Ayusha343/battery-pack-engineering/Media/20260910_121030.jpg

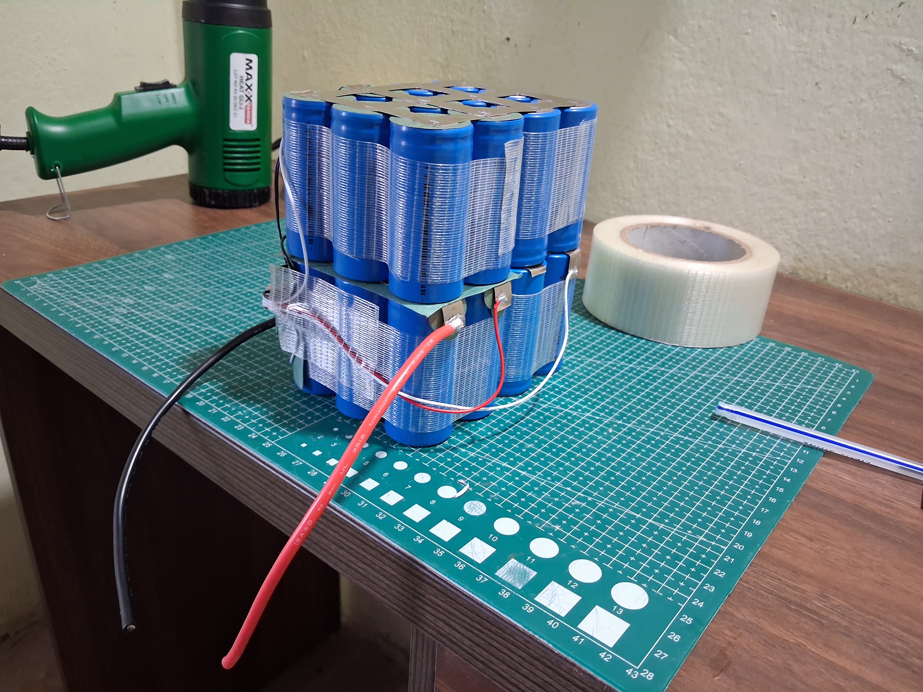
Media/20260910_121030.jpg
