Ayusha343/battery-pack-engineering/Docs/Progess_Technical_Roadmap.pptx

## Progress & Technical Roadmap

Custom NMC & LFP Pack Engineering, Field Validation, and Lab Capabilities

## Progress Report

## NMC EV Battery Pack

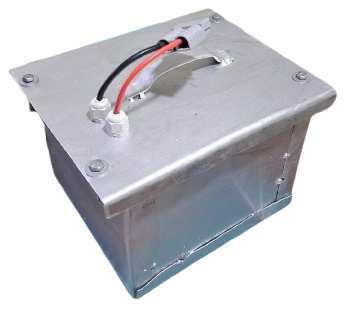
[picture p3: figure]

Pricing

Problem statement

Prototyping cost: 31,080 /-
Estimated cost: 26,599 /-

16S7P: 60V 35Ah - 2.1 kWh

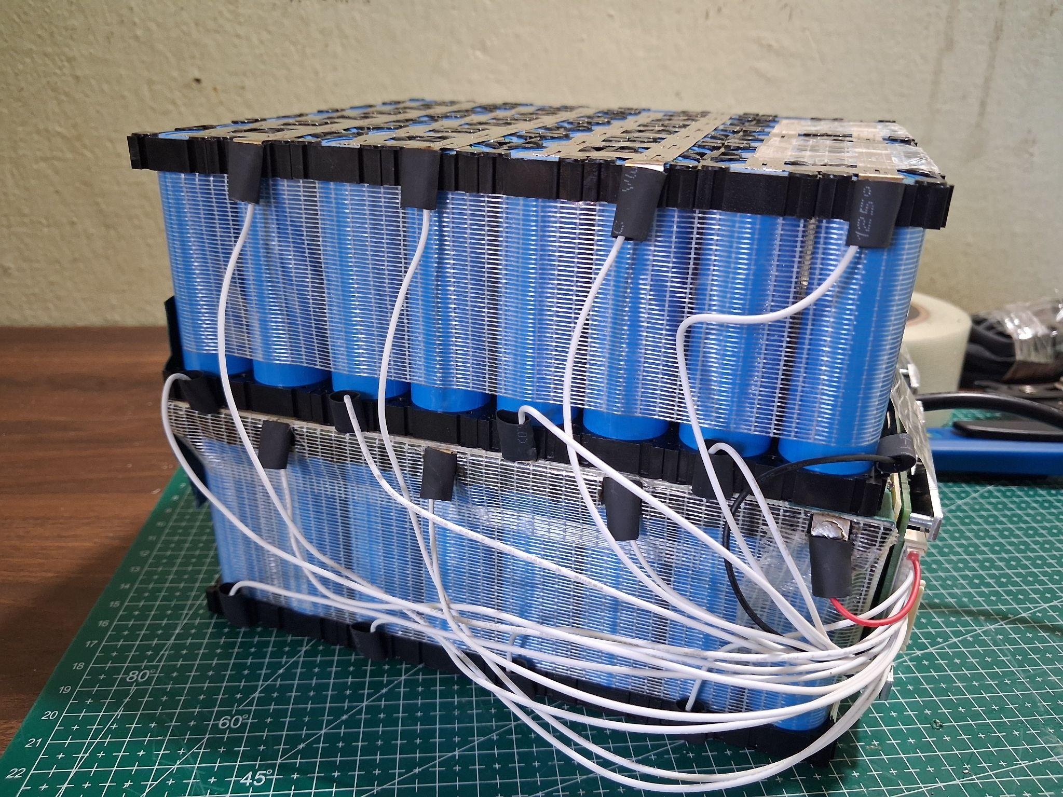
[picture p4: figure]
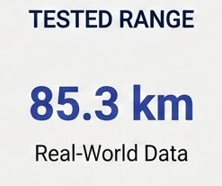
[picture p5: figure]

## LFP Solar Battery Pack

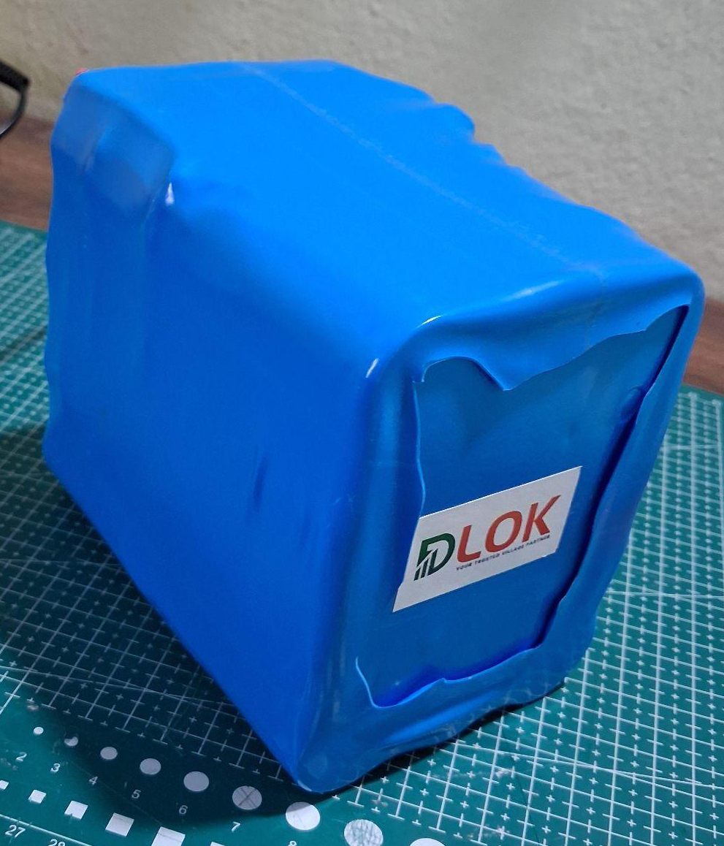
[picture p6: figure]
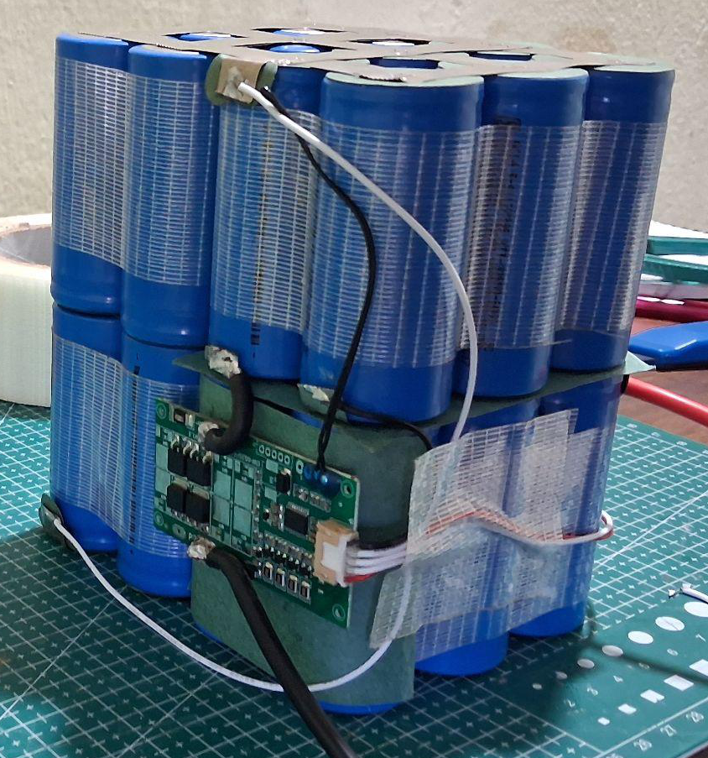
[picture p7: figure]

Pricing

Problem statement

Prototyping cost: 3,949 /-
Estimated cost: 3,800 /-

4S6P: 12.8V 36Ah - 460 Wh

Backup

Calculated Time: 11 Hrs @ 40W

## Lab Setup

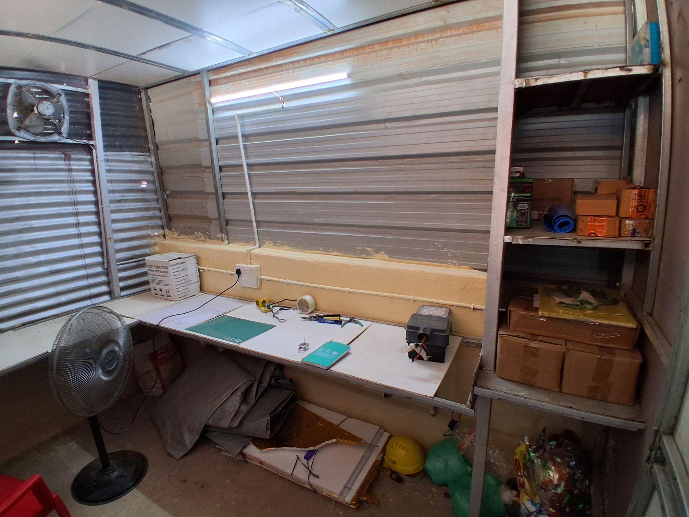
[picture p8: figure]

## Upcoming Projects

## DC Energy Meter & Logger

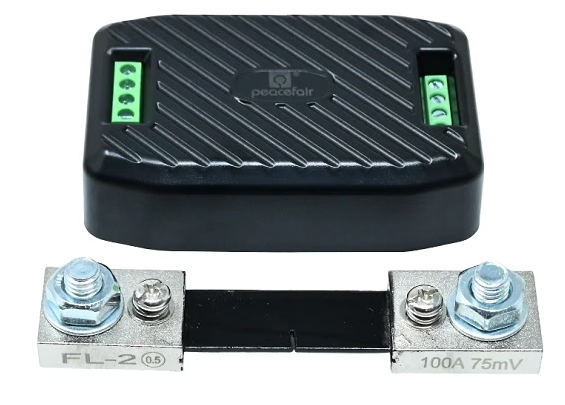
[picture p9: figure]
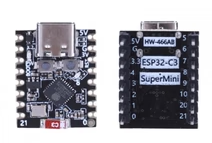
[picture p10: figure]
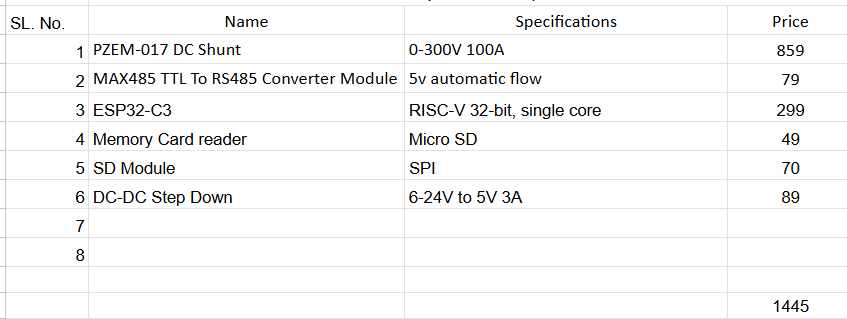
[picture p11: figure]

## LFP EV Battery Pack

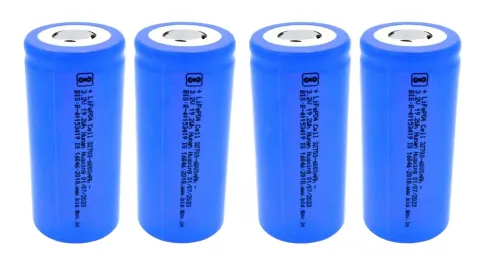
[picture p12: figure]

Pricing

Problem statement

Prototyping cost: 23,500 /-
Estimated cost: 23,000 /-

19S3P: 60V 18Ah - 1.1 kWh

19S6P: 60V 36Ah - 2.2 kWh

Range

Calculated Range: 95-100 km

19S3P: 60V 18Ah - 1.1 kWh

## Semi-Integrated Solar Light

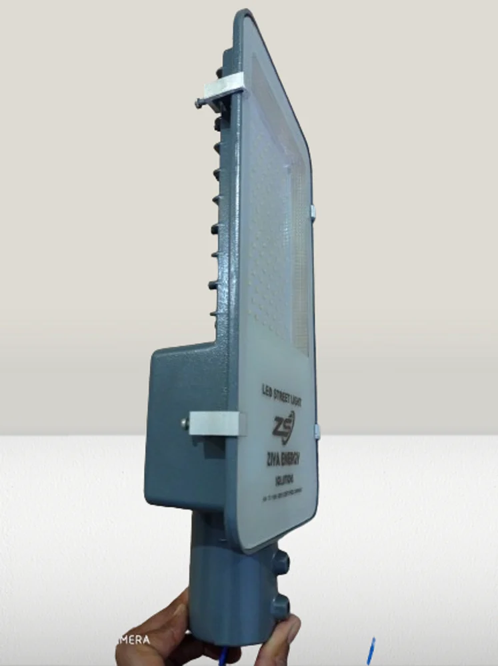
[picture p13: figure]

Pricing

Problem statement

Prototyping cost: 7,000 /-
Estimated cost: 6,500 /-

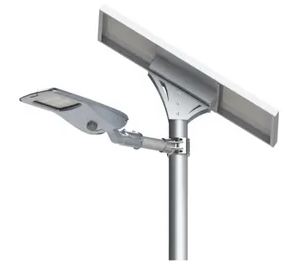
[picture p14: figure]

4S6P: 12.8V 36Ah - 460 Wh

Backup

Calculated Time: 11 Hrs @ 40W

## Suggested Roadmap

## Slide 11

Will help to collect Voltage, Current, Power [IN & OUT] data

Run a complete range test with Power Logger

Submit project documentations & SOPs

Power Logger

EV LFP 36Ah Pack

EV Battery pack testing

Solar LFP pack testing

Documentation

Make two packs of 18Ah 60.8V

Run test for few days with Power Logger data

## Thank You
