Ayusha343/battery-pack-engineering/Charts/Ayushman Sahoo - 2026-07-12 18.56.52.jpg

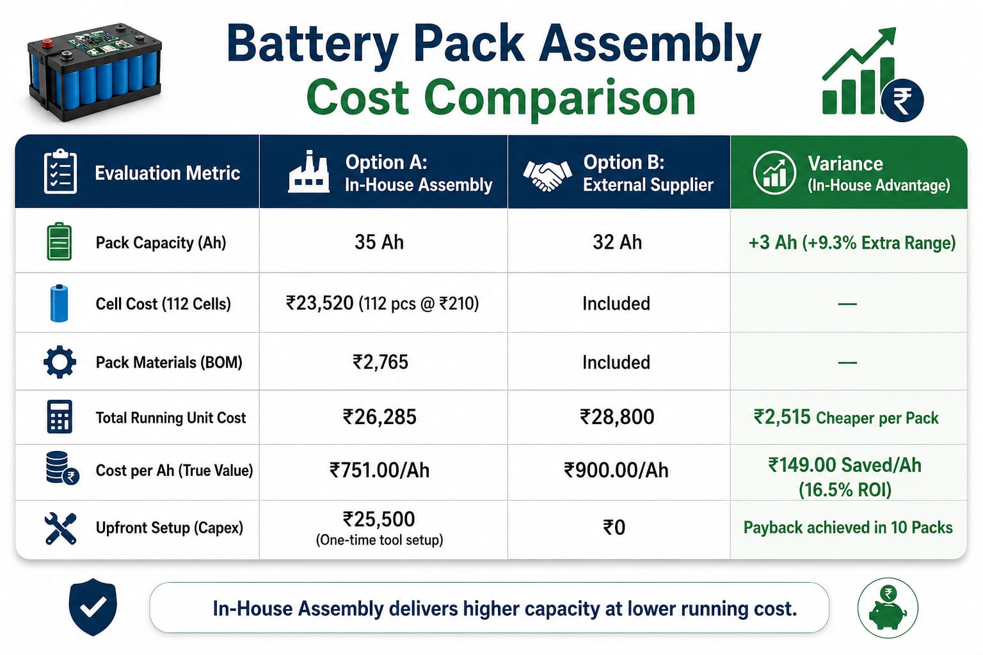
Charts/Ayushman Sahoo - 2026-07-12 18.56.52.jpg
