Ayusha343/battery-pack-engineering/Charts/Ayushman Sahoo - 2026-07-12 18.57.04.jpg

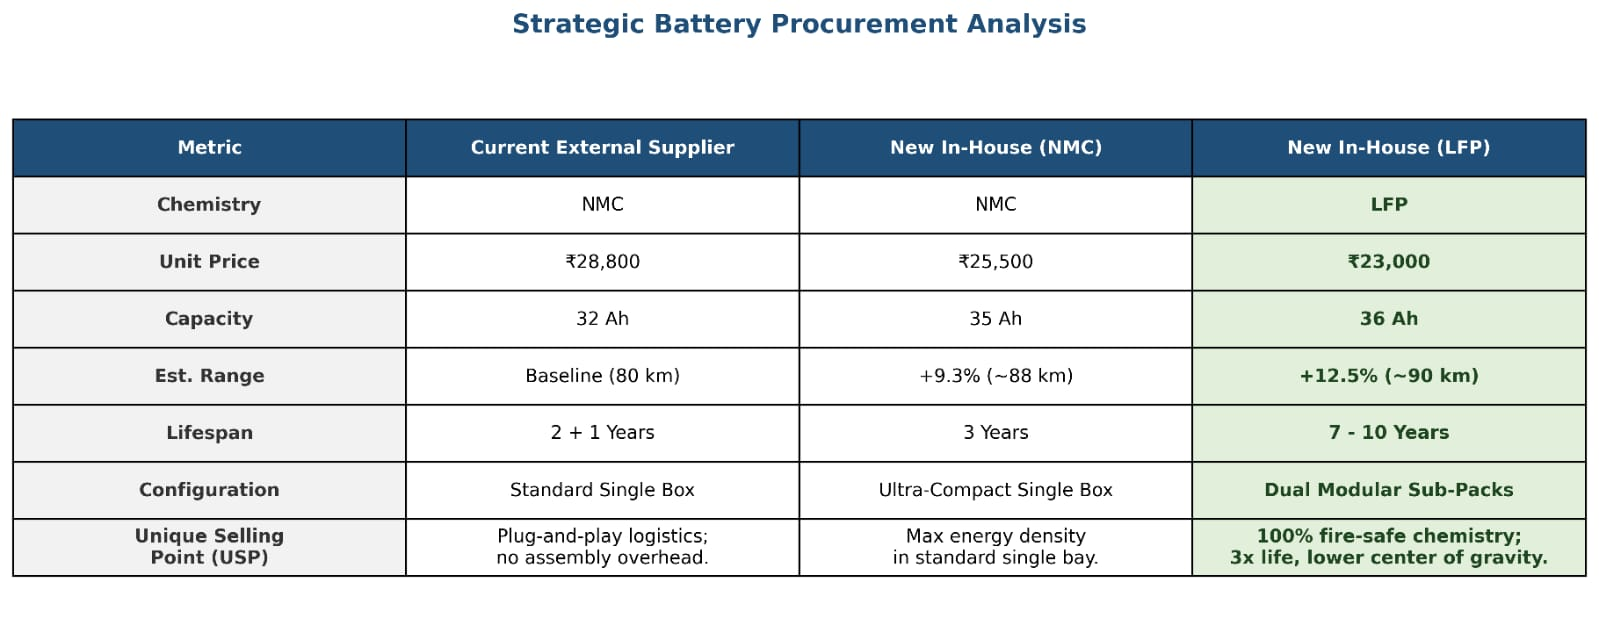
Charts/Ayushman Sahoo - 2026-07-12 18.57.04.jpg
