Ayusha343/battery-pack-engineering/Charts/ChatGPT Image Jul 13, 2026, 12_21_11 AM.png

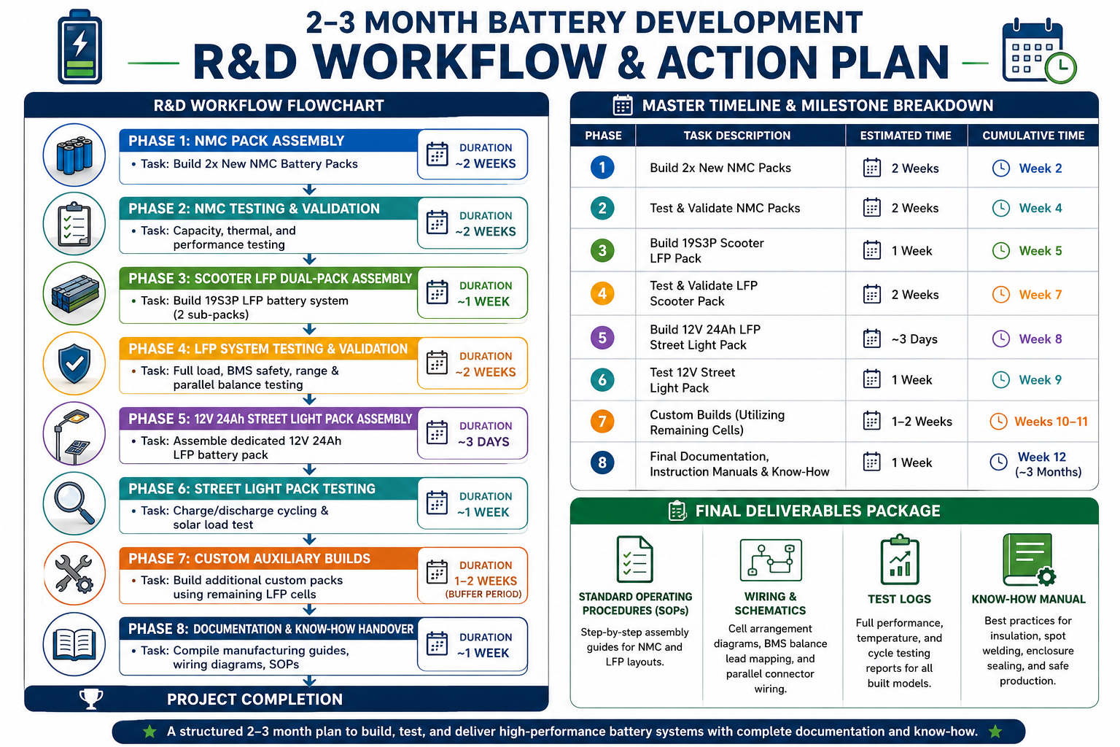
Charts/ChatGPT Image Jul 13, 2026, 12_21_11 AM.png
