Ayusha343/battery-pack-engineering/Charts/Code_Generated_Image (2).png

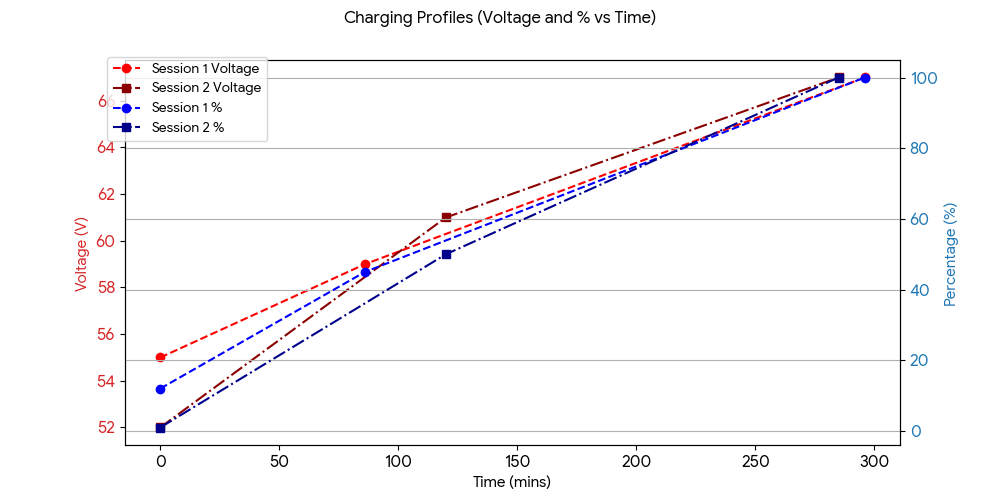
Charts/Code_Generated_Image (2).png
