Ayusha343/battery-pack-engineering/Charts/Code_Generated_Image.png

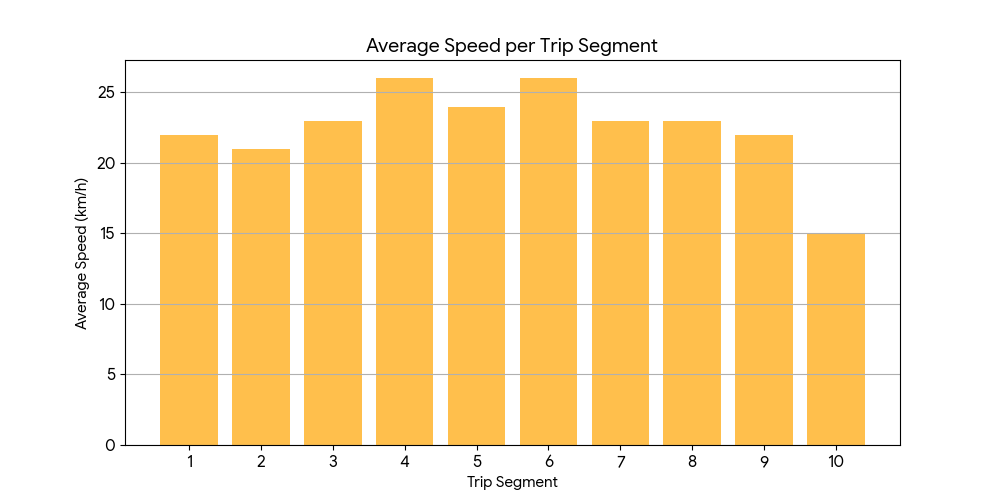
Charts/Code_Generated_Image.png
