Ayusha343/battery-pack-engineering/Invoices/Screenshot 2026-07-09 173721.png

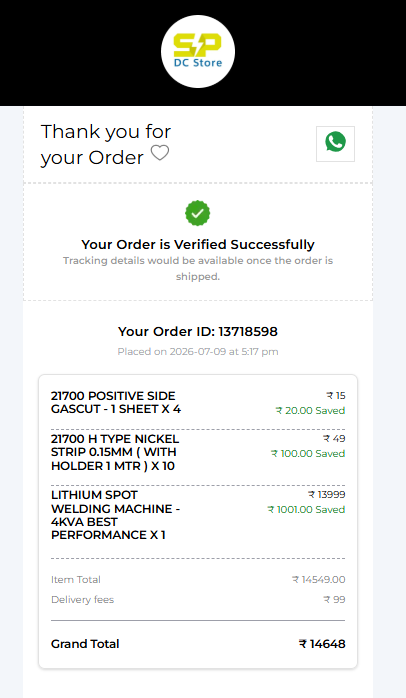
Invoices/Screenshot 2026-07-09 173721.png
