Ayusha343/battery-pack-engineering/Invoices/Screenshot 2026-07-09 174720.png

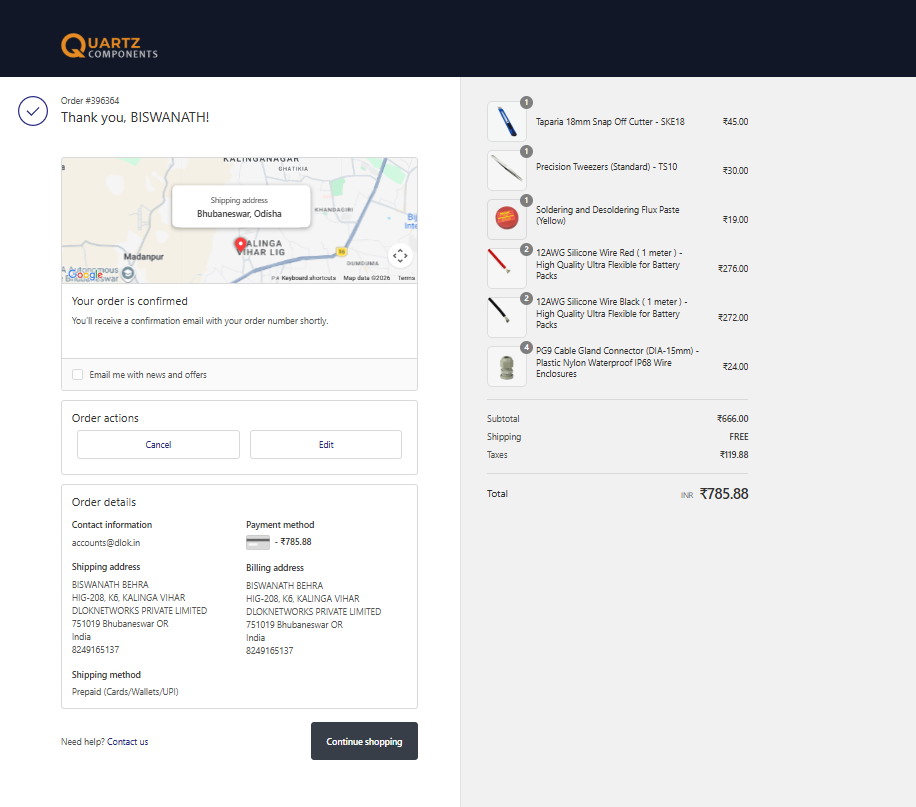
Invoices/Screenshot 2026-07-09 174720.png
