Ayusha343/battery-pack-engineering/Invoices/Screenshot 2026-07-09 174733.png

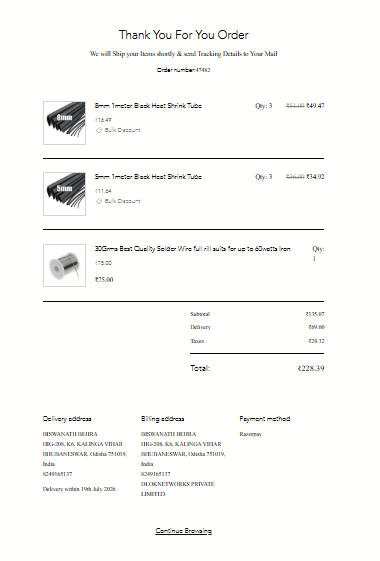
Invoices/Screenshot 2026-07-09 174733.png
