Ayusha343/battery-pack-engineering/Invoices/Screenshot 2026-07-13 133432.png

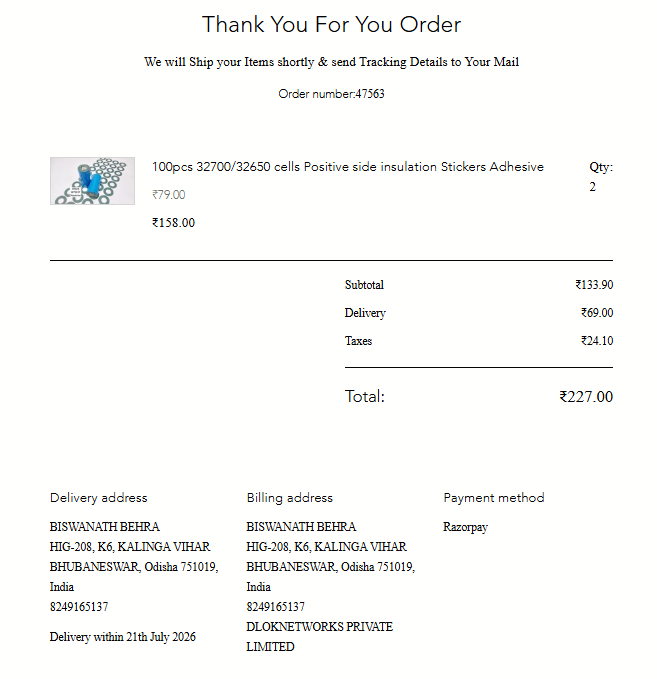
Invoices/Screenshot 2026-07-13 133432.png
