Ayusha343/battery-pack-engineering/Invoices/Screenshot 2026-07-15 133346.png

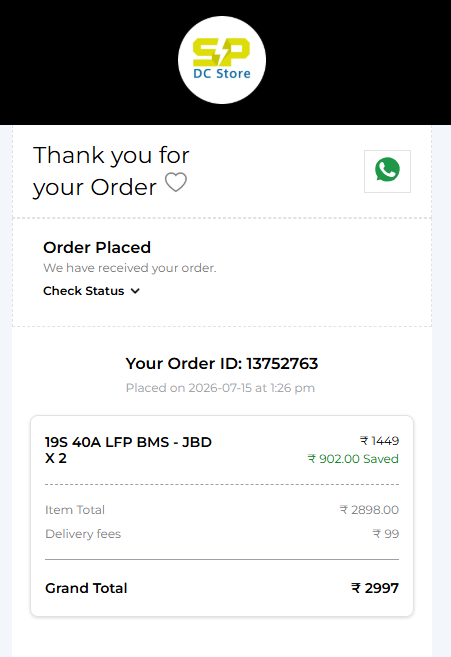
Invoices/Screenshot 2026-07-15 133346.png
