Ayusha343/battery-pack-engineering/Invoices/Screenshot 2026-08-13 130806.png

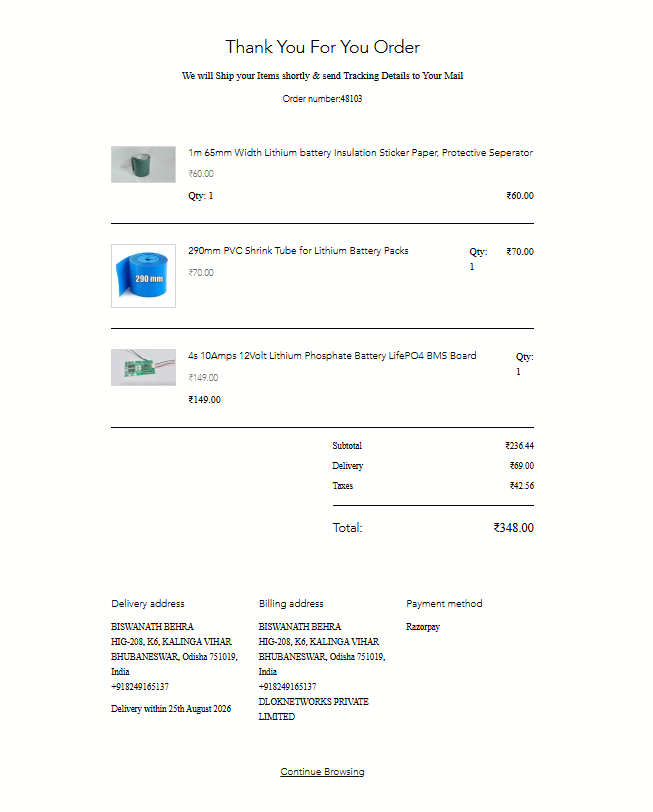
Invoices/Screenshot 2026-08-13 130806.png
