Ayusha343/battery-pack-engineering/Media/20260719_194118.jpg

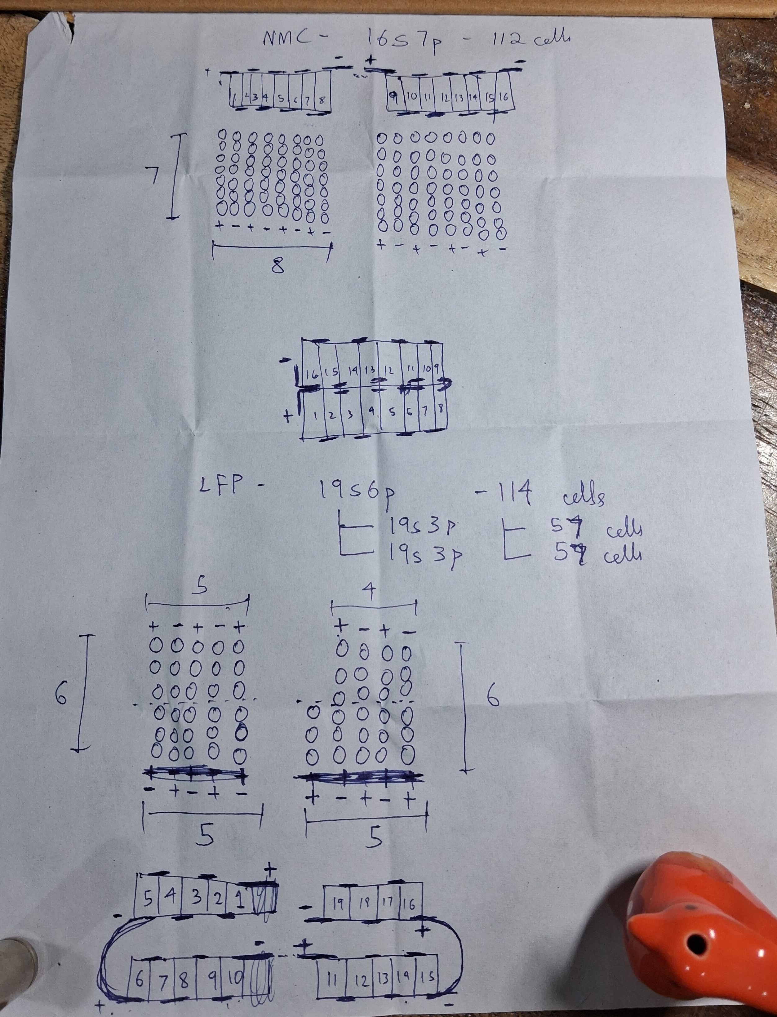
Media/20260719_194118.jpg
