Ayusha343/battery-pack-engineering/Media/20260722_124656.jpg

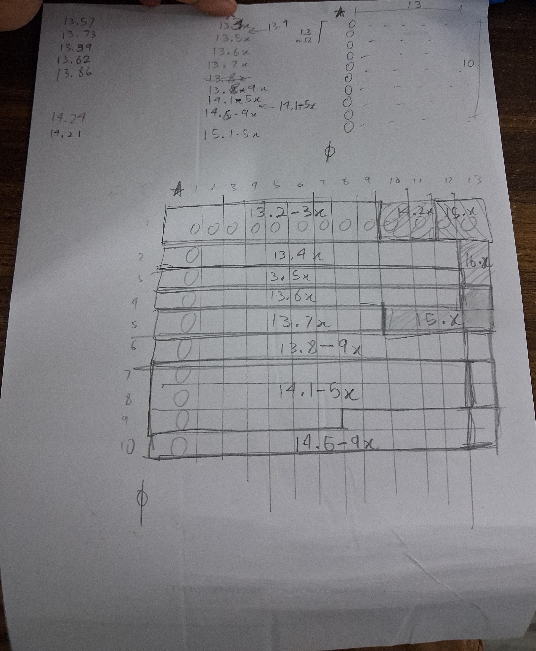
Media/20260722_124656.jpg
