Ayusha343/battery-pack-engineering/Media/20260722_135739.jpg

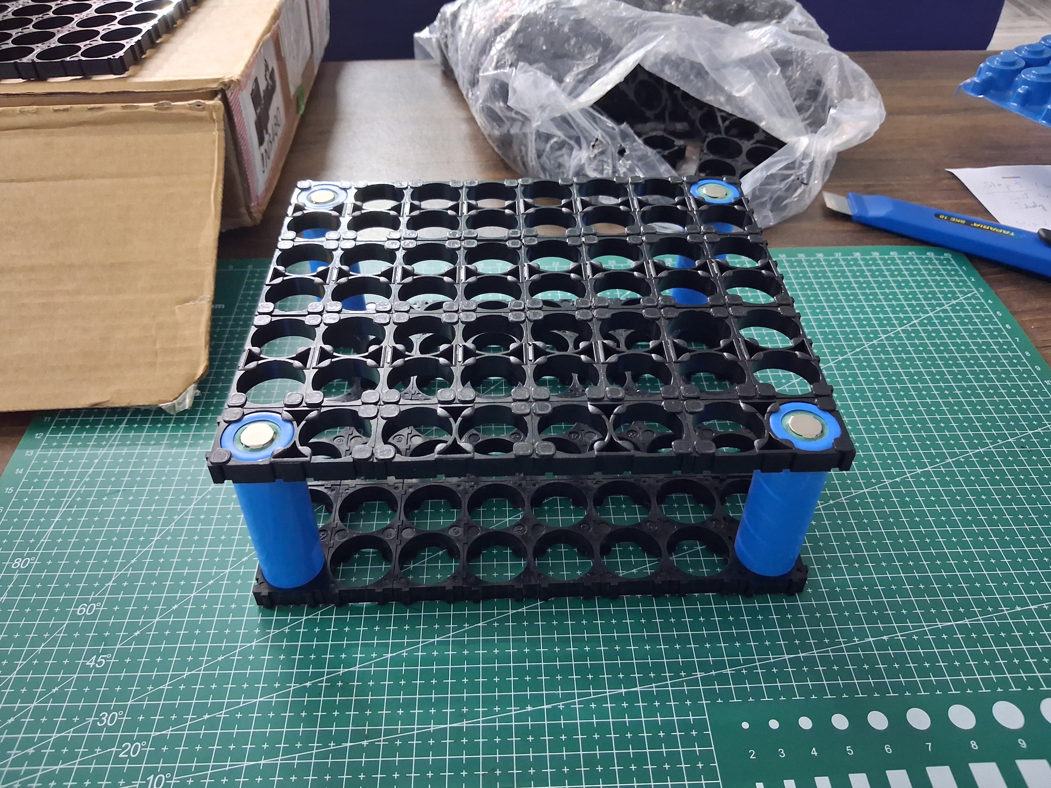
Media/20260722_135739.jpg
