Ayusha343/battery-pack-engineering/Media/20260722_140135.jpg

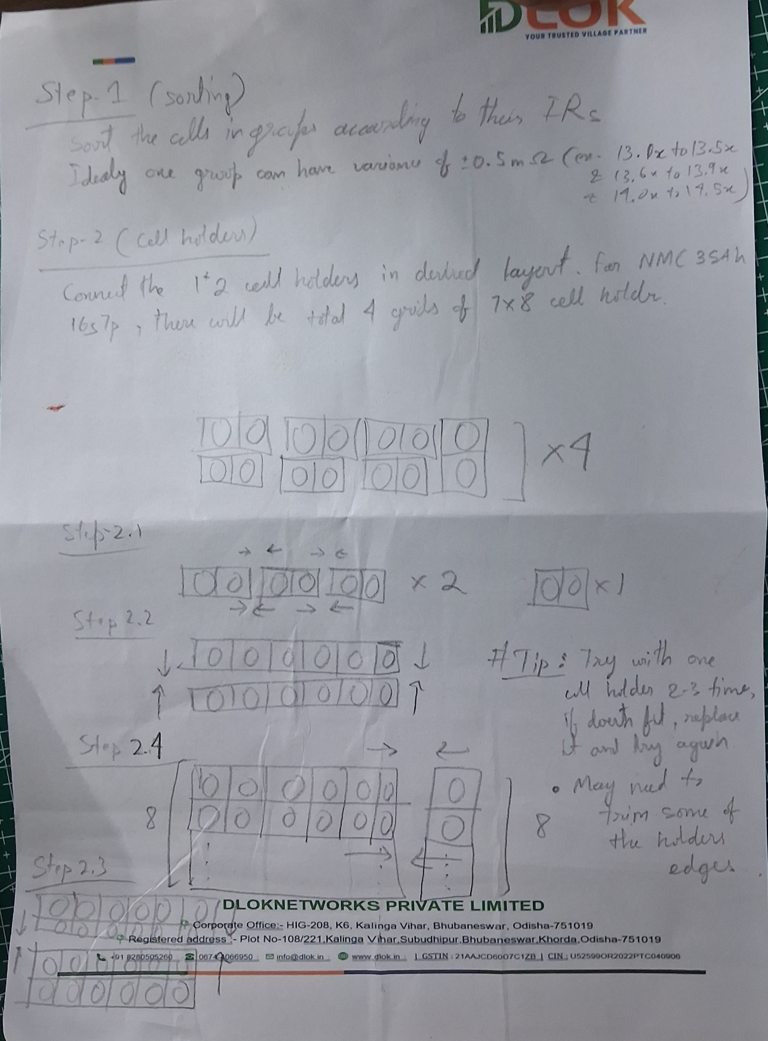
Media/20260722_140135.jpg
