Ayusha343/battery-pack-engineering/Media/20260727_133029.jpg

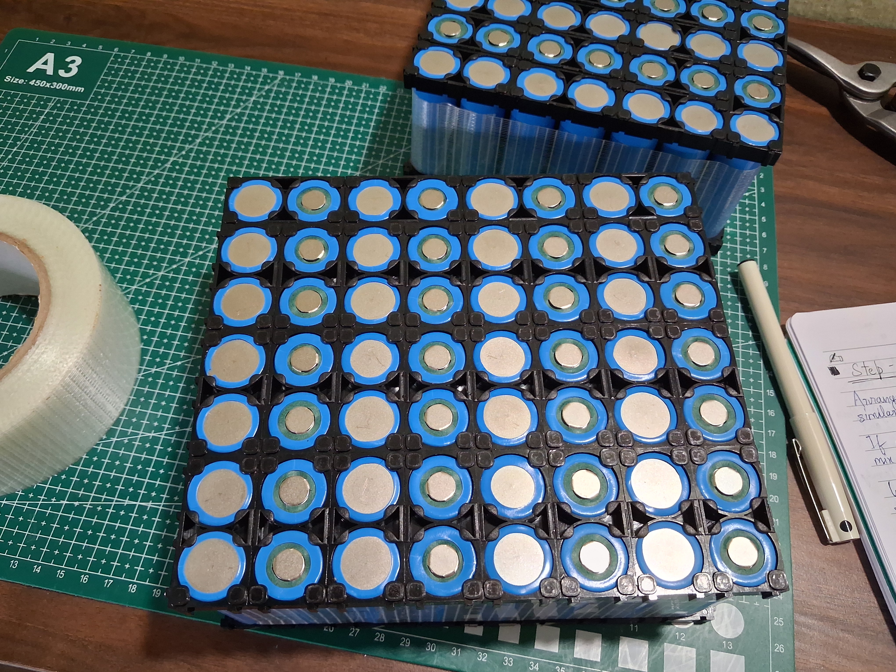
Media/20260727_133029.jpg
