Ayusha343/battery-pack-engineering/Media/20260728_140951.jpg

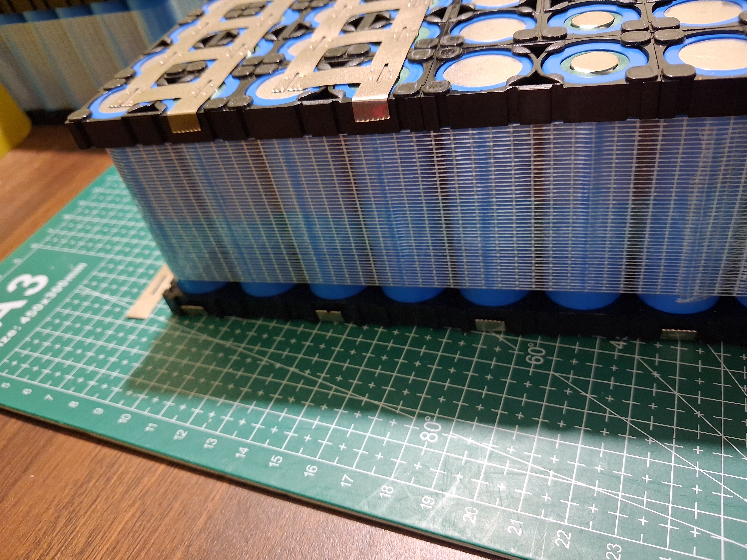
Media/20260728_140951.jpg
