Ayusha343/battery-pack-engineering/Media/20260728_141614.jpg

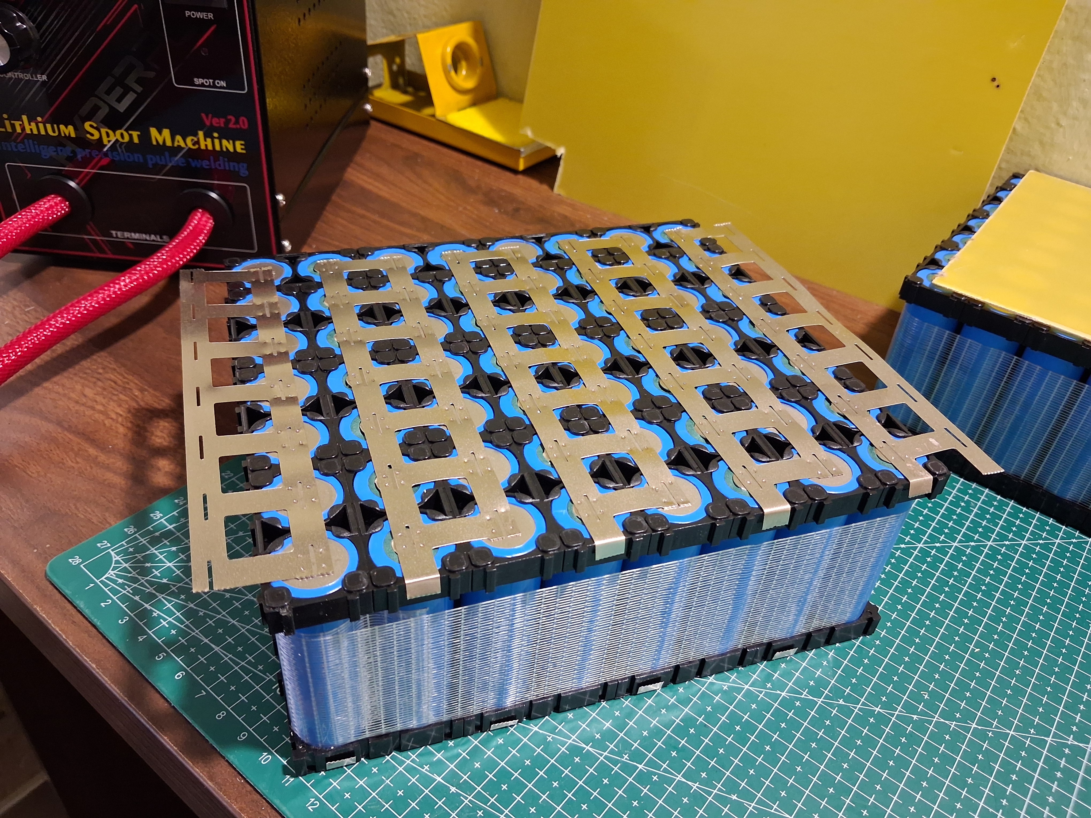
Media/20260728_141614.jpg
