Ayusha343/battery-pack-engineering/Media/20260728_141623(0).jpg

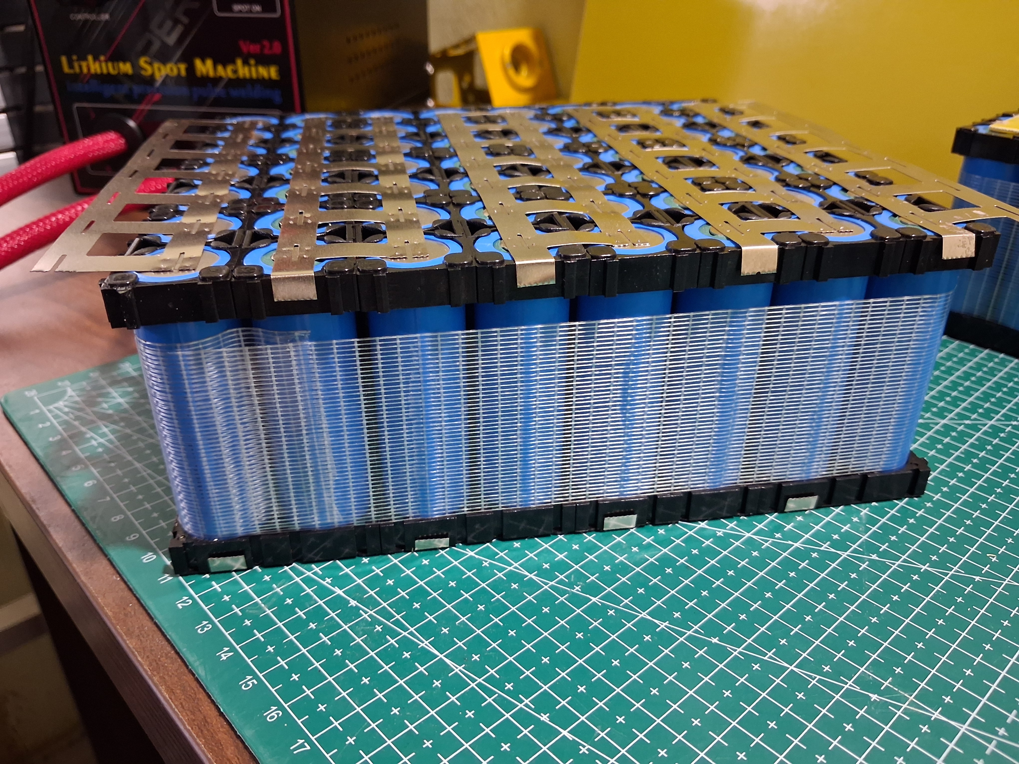
Media/20260728_141623(0).jpg
