Ayusha343/battery-pack-engineering/Media/20260729_121017.jpg

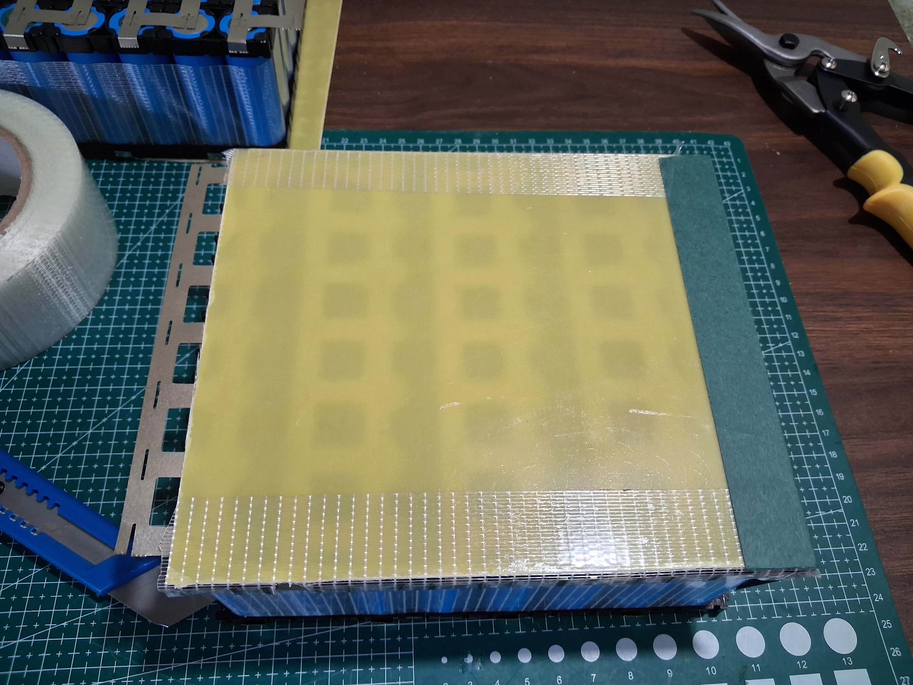
Media/20260729_121017.jpg
