Ayusha343/battery-pack-engineering/Media/20260729_121023.jpg

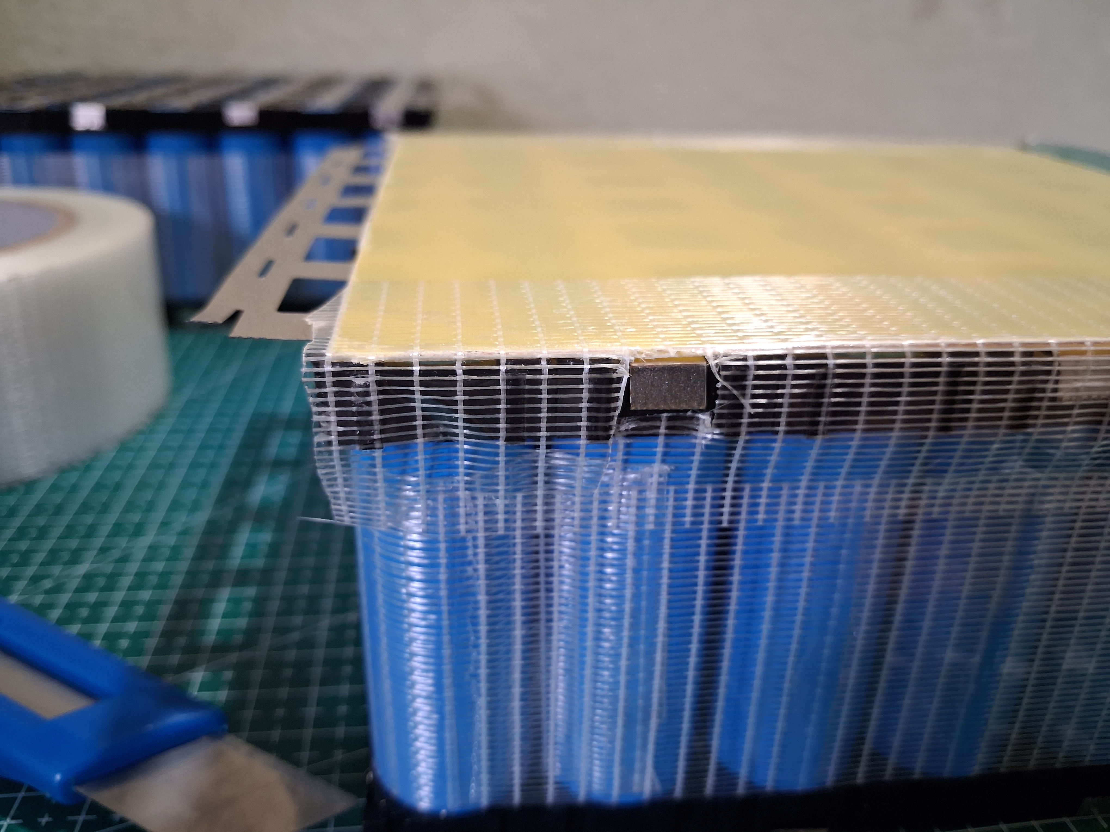
Media/20260729_121023.jpg
