Ayusha343/battery-pack-engineering/Media/20260729_121026.jpg

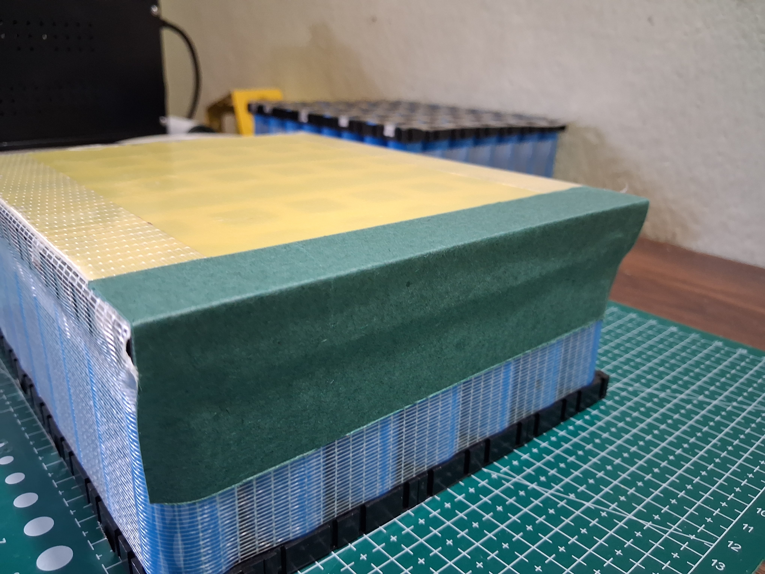
Media/20260729_121026.jpg
