Ayusha343/battery-pack-engineering/Media/20260729_122357.jpg

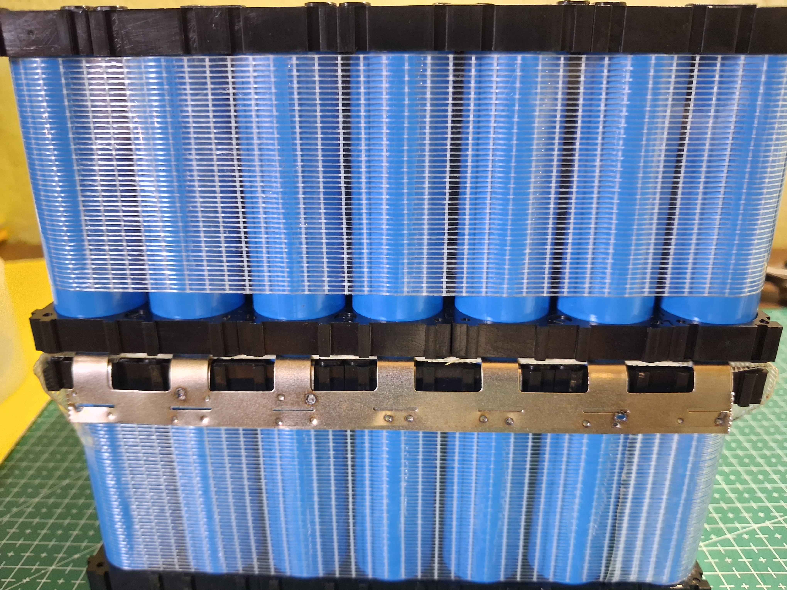
Media/20260729_122357.jpg
