Ayusha343/battery-pack-engineering/Media/20260729_122847.jpg

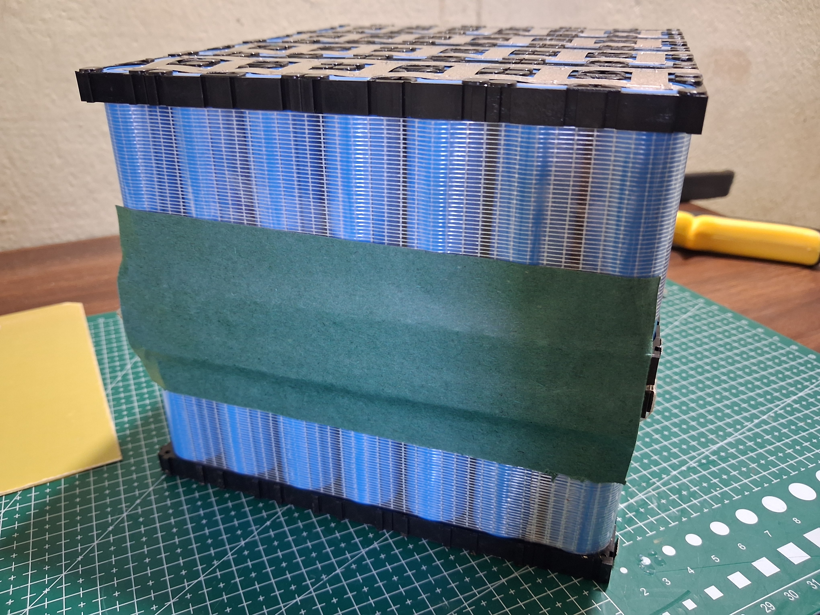
Media/20260729_122847.jpg
