Ayusha343/battery-pack-engineering/Media/20260729_123937.jpg

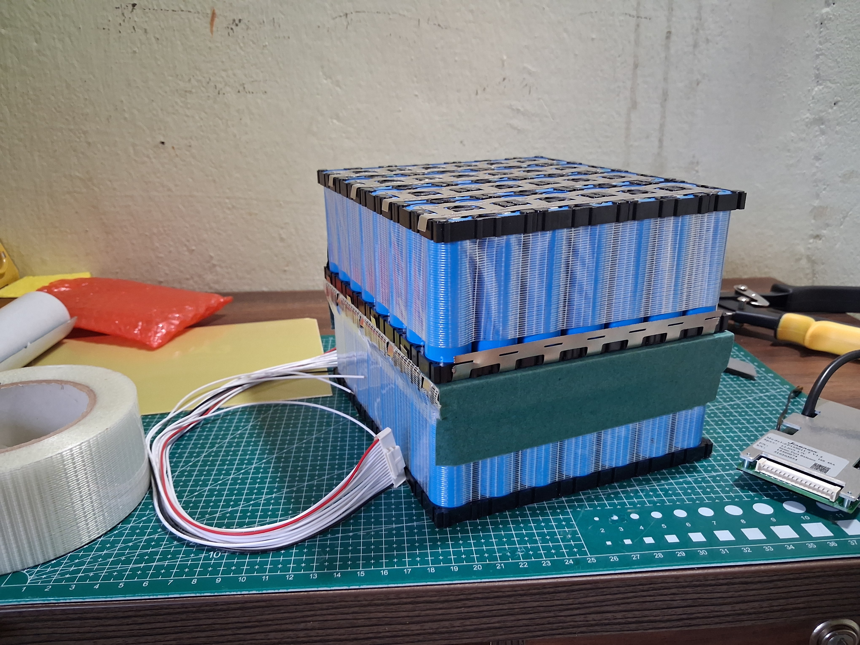
Media/20260729_123937.jpg
