Ayusha343/battery-pack-engineering/Media/20260729_141145.jpg

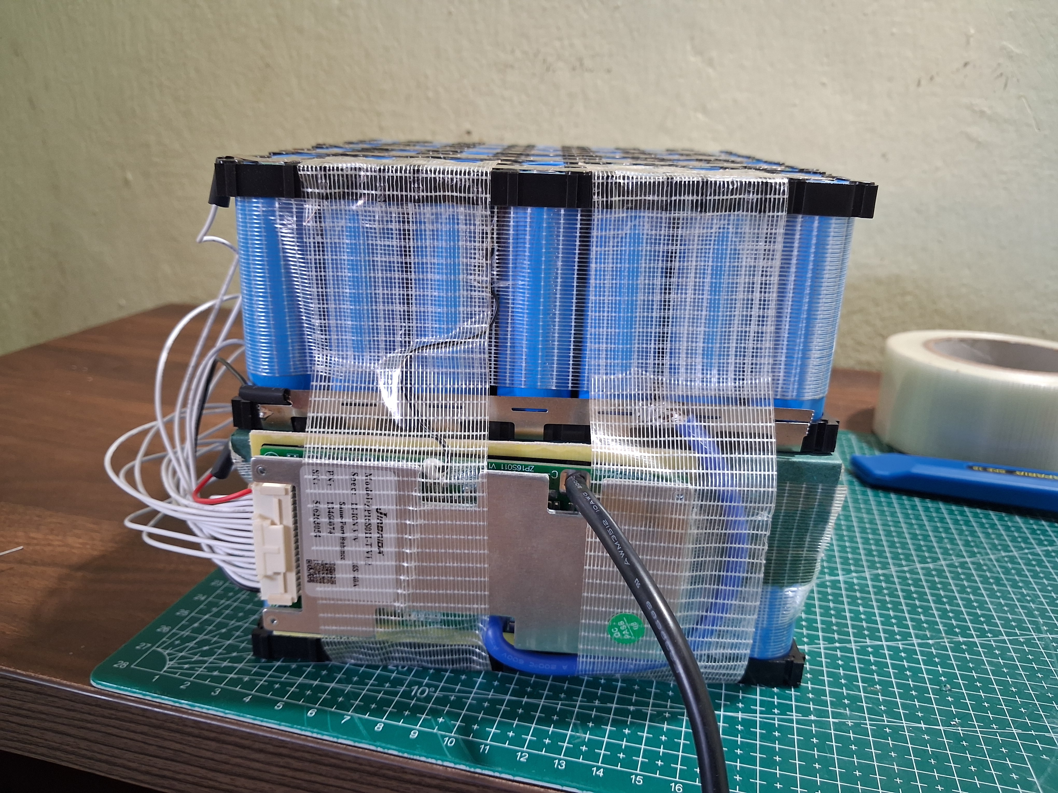
Media/20260729_141145.jpg
