Ayusha343/battery-pack-engineering/Media/20260730_125153.jpg

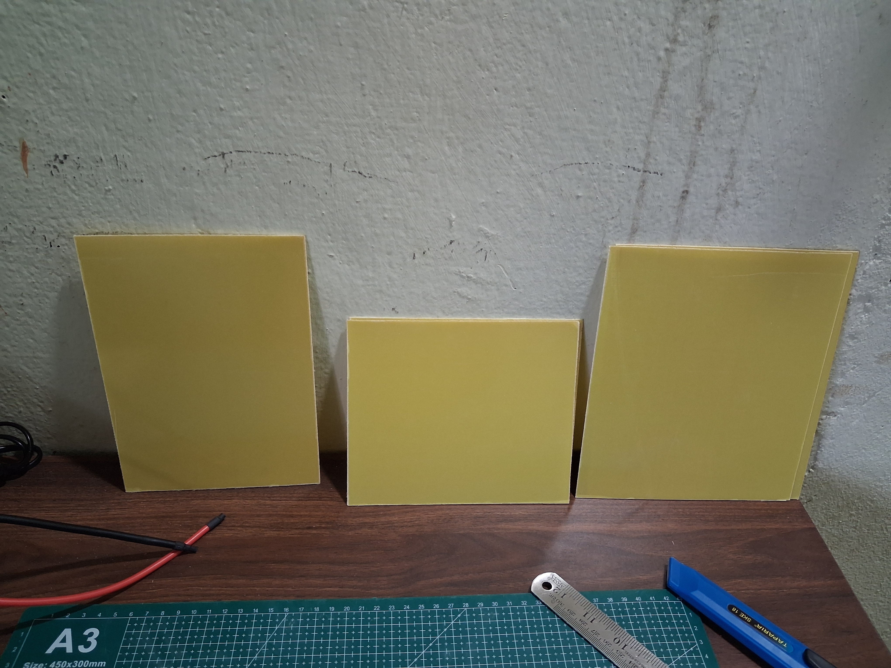
Media/20260730_125153.jpg
