Ayusha343/battery-pack-engineering/Media/20260730_125158.jpg

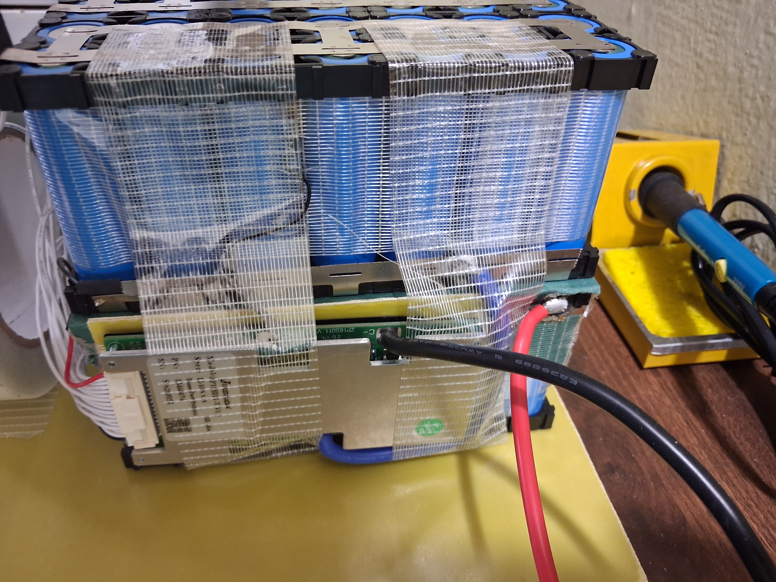
Media/20260730_125158.jpg
