Ayusha343/battery-pack-engineering/Media/20260730_131058.jpg

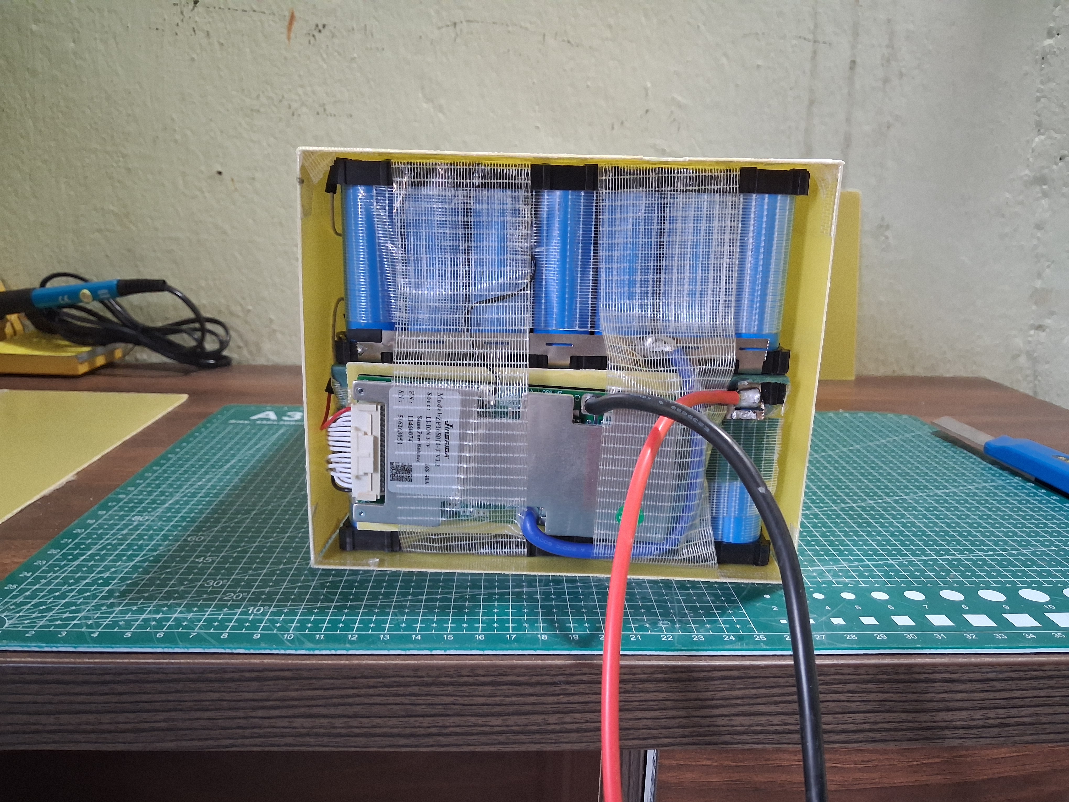
Media/20260730_131058.jpg
