Ayusha343/battery-pack-engineering/Media/20260730_131102.jpg

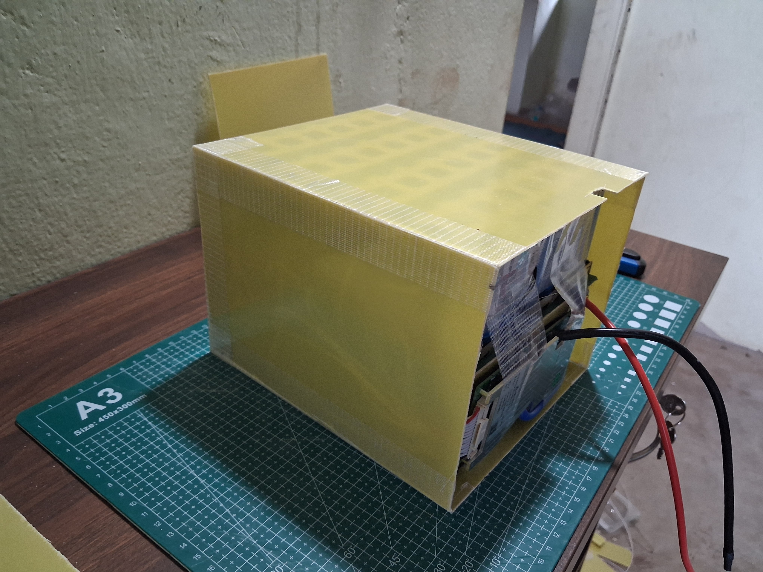
Media/20260730_131102.jpg
