Ayusha343/battery-pack-engineering/Media/20260730_141120.jpg

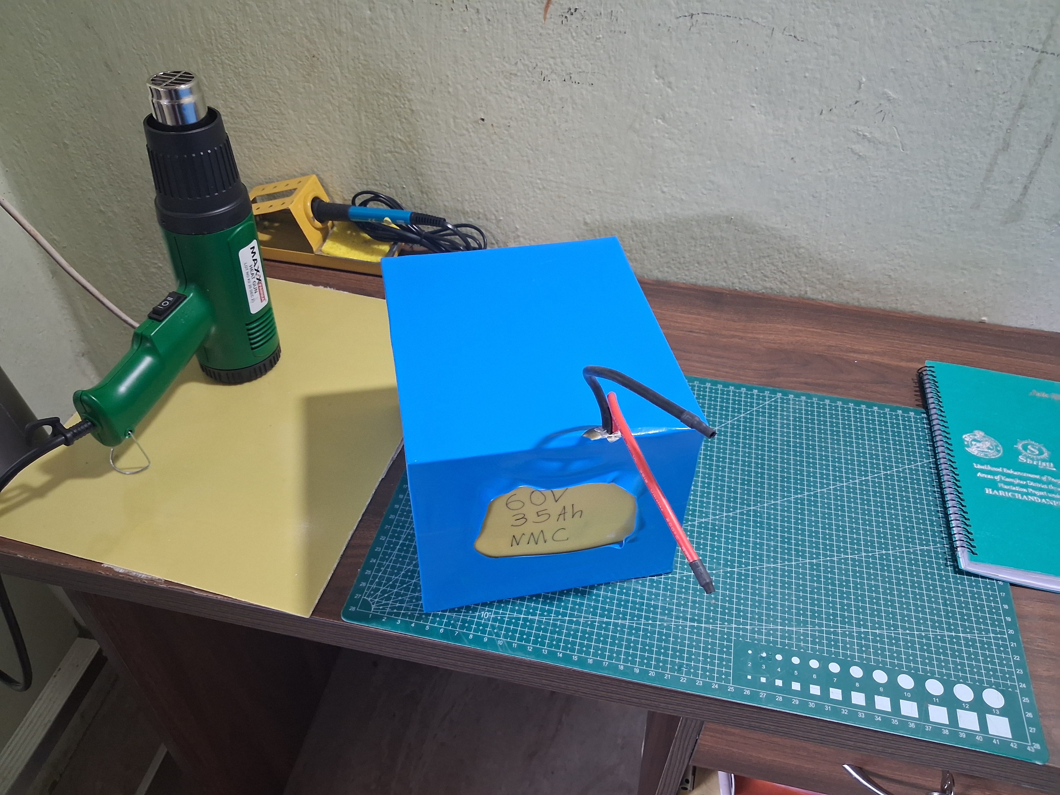
Media/20260730_141120.jpg
