Ayusha343/battery-pack-engineering/Media/20260730_141123.jpg

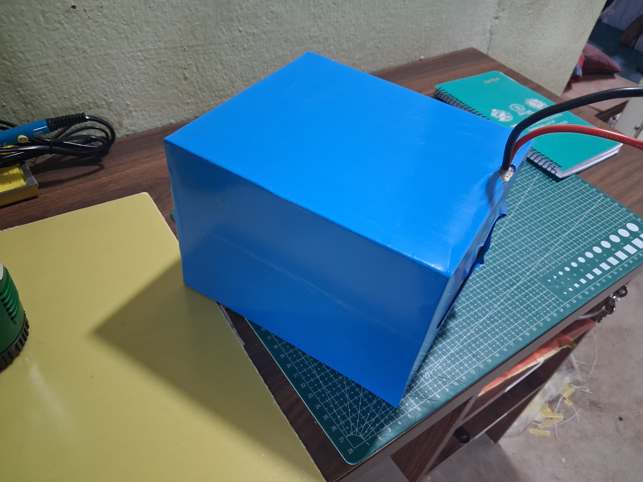
Media/20260730_141123.jpg
