Ayusha343/battery-pack-engineering/Media/20260807_105924.jpg

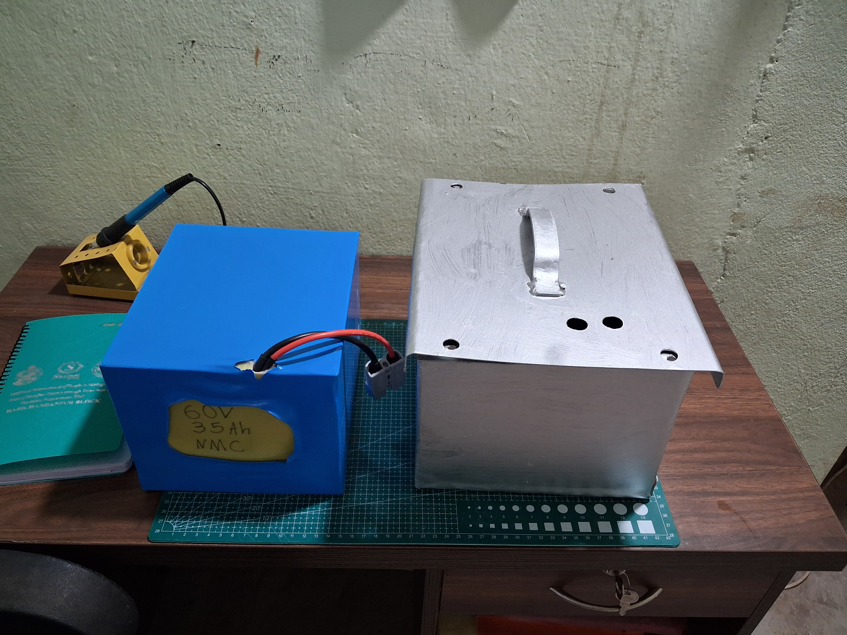
Media/20260807_105924.jpg
