Ayusha343/battery-pack-engineering/Media/20260907_120238.jpg

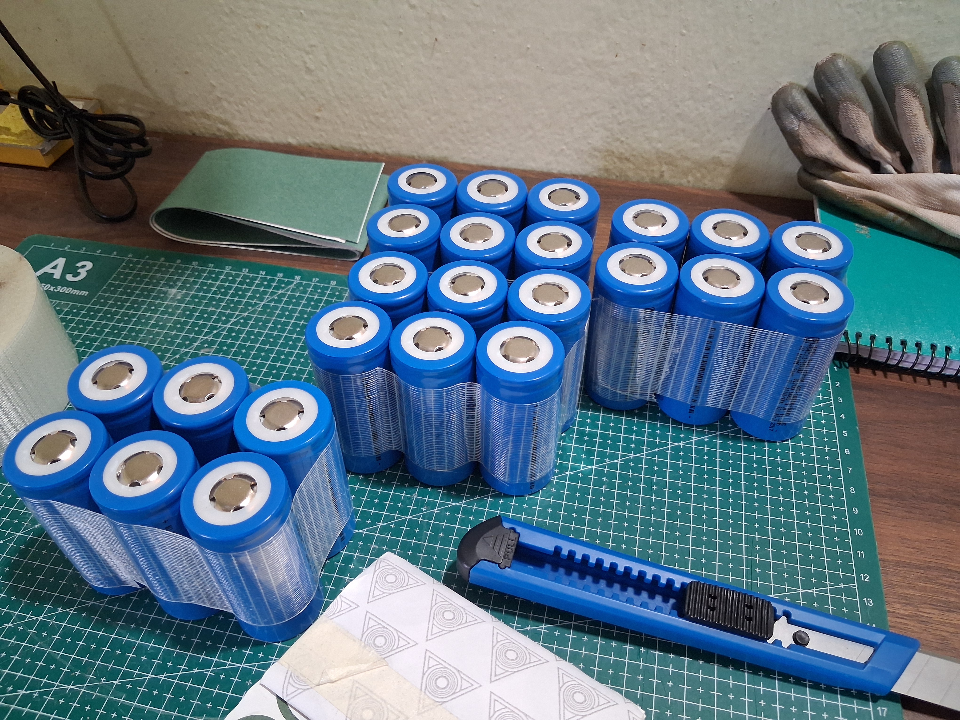
Media/20260907_120238.jpg
