Ayusha343/battery-pack-engineering/Media/20260907_121606.jpg

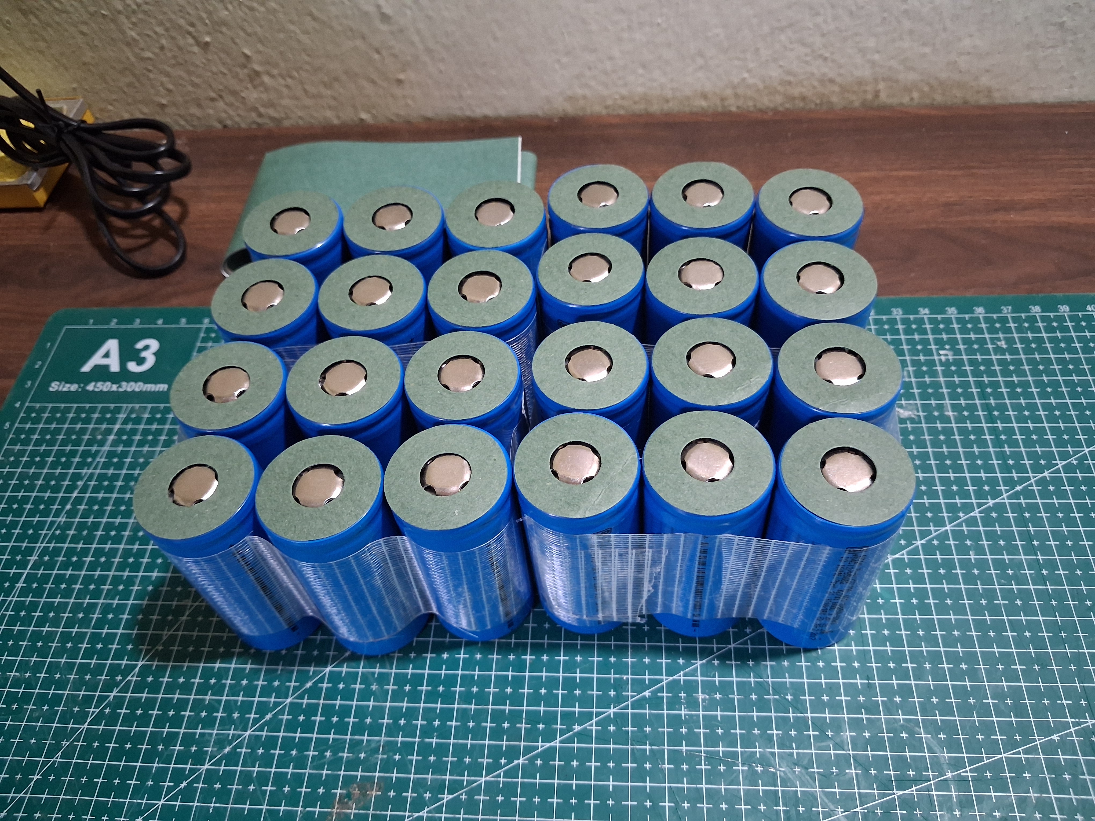
Media/20260907_121606.jpg
