Ayusha343/battery-pack-engineering/Media/20260907_130915.jpg

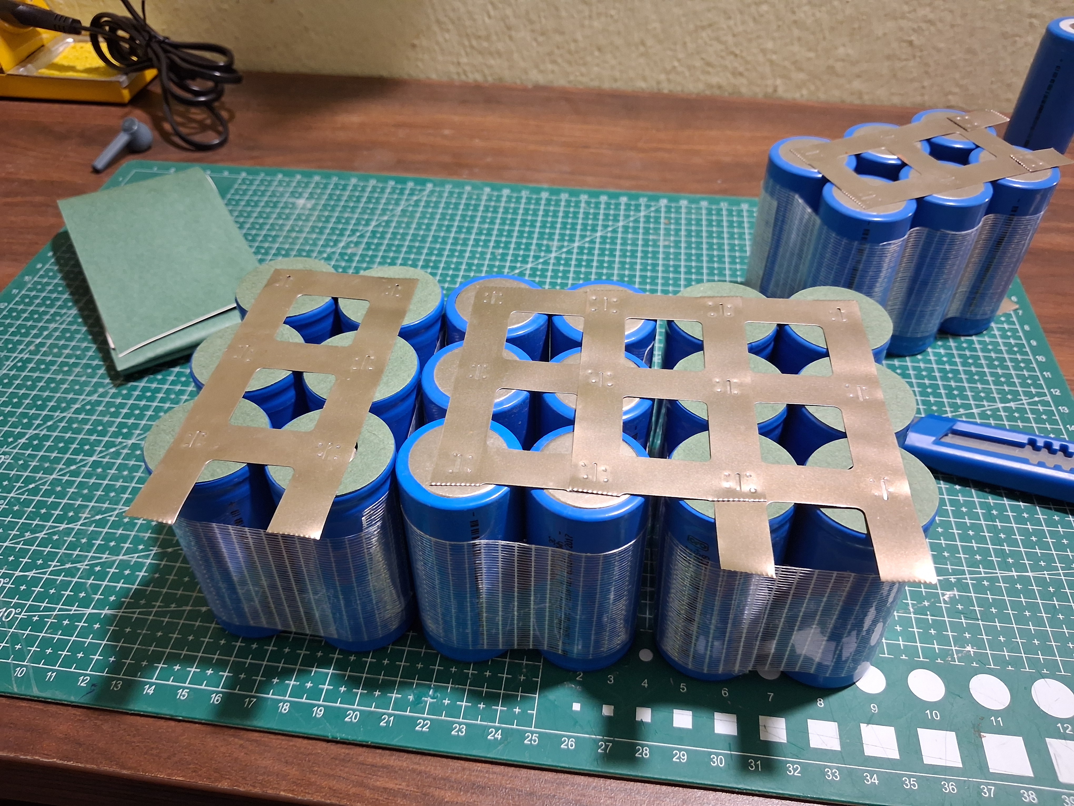
Media/20260907_130915.jpg
