Ayusha343/battery-pack-engineering/Media/20260907_132644.jpg

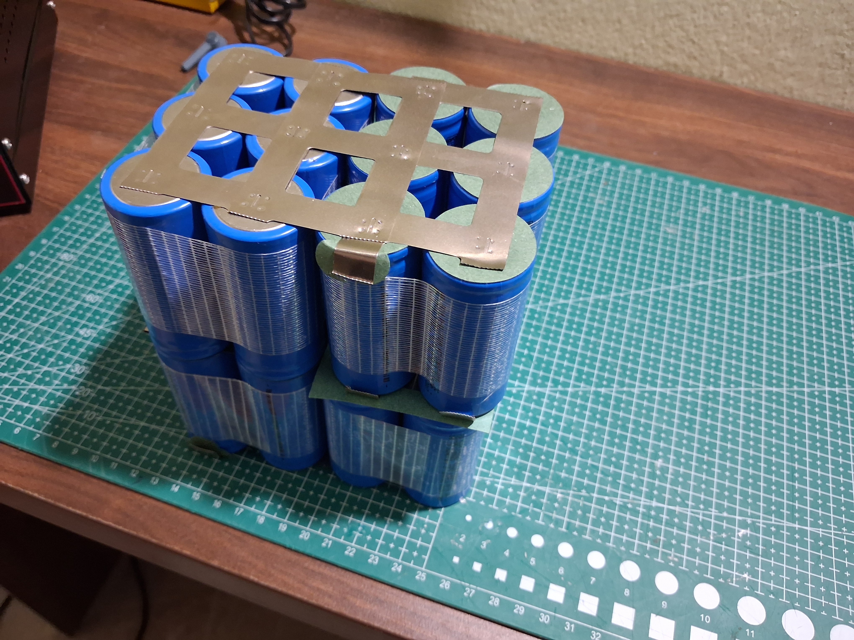
Media/20260907_132644.jpg
