Ayusha343/battery-pack-engineering/Media/20260910_122916.jpg

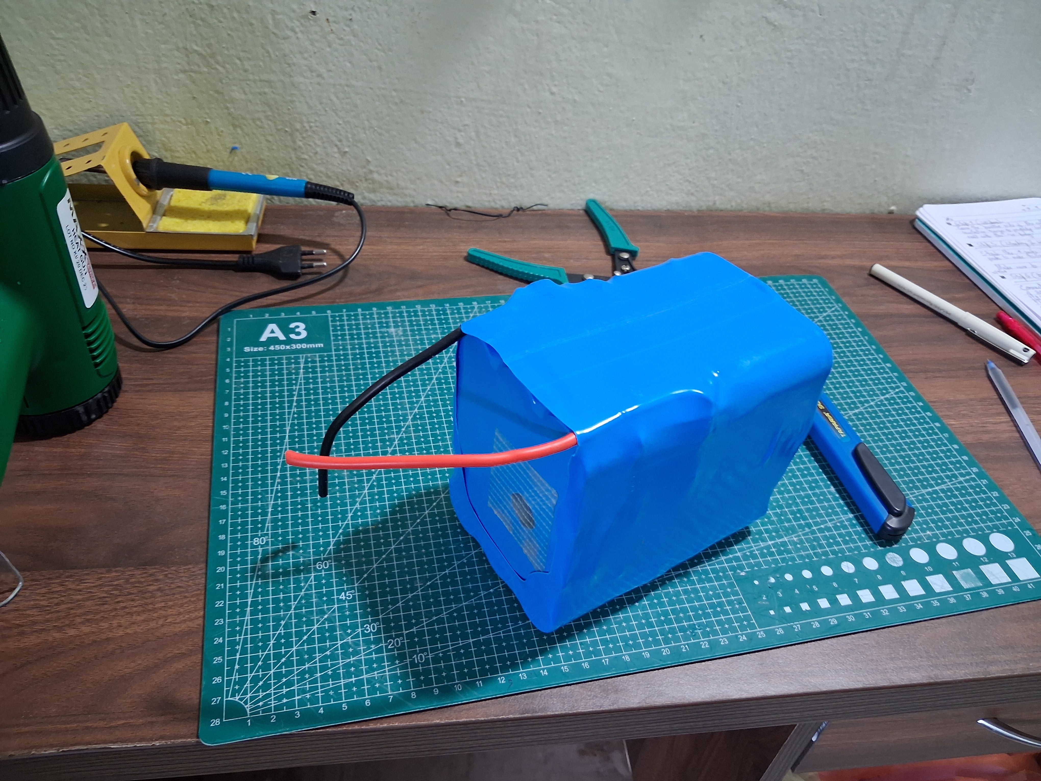
Media/20260910_122916.jpg
