Ayusha343/battery-pack-engineering/Media/ayusha343_HIXR3Wp2Epv8owIpMGOvaLqJ47gqq1RWR41cKH3GG8gFmyKDbchXKeoZL4YtCAsZ-removebg-preview.png

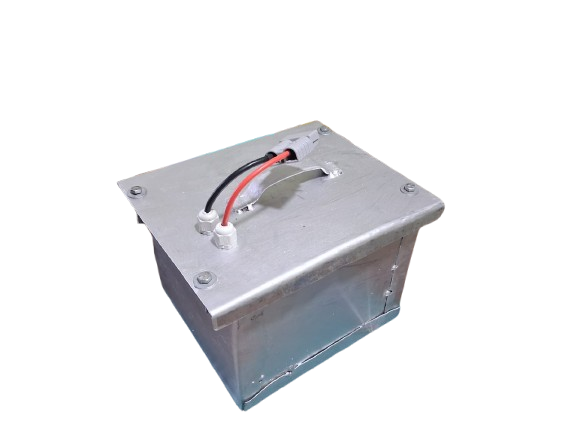
Media/ayusha343_HIXR3Wp2Epv8owIpMGOvaLqJ47gqq1RWR41cKH3GG8gFmyKDbchXKeoZL4YtCAsZ-removebg-preview.png
