Ayusha343/battery-pack-engineering/Media/IMG-20260808-WA0000.jpeg

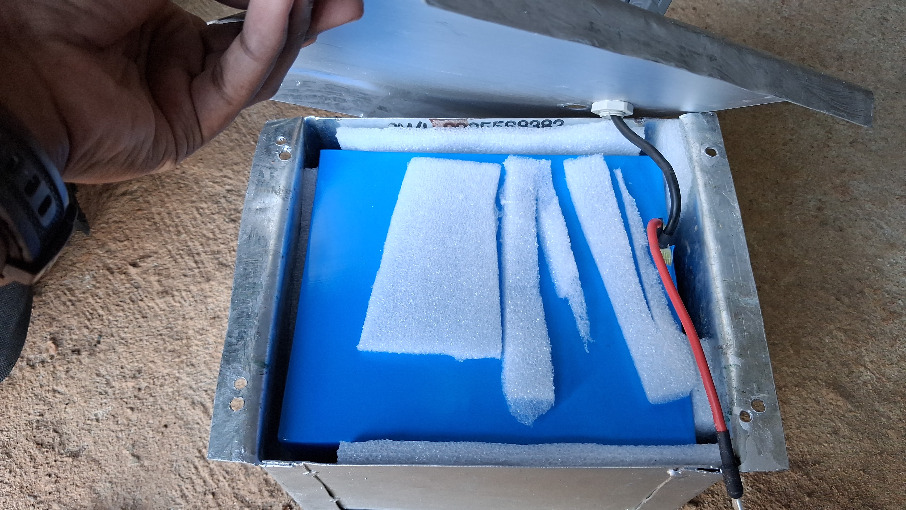
Media/IMG-20260808-WA0000.jpeg
