Ayusha343/battery-pack-engineering/Docs/Electric Cycle Specification.xlsx

Electric Cycle (Dual Disc Brakes, 350w Hub Motor, 8.5Ah Li-Ion Battery, Throttle with Battery Indicator, 95% Pre-Assembled with Charger, Black Color,Fat Tyre)
Number Of Speeds | Five | Frame Material Type | Chromoly Steel
Suspension Type | Front | Wheel Material | Nylon
Special Features | Rechargeable | Seat Material Type | steel
Brake Style | Disc | Fender Material | Steel
Specific Uses For Product | Daily commuting, Running errands, Recreational riding | Warranty Type | Limited
Power Source | Battery | Maximum Weight Recommendation | 110 Kilograms
Wattage | 220 Watts | Is Assembly Required | No
Lithium Battery Energy Content | 280.8 Watt Hours | Minimum User Height | 4.5 Feet
Bicycle Gear Shifter Type | Twist Grip | Wheel Size | 20 Inches
Bicycle Drivetrain Type | Direct Drive | Size | Standard
Electric Assist Type | Electric Assist | Wheel Width | 20 Inches
Battery Life | 35 Operations | Item Weight | 35 Kilograms
Number of Handles | One | Seatpost Travel Distance Maximum | 30 Kilometres
