Ayusha343/battery-pack-engineering/Docs/DLOK internship.xlsx

Sheet: BAK 59.2V 35Ah
 | Necessary minimum expenses
SL. No. | Name | Specifications | Price | Link | Offline | Ordered
1 | BAK Cells | 21700 NMC 5000mAh (250x112) | 28000 | 70291 81970 |  | YES
2 | BMS | NMC 60V 40A JBD | 885 | 97196 76098 |  | YES
3 | PVC Shrink Tube for Lithium Battery Packs | 300mm | 65 | PVC Wrap (https://vipultech.in/product/300mm-heat-shrink-tube-for-lithium-battery/?attribute_length=1m) |  | YES
4 | 21700 Battery Cell Holder | 1*2 (120x4) | 424.8 | 97196 76098 |  | YES
5 | Positive side insulation Stickers Adhesive | 120 pcs | 30 | Stciker (https://www.spdcstore.in/product/33058764/21700-POSITIVE-SIDE-GASCUT---1-SHEET) |  | YES
6 | 1 meter H shape Pure Nickel Strip | 5m H shape | 245 | Nickel (https://www.spdcstore.in/product/32896608/21700-H-TYPE-NICKEL-STRIP-0-15MM---WITH-HOLDER-1-MTR---) |  | YES
7 | Anderson Connector | SB50 50A | 89 | SB50 (https://vipultech.in/product/600v-50a-power-connector-sb50/) |  | YES
8 | Case | 170x195x350mm | 1000 | 96503 94021 |  | NO
9 | Epoxy sheet | 350mmx250mm x 6sheets | 329 | Sheet (https://vipultech.in/product/1mm-epoxy-fiber-sheet-for-lithium-battery-pack-300x400-mm-1kg-2/) |  | YES
10 | Nylon Gland | PG9 (6x2) | 12 | Gland (https://quartzcomponents.com/products/pvc-glane-pg-9-dia-15mm?pr_prod_strat=e5_desc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) |  | YES
11
 |  | Total Price | 31079.8
 | Additional expenses
SL. No. | Name | Specifications | Price | Link | Offline | Ordered
1 | Insulation Filament Tape | 50mm | 199 | Tape (https://vipultech.in/product/insulation-filament-tape-for-battery-pack-50mm/) |  | YES
2 | Heat shrink | 8mm 3m | 51 | Heat shrink (https://www.myinnovation.in/product-page/8mm-2meter-black-heat-shrink-tube) |  | YES
3 | Heat shrink | 5mm 3m | 36 | Heat shrink (https://www.myinnovation.in/product-page/5mm-2-meter-black-heat-shrink-tube) |  | YES
4 | Solder wire | 1mm 30g | 75 | Solder (https://www.myinnovation.in/product-page/solder-wire-2-set) |  | YES
5 | Silicone wire | 12 AWG (4sq mm) Black and Red | 220 | Black Red (https://quartzcomponents.com/products/12awg-silicone-wire-black-1-meter-high-quality-ultra-flexible-for-battery-packs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) |  | YES
6 | Barley paper | 130 mm | 30 | Fish (https://vipultech.in/product/insulation-paper-130mm-for-lithium-battery/) |  | YES
7 | Hard foam | PU Foam |  |  |  | NO
8
14
 |  | Total Price | 611
 |  | Discount
 |  | Delivery charges
 |  | Break-even quantity | 2
 |  | Total Price | 31385.3

Sheet: XTT 60.8V 36Ah
 | Necessary minimum expenses
SL. No. | Name | Specifications | Price | Link | Offline | Ordered
1 | XTT Cells | 32700 LFP 6000mAh (147.5x114) | 16815 | 97196 76098 |  | YES
2 | BMS | LFP 19s 60V 40A JBD | 3000 | BMS (https://www.spdcstore.in/product/32801346/19S-40A-LFP-BMS---JBD) |  | YES
3 | PVC Shrink Tube for Lithium Battery Packs | 410mm | 85 | PVC Wrap (https://vipultech.in/product/410mm-heat-shrink-tube-for-lithium-battery/) |  | YES
4 | 32700 Battery Cell Holder | 1*3 (76*5.31) | 404 | 97195 76098 |  | YES
5 | Positive side insulation Stickers Adhesive | 114 pcs | 80 | Sticker (https://www.myinnovation.in/product-page/100pcs-32700-32650-cells-positive-side-insulation-stickers-adhesive) |  | YES
6 | 1 meter H shape Pure Nickel Strip | 1m H shape 32700 (49*15) | 735 | Nickel (https://vipultech.in/product/nickel-plated-steel-strip-h-type-for-32650-33140-with-cell-holder/) |  | YES
7 | Anderson Connector | SB50 50A | 178 | 97196 76098 |  | YES
8 | Case |  | 1000 | 96503 94021 |  | NO
9 | Epoxy sheet | 350mmx250mm x 6sheets | 329 | Sheet (https://vipultech.in/product/1mm-epoxy-fiber-sheet-for-lithium-battery-pack-300x400-mm-1kg-2/) |  | YES
10 | Nylon Gland | PG9 (6) | 36 | Gland (https://quartzcomponents.com/products/pvc-glane-pg-9-dia-15mm?pr_prod_strat=e5_desc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) |  | YES
11
 |  | Total Price | 22662
 | Additional expenses
SL. No. | Name | Specifications | Price | Link | Offline | Ordered
1 | Insulation Filament Tape | 50mm | 199 | Tape (https://vipultech.in/product/insulation-filament-tape-for-battery-pack-50mm/) |  | YES
2 | Heat shrink | 8mm 3m | 51 | Heat shrink (https://www.myinnovation.in/product-page/8mm-2meter-black-heat-shrink-tube) |  | YES
3 | Heat shrink | 5mm 3m | 36 | Heat shrink (https://www.myinnovation.in/product-page/5mm-2-meter-black-heat-shrink-tube) |  | YES
4 | Solder wire | 1mm 30g | 75 | Solder (https://www.myinnovation.in/product-page/solder-wire-2-set) |  | YES
5 | Silicone wire | 12 AWG (4sq mm) Black and Red | 220 | Black Red (https://quartzcomponents.com/products/12awg-silicone-wire-black-1-meter-high-quality-ultra-flexible-for-battery-packs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) |  | YES
6 | Barley paper | 130 mm | 30 | Fish (https://vipultech.in/product/insulation-paper-130mm-for-lithium-battery/) |  | YES
7 | Hard foam | PU Foam |  |  |  | NO
8
14
 |  | Total Price | 611
 |  | Discount
 |  | Delivery charges
 |  | Break-even quantity | 2
 |  | Total Price | 22967.5

Sheet: XTT 60.8V 30Ah
 | Necessary minimum expenses
SL. No. | Name | Specifications | Price | Link | Offline | Ordered
1 | XTT Cells | 32140 LFP 15000mAh (430.7x38) | 16366.6 | 97196 76098 |  | NO
2 | BMS | LFP 19s 60V 40A JBD | 1500 | BMS (https://www.spdcstore.in/product/32801346/19S-40A-LFP-BMS---JBD) |  | NO
3 | PVC Shrink Tube for Lithium Battery Packs | 410mm | 85 | PVC Wrap (https://vipultech.in/product/410mm-heat-shrink-tube-for-lithium-battery/) |  | YES
4 | 32700 Battery Cell Holder | 1*2 (38*4.72) | 179.36 | 97195 76098 |  | NO
5 | Positive side insulation Stickers Adhesive | 38 pcs | 35 | Sticker (https://www.myinnovation.in/product-page/25pcs-32700-32650-cells-positive-side-insulation-stickers-adhesive) |  | NO
6 | 1 meter H shape Pure Nickel Strip | 1m H shape 32700 (49*2) | 100 | Nickel (https://vipultech.in/product/nickel-plated-steel-strip-h-type-for-32650-33140-with-cell-holder/) |  | YES
7 | Anderson Connector | SB50 50A | 89 | 97196 76098 |  | YES
8 | Case |  | 1000 | 96503 94021 |  | NO
9 | Epoxy sheet | 350mmx250mm x 6sheets | 329 | Sheet (https://vipultech.in/product/1mm-epoxy-fiber-sheet-for-lithium-battery-pack-300x400-mm-1kg-2/) |  | YES
10 | Nylon Gland | PG9 (6) | 36 | Gland (https://quartzcomponents.com/products/pvc-glane-pg-9-dia-15mm?pr_prod_strat=e5_desc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) |  | YES
11
 |  | Total Price | 19719.96
 | Additional expenses
SL. No. | Name | Specifications | Price | Link | Offline | Ordered
1 | Insulation Filament Tape | 50mm | 199 | Tape (https://vipultech.in/product/insulation-filament-tape-for-battery-pack-50mm/) |  | YES
2 | Heat shrink | 8mm 3m | 51 | Heat shrink (https://www.myinnovation.in/product-page/8mm-2meter-black-heat-shrink-tube) |  | YES
3 | Heat shrink | 5mm 3m | 36 | Heat shrink (https://www.myinnovation.in/product-page/5mm-2-meter-black-heat-shrink-tube) |  | YES
4 | Solder wire | 1mm 30g | 75 | Solder (https://www.myinnovation.in/product-page/solder-wire-2-set) |  | YES
5 | Silicone wire | 12 AWG (4sq mm) Black and Red | 220 | Black Red (https://quartzcomponents.com/products/12awg-silicone-wire-black-1-meter-high-quality-ultra-flexible-for-battery-packs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) |  | YES
6 | Barley paper | 130 mm | 30 | Fish (https://vipultech.in/product/insulation-paper-130mm-for-lithium-battery/) |  | YES
7 | Hard foam | PU Foam |  |  |  | NO
8
14
 |  | Total Price | 611
 |  | Discount
 |  | Delivery charges
 |  | Break-even quantity | 2
 |  | Total Price | 20025.46

Sheet: XTT 12V 36Ah
 | Necessary minimum expenses
SL. No. | Name | Specifications | Price | Link | Offline | Ordered
1 | XTT Cells | 32700 LFP 6000mAh (24x147.5) | 3540 | 97196 76098 |  | NO
2 | BMS | 4s 10A JLGW | 118 | 97197 76098 |  | NO
3 | 150mm PVC Shrink Tube for Lithium Battery Packs | 290mm | 70 | PVC Wrap (https://www.myinnovation.in/product-page/290-mm-pvc-shrink-tube-for-lithium-battery) |  | NO
4 | Positive side insulation Stickers Adhesive | 30pcs | 30 | Stciker (https://www.myinnovation.in/product-page/25pcs-32700-32650-cells-positive-side-insulation-stickers-adhesive) |  | NO
5 | 1 meter H shape Pure Nickel Strip | 1m H shape | 49 | Nickel (https://vipultech.in/product/nickel-plated-steel-strip-h-type-for-32650-33140-with-cell-holder/) |  | NO
6 | Silicone wire | 1.5 sq mm | 40 | Wire |  | NO
7 | Barley paper | 130 mm | 30 | Fish (https://vipultech.in/product/insulation-paper-130mm-for-lithium-battery/) |  | NO
8 | Filament Tape | 50mm |  | Tape (https://vipultech.in/product/insulation-filament-tape-for-battery-pack-50mm/) |  | NO
 |  | Total Price | 70
 |  | Total Price | 3947
 | https://www.indiamart.com/proddetail/40w-dc-street-light-2854059622612.html

Sheet: DC Energy Meter
 | Necessary minimum expenses
SL. No. | Name | Specifications | Price | Link | Offline | Ordered
1 | PZEM-017 DC Shunt | 0-300V 100A | 859 | PZEM-017 (https://robu.in/product/pzem-017-module100a-shunt-dc-meter/) |  | NO
2 | MAX485 TTL To RS485 Converter Module | 5v automatic flow | 79 | TTL (https://www.indianhobbycenter.com/products/rs485-to-ttl-converter-module-serial-port-uart-hardware-automatic-flow-control-module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) |  | NO
3 | ESP32-C3 | RISC-V 32-bit, single core | 299 | ESP (https://www.indianhobbycenter.com/products/esp32-c3-mini-development-board-esp32-development-board-with-wi-fi-and-bluetooth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) |  | NO
4 | Memory Card reader | Micro SD | 49 | Reader (https://www.indianhobbycenter.com/products/ubon-memory-card-reader-gcr-442?_pos=12&_sid=efb5e23f6&_ss=r) |  | NO
5 | SD Module | SPI | 70 | SD (https://www.indianhobbycenter.com/products/micro-sd-card-module?_pos=2&_sid=efb5e23f6&_ss=r) |  | NO
6 | DC-DC Step Down | 6-24V to 5V 3A | 89 | DC-DC (https://www.indianhobbycenter.com/products/dc-dc-buck-5v-3a-usb-24w?_pos=8&_sid=c9af4fdb8&_ss=r) |  | NO
7 |  |  |  |  |  | NO
8 |  |  |  |  |  | NO
 |  |  | 1445

Sheet: Equipment
 | Equipment
SL. No. | Name | Specifications | Price | Link | Offline | Ordered
1 | Spot welder | 4KVA | 14000 | Spot (https://www.spdcstore.in/product/31720575/LITHIUM-SPOT-WELDING-MACHINE---4KVA-BEST-PERFORMANCE) |  | YES
2 | Hot air gun | 1500 W | 649 | Hot (https://vipultech.in/product/heat-gun/) |  | YES
3 | Metal cutter | 27 cm | 330 | Cutter (https://www.amazon.in/Inditrust-Cutting-Scissors-Cutters-Snippers/dp/B07QNRV2PV) |  | YES
4 | Soldering iron | Adujustable 60W | 500 | Iron (https://www.amazon.in/Cloud-Soldering-Adjustable-Temperature-soldering/dp/B07X25JLCV) |  | YES
5 | Flux | 10gm | 19 | Flux (https://quartzcomponents.com/products/soldering-and-desoldering-flux-paste-white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) |  | YES
6 | Tweezer | Generic | 30 | Tweezer (https://quartzcomponents.com/collections/all/products/precision-tweezers-standard-ts-10) |  | YES
7 | Iron stand | With sponge | 178 | Stand (https://www.amazon.in/Metal-Alloy-Soldering-Iron-Stand/dp/B0BFMW9C9B) |  | YES
8 | Multimeter | TH-M98 |  | Multimeter (https://www.amazon.in/Themisto-TH-M98-Digital-Multimeter-Counts/dp/B097RS212G) |  | NO
9 | Crimper | AWG 23-10 | 382 | Crimper (https://roboticsdna.in/product/mini-type-self-adjustable-crimping-plier/) |  | NO
10 | Wire stripper | Taparia | 70 | Striper (https://www.amazon.in/Taparia-WS-06-Steel-Stripping/dp/B00P66YBXA) |  | YES
11 | Cutter | 18mm snap off | 43 | Cutter (https://quartzcomponents.com/products/taparia-ske18-snap-off-cutter-18-mm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) |  | YES
12 | Cutting mat | A3 | 242 | Mat (https://www.amazon.in/HOME-BUY-Professional-Self-Healing-Non-Slip/dp/B00TV0HP0I) |  | YES
13 | Internal Resistance Meter | RC3563 | 3600 | IR (https://vipultech.in/product/high-precision-battery-voltage-internal-resistance-tester-small/) |  | YES
 |  | Total | 20043

Sheet: Final BOM
 | Necessary minimum expenses
SL. No. | Name | Specifications | Qty | Price | Link | Offline | Ordered
1 | BAK Cells | 21700 NMC 5000mAh (250x130) | 130 | 32500 | 70291 81970 |  | YES
2 | XTT Cells | 32700 LFP 6000mAh (147.5x114) | 200 | 29500 | 97196 76098 |  | YES
3 | BMS | NMC 60V 40A JBD | 2 | 1841 | 97196 76098 |  | YES
4 | LFP BMS | LFP 19s 60V JBD | 2 | 3000 | BMS (https://www.spdcstore.in/product/32801346/19S-40A-LFP-BMS---JBD) |  | YES
5 | PVC Shrink Tube for Lithium Battery Packs | 300mm | 2 | 130 | PVC Wrap (https://vipultech.in/product/300mm-heat-shrink-tube-for-lithium-battery/?attribute_length=1m) |  | YES
6 | 21700 Battery Cell Holder | 1*2 (260x3.54) | 250 | 885 | 97196 76098 |  | YES
7 | Positive side insulation Stickers Adhesive | 300 pcs | 4 | 60 | Stciker (https://www.spdcstore.in/product/33058764/21700-POSITIVE-SIDE-GASCUT---1-SHEET) |  | YES
8 | 1 meter H shape Pure Nickel Strip | 10m H shape 21700 | 1 | 490 | Nickel (https://www.spdcstore.in/product/32896608/21700-H-TYPE-NICKEL-STRIP-0-15MM---WITH-HOLDER-1-MTR---) |  | YES
9 | Anderson Connector | SB50 50A | 4 | 356 | SB50 (https://vipultech.in/product/600v-50a-power-connector-sb50/) |  | YES
10 | Case |  | 1 | 1000 | 96503 94021 |  | NO
11 | Epoxy sheet | 350mmx250mm x 6sheets | 3 | 987 | Sheet (https://vipultech.in/product/1mm-epoxy-fiber-sheet-for-lithium-battery-pack-300x400-mm-1kg-2/) |  | YES
12 | Nylon Gland | PG9 | 10 | 60 | Gland (https://quartzcomponents.com/products/pvc-glane-pg-9-dia-15mm?pr_prod_strat=e5_desc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) |  | YES
13 | PVC Shrink Tube for Lithium Battery Packs | 410mm | 2 | 170 | PVC Wrap (https://vipultech.in/product/410mm-heat-shrink-tube-for-lithium-battery/) |  | YES
14 | 32700 Battery Cell Holder | 1*3 | 200 | 1062 | 97195 76098 |  | YES
15 | Positive side insulation Stickers Adhesive | 200 pcs | 200 | 158 | Sticker (https://www.myinnovation.in/product-page/100pcs-32700-32650-cells-positive-side-insulation-stickers-adhesive) |  | YES
16 | 1 meter H shape Pure Nickel Strip | 1m H shape 32700 | 15 | 735 | Nickel (https://vipultech.in/product/nickel-plated-steel-strip-h-type-for-32650-33140-with-cell-holder/) |  | YES
17 | Case |  | 2 | 2000 | 96503 94021 |  | NO
18
 |  | Total Price |  | 74934
 | Additional expenses
SL. No. | Name | Specifications |  | Price | Link | Offline | Ordered
1 | Insulation Filament Tape | 50mm | 1 | 199 | Tape (https://vipultech.in/product/insulation-filament-tape-for-battery-pack-50mm/) |  | YES
2 | Heat shrink | 8mm 3m | 1 | 51 | Heat shrink (https://www.myinnovation.in/product-page/8mm-2meter-black-heat-shrink-tube) |  | YES
3 | Heat shrink | 5mm 3m | 1 | 36 | Heat shrink (https://www.myinnovation.in/product-page/5mm-2-meter-black-heat-shrink-tube) |  | YES
4 | Solder wire | 1mm 30g | 1 | 75 | Solder (https://www.myinnovation.in/product-page/solder-wire-2-set) |  | YES
5 | Silicone wire | 12 AWG (4sq mm) Black and Red | 2 | 440 | Black Red (https://quartzcomponents.com/products/12awg-silicone-wire-black-1-meter-high-quality-ultra-flexible-for-battery-packs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) |  | YES
6 | Barley paper | 130 mm | 1 | 30 | Fish (https://vipultech.in/product/insulation-paper-130mm-for-lithium-battery/) |  | YES
7 | Hard foam | PU Foam |  |  |  |  | NO
13
14
 |  | Total Price |  | 831
 |  | Discount
 |  | Delivery charges
 |  | Break-even quantity |  | 2
 |  | Total Price |  | 74934

Sheet: Printable
 | Necessary minimum expenses
SL. No. | Name | Specifications | Qty | Price
1 | BAK Cells | 21700 NMC 5000mAh (250x130) | 130 | 32500
2 | XTT Cells | 32700 LFP 6000mAh (147.5x114) | 200 | 29500
3 | BMS | NMC 60V 40A JBD | 2 | 1841
4 | LFP BMS | LFP 19s 60V JBD | 2 | 3000
5 | PVC Shrink Tube for Lithium Battery Packs | 300mm | 2 | 130
6 | 21700 Battery Cell Holder | 1*2 (260x3.54) | 250 | 885
7 | Positive side insulation Stickers Adhesive | 300 pcs | 4 | 60
8 | 1 meter H shape Pure Nickel Strip | 10m H shape 21700 | 1 | 490
9 | Anderson Connector | SB50 50A | 4 | 356
10 | Case |  | 1 | 1000
11 | Epoxy sheet | 350mmx250mm x 6sheets | 3 | 987
12 | Nylon Gland | PG9 | 10 | 60
13 | PVC Shrink Tube for Lithium Battery Packs | 410mm | 2 | 170
14 | 32700 Battery Cell Holder | 1*3 | 200 | 1062
15 | Positive side insulation Stickers Adhesive | 200 pcs | 200 | 158
16 | 1 meter H shape Pure Nickel Strip | 1m H shape 32700 | 15 | 735
17 | Case |  | 2 | 2000
 |  | Total Price |  | 74934
 | Additional expenses
SL. No. | Name | Specifications | Qty | Price
1 | Heat shrink | 8mm 3m | 1 | 51
2 | Heat shrink | 5mm 3m | 1 | 36
3 | Solder wire | 1mm 30g | 1 | 75
4 | Silicone wire | 12 AWG (4sq mm) Black and Red | 2 | 440
5 | Barley paper | 130 mm | 1 | 30
6 | Hard foam | PU Foam
7 | Insulation Filament Tape | 50mm | 1 | 199
 |  | Total Price |  | 831
 | Equipment
SL. No. | Name | Specifications | Qty | Price
1 | Spot welder | 4KVA | 1 | 14000
2 | Hot air gun | 1500 W | 1 | 649
3 | Metal cutter | 27 cm | 1 | 330
4 | Soldering iron | Adujustable 60W | 1 | 500
5 | Flux | 10gm | 1 | 19
6 | Tweezer | Generic | 1 | 30
7 | Iron stand | With sponge | 1 | 178
8 | Crimper | AWG 23-10 | 1 | 382
9 | Wire stripper | Taparia | 1 | 70
10 | Cutter | 18mm snap off | 1 | 43
11 | Cutting mat | A3 | 1 | 242
12 | Internal Resistance Meter | RC3563 | 1 | 3600
 |  | Total |  | 20043
 |  | Sub total |  | 95808

Sheet: NMC Data
IR Values |  |  |  | Charging data
13.x | 14.x | 15.x | 16.x | Percentage | Voltage(V) | Time | t in mins
 |  |  |  | 12 | 55 | 14:04:00 | 0
13.67 | 14.04 | 15.17 | 16.35 | 45 | 59 | 15:30:00 | 86
13.71 | 14.11 | 15.36 | 16.04 | 100 | 67 | 19:00:00 | 296
13.63 | 14.26 | 15.28
13.76 | 14.07 | 15.33 |  | 1 | 52 | 11:45:00 | 0
13.91 | 14.15 | 15.22 |  | 50 | 61 | 13:45:00 | 120
13.72 | 14.21 | 15.17 |  | 100 | 67 | 16:30:00 | 285
13.52 | 14.94 | 15.28
13.41 | 14.74 | 15.41
13.57 | 14.01 | 15.23 |  | Discharging Data
13.45 | 14.64 | 15.09 |  | Distance(km) | Duration(min:sec) | Voltage Drop(V) | Avg Speed(km/h)
13.99 | 14.17 | 15.01 |  | 5.8 | 16:08:00 | 67-66 | 22
13.95 | 14.05 |  |  | 3.8 | 10:55:00 | 66-66 | 21
13.77 | 14.51 |  |  | 14.8 | 0:38:36 | 65-64 | 23
13.41 | 14.75 |  |  | 5.6 | 12:06:00 | 64-63 | 26
13.51 | 14.68 |  |  | 8.9 | 0:22:46 | 63-62 | 24
13.76 | 14.38 |  |  | 20.4 | 0:48:01 | 61-59 | 26
13.91 | 14.69 |  |  | 14.1 | 0:37:38 | 58-56 | 23
13.38 | 14.03 |  |  | 4.1 | 11:12:00 | 56-55 | 23
13.53 | 14.81 |  |  | 5.2 | 12:12:00 | 55-54 | 22
13.71 | 14.17 |  |  | 2.6 | 10:32:00 | 54-52 | 15
13.93 | 14.01
13.83 | 14.24 |  |  | 85.3 | 3h 45m
13.36 | 14.22
13.38 | 14.32
13.45 | 14.16
13.33 | 14.11
13.94 | 14.19
13.32 | 14.77
13.22 | 14.52
13.72 | 14.39
13.54 | 14.45
13.67 | 14.56
13.31 | 14.64
13.32 | 14.67
13.64 | 14.06
13.61 | 14.01
13.45 | 14.64
13.91 | 14.37
13.58 | 14.23
13.62 | 14.55
13.28 | 14.52
13.92 | 14.73
13.48 | 14.46
13.54 | 14.74
13.61 | 14.15
13.65 | 14.33
13.61 | 14.05
13.27 | 14.21
13.89 | 14.23
13.96
13.83
13.68
13.84
13.77
13.48
13.51
13.58
13.48
13.72
13.45
13.57
13.58
13.44
13.44
13.65
13.91
13.55

Sheet: LFP 36Ah Data
5.x | 6.x | 7.x | 8.x
5.93 | 6.75 | 7.59 | 8.45
5.81 | 6.17
 | 6.28
 | 6.62
 | 6.35
 | 6.61
 | 6.26
 | 6.05
 | 6.28
 | 6.71
 | 6.62
 | 6.32
 | 6.24
 | 6.16
 | 6.21
 | 6.48
 | 6.11
 | 6.83
 | 6.58
 | 6.66
 | 6.87
