Ayusha343/battery-pack-engineering/Docs/DLOK battery pack.xlsx

Sheet: 12V 24Ah
 | Necessary minimum expenses
SL. No. | Name | Specifications | Price | Link | Offline | Ordered | Final | Alternate | Price
1 | HX Cells | 32700 LFP 6000mAh (16x120) | 1920 | 98997 79735 |  | NO |  | 91 79 4935 0706 | 2080
2 | BMS | 4s 10A LFP | 135 | BMS (https://vipultech.in/product/daly-lifepo4-4s-12v-10a-battery-management-system/) |  | NO
3 | 150mm PVC Shrink Tube for Lithium Battery Packs | 230mm | 50 | PVC Wrap (https://www.myinnovation.in/product-page/230mm-pvc-shrink-tube-for-lithium-battery-packs) |  | NO
4 | 21700 Battery Cell Holder | 1*2 (16x4) | 64 | 98997 79735 |  | NO |  | 91 79 4935 0706 | 64
5 | Positive side insulation Stickers Adhesive | 30pcs | 30 | Stciker (https://www.myinnovation.in/product-page/25pcs-32700-32650-cells-positive-side-insulation-stickers-adhesive) |  | NO
6 | 1 meter H shape Pure Nickel Strip | 1m H shape | 120 | Nickel (https://www.myinnovation.in/product-page/1m-h-shape-nickel-strip-for-32700-32650-lithium-phosphet-battery-spot-welding) |  | NO
9 | Epoxy sheet | 300mmx165mm | 250 | Sheet (https://www.myinnovation.in/product-page/epoxy-fiber-sheet-insulator-for-lithium-battery-pack-pack-of-4-sheets) |  | NO
10 |  |  |  |  |  | NO
11 |  |  |  |  |  | NO
12 |  |  |  |  |  | NO
13 | Misc |  | 500 |  |  | NO
14 |  |  |  |  |  | NO
15 |  |  |  |  |  | NO
 |  | Total Price | 3069
 | Additional expenses
SL. No. | Name | Specifications | Price | Link | Offline | Ordered | Final
1 | Insulation Filament Tape | 50mm | 230 | Tape (https://www.amazon.in/Insulation-Filament-Tape-50mm-white/dp/B0DS93BMGT) |  | NO
2 | Heat shrink | 8mm 3m | 51 | Heat shrink (https://www.myinnovation.in/product-page/8mm-2meter-black-heat-shrink-tube) |  | NO
3 | Heat shrink | 5mm 3m | 36 | Heat shrink (https://www.myinnovation.in/product-page/5mm-2-meter-black-heat-shrink-tube) |  | NO
4 | Solder wire | 1mm 30g | 75 | Solder (https://www.myinnovation.in/product-page/solder-wire-2-set) |  | NO
5 | Silicone wire | 14 AWG Black and Red |  |  |  | NO
6 | Barley paper | 100 mm | 30 | Fish (https://quartzcomponents.com/products/100mm-barley-paper-fish-paper-with-adhesive-for-lithium-battery-pack-insulation-1-meter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) |  | NO
7 |  |  |  |  |  | NO
 |  | Total Price | 422
 |  | Discount
 |  | Delivery charges
 |  | Break-even quantity | 2
 |  | Total Price | 3280 |  |  |  | 0

Sheet: CJ 59.2V 30Ah
 | Necessary minimum expenses
SL. No. | Name | Specifications | Price | Link | Offline | Ordered | Final | Alternate | Price
1 | CJ Cells | 21700 NMC 5000mAh (149x96) | 14304 | Cells (https://infranovasolution.com/product/dmegc-21700-lithium-ion-cell-5000mah-3c-original/) |  | NO |  | Cells (https://smuf.in/dmegc-5000-mah-original-ev-grade-21700-lithium-battery/) | 20160
2 | BMS | NMC 60V 40A JBD | 1299 | BMS (https://www.myinnovation.in/product-page/16s-60v-40amps-lithium-ion-18650-battery-jbd-bms-module-protection-board) |  | NO
3 | 150mm PVC Shrink Tube for Lithium Battery Packs | 300mm | 65 | PVC Wrap (https://vipultech.in/product/300mm-heat-shrink-tube-for-lithium-battery/?attribute_length=1m) |  | NO
4 | 21700 Battery Cell Holder | 1*2 (96x4) | 384 | Spacer (https://vippotech.in/product/12-21650-cell-holder-for-nmc-cells/) |  | NO
5 | Positive side insulation Stickers Adhesive | 100 pcs | 59 | Stciker (https://makerbazar.in/products/21700-21650-1s-battery-electrical-insulator-insulation-ring-adhesive-for-positive-terminal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) |  | NO
6 | 1 meter H shape Pure Nickel Strip | 1m H shape | 100 | Nickel (https://www.myinnovation.in/product-page/1-meter-h-type-nickel-strip-for-21700-lithium-battery-spot-welding) |  | NO
7 | Anderson Connector | SB50 50A | 99 | SB50 (https://vippotech.in/product/600v-50a-power-connector-sb50/) |  | NO
8 | Case | Customisable | 700 | Case (https://www.shreeomproducts.com/scooter-battery-box.html) |  | NO |  | Case (https://www.indiamart.com/proddetail/lithium-ion-battery-box-2859330840312.html?pos=3&kwd=battery%20box) | 400
9 | Epoxy sheet | 300mmx165mm | 250 | Sheet (https://www.myinnovation.in/product-page/epoxy-fiber-sheet-insulator-for-lithium-battery-pack-pack-of-4-sheets) |  | NO
10 |  |  |  |  |  | NO
11 |  |  |  |  |  | NO
12 |  |  |  |  |  | NO
13 | Misc |  | 500 |  |  | NO
14 |  |  |  |  |  | NO
15 |  |  |  |  |  | NO
 |  | Total Price | 17760
 | Additional expenses
SL. No. | Name | Specifications | Price | Link | Offline | Ordered | Final
1 | Insulation Filament Tape | 50mm | 230 | Tape (https://www.amazon.in/Insulation-Filament-Tape-50mm-white/dp/B0DS93BMGT) |  | NO
2 | Heat shrink | 8mm 3m | 51 | Heat shrink (https://www.myinnovation.in/product-page/8mm-2meter-black-heat-shrink-tube) |  | NO
3 | Heat shrink | 5mm 3m | 36 | Heat shrink (https://www.myinnovation.in/product-page/5mm-2-meter-black-heat-shrink-tube) |  | NO
4 | Solder wire | 1mm 30g | 75 | Solder (https://www.myinnovation.in/product-page/solder-wire-2-set) |  | NO
5 | Silicone wire | 12 AWG (4sq mm) Black and Red | 220 | Black Red (https://quartzcomponents.com/products/12awg-silicone-wire-black-1-meter-high-quality-ultra-flexible-for-battery-packs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) |  | NO
6 | Barley paper | 100 mm | 30 | Fish (https://quartzcomponents.com/products/100mm-barley-paper-fish-paper-with-adhesive-for-lithium-battery-pack-insulation-1-meter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) |  | NO
7 |  |  |  |  |  | NO
 |  | Total Price | 642
 |  | Discount
 |  | Delivery charges
 |  | Break-even quantity | 2
 |  | Total Price | 19072.5 |  |  |  | 0

Sheet: CJ 59.2V 35Ah
 | Necessary minimum expenses
SL. No. | Name | Specifications | Price | Link | Offline | Ordered | Final | Alternate | Price
1 | CJ Cells | 21700 NMC 5000mAh (149x112) | 16688 | Cells (https://infranovasolution.com/product/dmegc-21700-lithium-ion-cell-5000mah-3c-original/) |  | NO |  | Cells (https://smuf.in/dmegc-5000-mah-original-ev-grade-21700-lithium-battery/)
2 | BMS | NMC 60V 40A JBD | 1300 | BMS (https://www.myinnovation.in/product-page/16s-60v-40amps-lithium-ion-18650-battery-jbd-bms-module-protection-board) |  | NO
3 | 150mm PVC Shrink Tube for Lithium Battery Packs | 300mm | 65 | PVC Wrap (https://vipultech.in/product/300mm-heat-shrink-tube-for-lithium-battery/?attribute_length=1m) |  | NO
4 | 21700 Battery Cell Holder | 1*2 (112x4) | 448 | Spacer (https://vippotech.in/product/12-21650-cell-holder-for-nmc-cells/) |  | NO
5 | Positive side insulation Stickers Adhesive | 112 pcs | 70 | Stciker (https://makerbazar.in/products/21700-21650-1s-battery-electrical-insulator-insulation-ring-adhesive-for-positive-terminal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) |  | NO
6 | 1 meter H shape Pure Nickel Strip | 1m H shape | 100 | Nickel (https://www.myinnovation.in/product-page/1-meter-h-type-nickel-strip-for-21700-lithium-battery-spot-welding) |  | NO
7 | Anderson Connector | SB50 50A | 99 | SB50 (https://vippotech.in/product/600v-50a-power-connector-sb50/) |  | NO
8 | Case | Customisable | 700 | Case (https://www.shreeomproducts.com/scooter-battery-box.html) |  | NO |  | Case (https://www.indiamart.com/proddetail/lithium-ion-battery-box-2859330840312.html?pos=3&kwd=battery%20box) | 400
9 | Epoxy sheet | 300mmx165mm | 250 | Sheet (https://www.myinnovation.in/product-page/epoxy-fiber-sheet-insulator-for-lithium-battery-pack-pack-of-4-sheets) |  | NO
10 |  |  |  |  |  | NO
11 |  |  |  |  |  | NO
12 |  |  |  |  |  | NO
13 | Misc |  | 300 |  |  | NO
14 |  |  |  |  |  | NO
15 |  |  |  |  |  | NO
 |  | Total Price | 20020
 | Additional expenses
SL. No. | Name | Specifications | Price | Link | Offline | Ordered | Final
1 | Insulation Filament Tape | 50mm | 230 | Tape (https://www.amazon.in/Insulation-Filament-Tape-50mm-white/dp/B0DS93BMGT) |  | NO
2 | Heat shrink | 8mm 3m | 51 | Heat shrink (https://www.myinnovation.in/product-page/8mm-2meter-black-heat-shrink-tube) |  | NO
3 | Heat shrink | 5mm 3m | 36 | Heat shrink (https://www.myinnovation.in/product-page/5mm-2-meter-black-heat-shrink-tube) |  | NO
4 | Solder wire | 1mm 30g | 75 | Solder (https://www.myinnovation.in/product-page/solder-wire-2-set) |  | NO
5 | Silicone wire | 12 AWG (4sq mm) Black and Red | 220 | Black Red (https://quartzcomponents.com/products/12awg-silicone-wire-black-1-meter-high-quality-ultra-flexible-for-battery-packs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) |  | NO
6 | Barley paper | 100 mm | 30 | Fish (https://quartzcomponents.com/products/100mm-barley-paper-fish-paper-with-adhesive-for-lithium-battery-pack-insulation-1-meter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) |  | NO
7 |  |  |  |  |  | NO
8 |  |  |  |  |  | NO
9 |  |  |  |  |  | NO
10 |  |  |  |  |  | NO
11 |  |  |  |  |  | NO
12 |  |  |  |  |  | NO
13 |  |  |  |  |  | NO
14
 |  | Total Price | 642
 |  | Discount
 |  | Delivery charges
 |  | Break-even quantity | 2
 |  | Total Price | 21332.5 |  |  |  | 0

Sheet: CJ 62.9V 30Ah
 | Necessary minimum expenses
SL. No. | Name | Specifications | Price | Link | Offline | Ordered | Final | Alternate | Price
1 | CJ Cells | 21700 NMC 5000mAh (149x102) | 15198 | Cells (https://infranovasolution.com/product/dmegc-21700-lithium-ion-cell-5000mah-3c-original/) |  | NO |  | Cells (https://smuf.in/dmegc-5000-mah-original-ev-grade-21700-lithium-battery/)
2 | BMS | NMC 60V 40A JBD | 1299 | BMS (https://www.myinnovation.in/product-page/16s-60v-40amps-lithium-ion-18650-battery-jbd-bms-module-protection-board) |  | NO
3 | 150mm PVC Shrink Tube for Lithium Battery Packs | 300mm | 65 | PVC Wrap (https://vipultech.in/product/300mm-heat-shrink-tube-for-lithium-battery/?attribute_length=1m) |  | NO
4 | 21700 Battery Cell Holder | 1*2 (102x4) | 408 | Spacer (https://vippotech.in/product/12-21650-cell-holder-for-nmc-cells/) |  | NO
5 | Positive side insulation Stickers Adhesive | 102 pcs | 65 | Stciker (https://makerbazar.in/products/21700-21650-1s-battery-electrical-insulator-insulation-ring-adhesive-for-positive-terminal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) |  | NO
6 | 1 meter H shape Pure Nickel Strip | 1m H shape | 100 | Nickel (https://www.myinnovation.in/product-page/1-meter-h-type-nickel-strip-for-21700-lithium-battery-spot-welding) |  | NO
7 | Anderson Connector | SB50 50A | 99 | SB50 (https://vippotech.in/product/600v-50a-power-connector-sb50/) |  | NO
8 | Case | Customisable | 700 | Case (https://www.shreeomproducts.com/scooter-battery-box.html) |  | NO |  | Case (https://www.indiamart.com/proddetail/lithium-ion-battery-box-2859330840312.html?pos=3&kwd=battery%20box) | 400
9 | Epoxy sheet | 300mmx165mm | 250 | Sheet (https://www.myinnovation.in/product-page/epoxy-fiber-sheet-insulator-for-lithium-battery-pack-pack-of-4-sheets) |  | NO
10 |  |  |  |  |  | NO
11 |  |  |  |  |  | NO
12 |  |  |  |  |  | NO
13 | Misc |  | 500 |  |  | NO
14 |  |  |  |  |  | NO
15 |  |  |  |  |  | NO
 |  | Total Price | 18684
 | Additional expenses
SL. No. | Name | Specifications | Price | Link | Offline | Ordered | Final
1 | Insulation Filament Tape | 50mm | 230 | Tape (https://www.amazon.in/Insulation-Filament-Tape-50mm-white/dp/B0DS93BMGT) |  | NO
2 | Heat shrink | 8mm 3m | 51 | Heat shrink (https://www.myinnovation.in/product-page/8mm-2meter-black-heat-shrink-tube) |  | NO
3 | Heat shrink | 5mm 3m | 36 | Heat shrink (https://www.myinnovation.in/product-page/5mm-2-meter-black-heat-shrink-tube) |  | NO
4 | Solder wire | 1mm 30g | 75 | Solder (https://www.myinnovation.in/product-page/solder-wire-2-set) |  | NO
5 | Silicone wire | 12 AWG (4sq mm) Black and Red | 220 | Black Red (https://quartzcomponents.com/products/12awg-silicone-wire-black-1-meter-high-quality-ultra-flexible-for-battery-packs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) |  | NO
6 | Barley paper | 100 mm | 30 | Fish (https://quartzcomponents.com/products/100mm-barley-paper-fish-paper-with-adhesive-for-lithium-battery-pack-insulation-1-meter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) |  | NO
7 |  |  |  |  |  | NO
8 |  |  |  |  |  | NO
9 |  |  |  |  |  | NO
10 |  |  |  |  |  | NO
11 |  |  |  |  |  | NO
12 |  |  |  |  |  | NO
13 |  |  |  |  |  | NO
14
 |  | Total Price | 642
 |  | Discount
 |  | Delivery charges
 |  | Break-even quantity | 2
 |  | Total Price | 19996.5 |  |  |  | 0

Sheet: 59.2V 30Ah
 | Necessary minimum expenses
SL. No. | Name | Specifications | Price | Link | Offline | Ordered | Final | Alternate | Price
1 | DMEGC Cells | 21700 NMC 5000mAh (189x96) | 18144 | Cells (https://infranovasolution.com/product/dmegc-21700-lithium-ion-cell-5000mah-3c-original/) |  | NO |  | Cells (https://smuf.in/dmegc-5000-mah-original-ev-grade-21700-lithium-battery/) | 20160
2 | BMS | NMC 60V 40A JBD | 1299 | BMS (https://www.myinnovation.in/product-page/16s-60v-40amps-lithium-ion-18650-battery-jbd-bms-module-protection-board) |  | NO
3 | 150mm PVC Shrink Tube for Lithium Battery Packs | 300mm | 65 | PVC Wrap (https://vipultech.in/product/300mm-heat-shrink-tube-for-lithium-battery/?attribute_length=1m) |  | NO
4 | 21700 Battery Cell Holder | 1*2 (96x4) | 384 | Spacer (https://vippotech.in/product/12-21650-cell-holder-for-nmc-cells/) |  | NO
5 | Positive side insulation Stickers Adhesive | 100 pcs | 59 | Stciker (https://makerbazar.in/products/21700-21650-1s-battery-electrical-insulator-insulation-ring-adhesive-for-positive-terminal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) |  | NO
6 | 1 meter H shape Pure Nickel Strip | 1m H shape | 100 | Nickel (https://www.myinnovation.in/product-page/1-meter-h-type-nickel-strip-for-21700-lithium-battery-spot-welding) |  | NO
7 | Anderson Connector | SB50 50A | 99 | SB50 (https://vippotech.in/product/600v-50a-power-connector-sb50/) |  | NO
8 | Case | Customisable | 700 | Case (https://www.shreeomproducts.com/scooter-battery-box.html) |  | NO |  | Case (https://www.indiamart.com/proddetail/lithium-ion-battery-box-2859330840312.html?pos=3&kwd=battery%20box) | 400
9 | Epoxy sheet | 300mmx165mm | 250 | Sheet (https://www.myinnovation.in/product-page/epoxy-fiber-sheet-insulator-for-lithium-battery-pack-pack-of-4-sheets) |  | NO
10 |  |  |  |  |  | NO
11 |  |  |  |  |  | NO
12 |  |  |  |  |  | NO
13 | Misc |  | 500 |  |  | NO
14 |  |  |  |  |  | NO
15 |  |  |  |  |  | NO
 |  | Total Price | 21600
 | Additional expenses
SL. No. | Name | Specifications | Price | Link | Offline | Ordered | Final
1 | Insulation Filament Tape | 50mm | 230 | Tape (https://www.amazon.in/Insulation-Filament-Tape-50mm-white/dp/B0DS93BMGT) |  | NO
2 | Heat shrink | 8mm 3m | 51 | Heat shrink (https://www.myinnovation.in/product-page/8mm-2meter-black-heat-shrink-tube) |  | NO
3 | Heat shrink | 5mm 3m | 36 | Heat shrink (https://www.myinnovation.in/product-page/5mm-2-meter-black-heat-shrink-tube) |  | NO
4 | Solder wire | 1mm 30g | 75 | Solder (https://www.myinnovation.in/product-page/solder-wire-2-set) |  | NO
5 | Silicone wire | 12 AWG (4sq mm) Black and Red | 220 | Black Red (https://quartzcomponents.com/products/12awg-silicone-wire-black-1-meter-high-quality-ultra-flexible-for-battery-packs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) |  | NO
6 | Barley paper | 100 mm | 30 | Fish (https://quartzcomponents.com/products/100mm-barley-paper-fish-paper-with-adhesive-for-lithium-battery-pack-insulation-1-meter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) |  | NO
7 |  |  |  |  |  | NO
 |  | Total Price | 642
 |  | Discount
 |  | Delivery charges
 |  | Break-even quantity | 2
 |  | Total Price | 22912.5 |  |  |  | 0

Sheet: 59.2V 35Ah
 | Necessary minimum expenses
SL. No. | Name | Specifications | Price | Link | Offline | Ordered | Final | Alternate | Price
1 | DMEGC Cells | 21700 NMC 5000mAh (189x112) | 21168 | Cells (https://infranovasolution.com/product/dmegc-21700-lithium-ion-cell-5000mah-3c-original/) |  | NO |  | Cells (https://smuf.in/dmegc-5000-mah-original-ev-grade-21700-lithium-battery/)
2 | BMS | NMC 60V 40A JBD | 1300 | BMS (https://www.myinnovation.in/product-page/16s-60v-40amps-lithium-ion-18650-battery-jbd-bms-module-protection-board) |  | NO
3 | 150mm PVC Shrink Tube for Lithium Battery Packs | 300mm | 65 | PVC Wrap (https://vipultech.in/product/300mm-heat-shrink-tube-for-lithium-battery/?attribute_length=1m) |  | NO
4 | 21700 Battery Cell Holder | 1*2 (112x4) | 448 | Spacer (https://vippotech.in/product/12-21650-cell-holder-for-nmc-cells/) |  | NO
5 | Positive side insulation Stickers Adhesive | 112 pcs | 70 | Stciker (https://makerbazar.in/products/21700-21650-1s-battery-electrical-insulator-insulation-ring-adhesive-for-positive-terminal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) |  | NO
6 | 1 meter H shape Pure Nickel Strip | 1m H shape | 100 | Nickel (https://www.myinnovation.in/product-page/1-meter-h-type-nickel-strip-for-21700-lithium-battery-spot-welding) |  | NO
7 | Anderson Connector | SB50 50A | 99 | SB50 (https://vippotech.in/product/600v-50a-power-connector-sb50/) |  | NO
8 | Case | Customisable | 700 | Case (https://www.shreeomproducts.com/scooter-battery-box.html) |  | NO |  | Case (https://www.indiamart.com/proddetail/lithium-ion-battery-box-2859330840312.html?pos=3&kwd=battery%20box) | 400
9 | Epoxy sheet | 300mmx165mm | 250 | Sheet (https://www.myinnovation.in/product-page/epoxy-fiber-sheet-insulator-for-lithium-battery-pack-pack-of-4-sheets) |  | NO
10 |  |  |  |  |  | NO
11 |  |  |  |  |  | NO
12 |  |  |  |  |  | NO
13 | Misc |  | 300 |  |  | NO
14 |  |  |  |  |  | NO
15 |  |  |  |  |  | NO
 |  | Total Price | 24500
 | Additional expenses
SL. No. | Name | Specifications | Price | Link | Offline | Ordered | Final
1 | Insulation Filament Tape | 50mm | 230 | Tape (https://www.amazon.in/Insulation-Filament-Tape-50mm-white/dp/B0DS93BMGT) |  | NO
2 | Heat shrink | 8mm 3m | 51 | Heat shrink (https://www.myinnovation.in/product-page/8mm-2meter-black-heat-shrink-tube) |  | NO
3 | Heat shrink | 5mm 3m | 36 | Heat shrink (https://www.myinnovation.in/product-page/5mm-2-meter-black-heat-shrink-tube) |  | NO
4 | Solder wire | 1mm 30g | 75 | Solder (https://www.myinnovation.in/product-page/solder-wire-2-set) |  | NO
5 | Silicone wire | 12 AWG (4sq mm) Black and Red | 220 | Black Red (https://quartzcomponents.com/products/12awg-silicone-wire-black-1-meter-high-quality-ultra-flexible-for-battery-packs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) |  | NO
6 | Barley paper | 100 mm | 30 | Fish (https://quartzcomponents.com/products/100mm-barley-paper-fish-paper-with-adhesive-for-lithium-battery-pack-insulation-1-meter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) |  | NO
7 |  |  |  |  |  | NO
8 |  |  |  |  |  | NO
9 |  |  |  |  |  | NO
10 |  |  |  |  |  | NO
11 |  |  |  |  |  | NO
12 |  |  |  |  |  | NO
13 |  |  |  |  |  | NO
14
 |  | Total Price | 642
 |  | Discount
 |  | Delivery charges
 |  | Break-even quantity | 2
 |  | Total Price | 25812.5 |  |  |  | 0

Sheet: 62.9V 30Ah
 | Necessary minimum expenses
SL. No. | Name | Specifications | Price | Link | Offline | Ordered | Final | Alternate | Price
1 | DMEGC Cells | 21700 NMC 5000mAh (189x102) | 19278 | Cells (https://infranovasolution.com/product/dmegc-21700-lithium-ion-cell-5000mah-3c-original/) |  | NO |  | Cells (https://smuf.in/dmegc-5000-mah-original-ev-grade-21700-lithium-battery/)
2 | BMS | NMC 60V 40A JBD | 1299 | BMS (https://www.myinnovation.in/product-page/16s-60v-40amps-lithium-ion-18650-battery-jbd-bms-module-protection-board) |  | NO
3 | 150mm PVC Shrink Tube for Lithium Battery Packs | 300mm | 65 | PVC Wrap (https://vipultech.in/product/300mm-heat-shrink-tube-for-lithium-battery/?attribute_length=1m) |  | NO
4 | 21700 Battery Cell Holder | 1*2 (102x4) | 408 | Spacer (https://vippotech.in/product/12-21650-cell-holder-for-nmc-cells/) |  | NO
5 | Positive side insulation Stickers Adhesive | 102 pcs | 65 | Stciker (https://makerbazar.in/products/21700-21650-1s-battery-electrical-insulator-insulation-ring-adhesive-for-positive-terminal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) |  | NO
6 | 1 meter H shape Pure Nickel Strip | 1m H shape | 100 | Nickel (https://www.myinnovation.in/product-page/1-meter-h-type-nickel-strip-for-21700-lithium-battery-spot-welding) |  | NO
7 | Anderson Connector | SB50 50A | 99 | SB50 (https://vippotech.in/product/600v-50a-power-connector-sb50/) |  | NO
8 | Case | Customisable | 700 | Case (https://www.shreeomproducts.com/scooter-battery-box.html) |  | NO |  | Case (https://www.indiamart.com/proddetail/lithium-ion-battery-box-2859330840312.html?pos=3&kwd=battery%20box) | 400
9 | Epoxy sheet | 300mmx165mm | 250 | Sheet (https://www.myinnovation.in/product-page/epoxy-fiber-sheet-insulator-for-lithium-battery-pack-pack-of-4-sheets) |  | NO
10 |  |  |  |  |  | NO
11 |  |  |  |  |  | NO
12 |  |  |  |  |  | NO
13 | Misc |  | 500 |  |  | NO
14 |  |  |  |  |  | NO
15 |  |  |  |  |  | NO
 |  | Total Price | 22764
 | Additional expenses
SL. No. | Name | Specifications | Price | Link | Offline | Ordered | Final
1 | Insulation Filament Tape | 50mm | 230 | Tape (https://www.amazon.in/Insulation-Filament-Tape-50mm-white/dp/B0DS93BMGT) |  | NO
2 | Heat shrink | 8mm 3m | 51 | Heat shrink (https://www.myinnovation.in/product-page/8mm-2meter-black-heat-shrink-tube) |  | NO
3 | Heat shrink | 5mm 3m | 36 | Heat shrink (https://www.myinnovation.in/product-page/5mm-2-meter-black-heat-shrink-tube) |  | NO
4 | Solder wire | 1mm 30g | 75 | Solder (https://www.myinnovation.in/product-page/solder-wire-2-set) |  | NO
5 | Silicone wire | 12 AWG (4sq mm) Black and Red | 220 | Black Red (https://quartzcomponents.com/products/12awg-silicone-wire-black-1-meter-high-quality-ultra-flexible-for-battery-packs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) |  | NO
6 | Barley paper | 100 mm | 30 | Fish (https://quartzcomponents.com/products/100mm-barley-paper-fish-paper-with-adhesive-for-lithium-battery-pack-insulation-1-meter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) |  | NO
7 |  |  |  |  |  | NO
8 |  |  |  |  |  | NO
9 |  |  |  |  |  | NO
10 |  |  |  |  |  | NO
11 |  |  |  |  |  | NO
12 |  |  |  |  |  | NO
13 |  |  |  |  |  | NO
14
 |  | Total Price | 642
 |  | Discount
 |  | Delivery charges
 |  | Break-even quantity | 2
 |  | Total Price | 24076.5 |  |  |  | 0

Sheet: Equipment
 | Equipment
SL. No. | Name | Specifications | Price | Link | Offline | Ordered | Final | Alternate | Price
1 | Spot welder | DeWire 8000W | 6639 | Spot Welder (https://www.amazon.in/DeWire-Professional-Technology-0-1-0-3MM-Rechargable/dp/B0DVZDC2LQ) |  |  |  | Spot (https://www.spdcstore.in/product/31720575/LITHIUM-SPOT-WELDING-MACHINE---4KVA-BEST-PERFORMANCE) | 14000
2 | Hot air gun | 1500 W | 549 | Hot (https://makerbazar.in/products/myra-dual-temperature-hot-air-heat-gun-1500w-good-quality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)
3 | Metal cutter | 27 cm | 275 | Cutter (https://www.meesho.com/gadariya-king-heavy-duty-sheet-metal-hand-steel-cutting-tin-snips-scissors-cutters-metal-cutter/p/7g3ne6)
4 | Soldering iron | Adujustable 60W | 500 | Iron (https://www.amazon.in/Cloud-Soldering-Adjustable-Temperature-soldering/dp/B07X25JLCV)
5 | Solder, Flux. Wik | Combo | 81 | Combo (https://www.myinnovation.in/product-page/combo-ser-of-40grm-solder-wire-rill-desolder-wire-10grm-flux-set-best-quality)
6 | Tweezer | Generic | 30 | Tweezer (https://quartzcomponents.com/collections/all/products/precision-tweezers-standard-ts-10)
7 | Soldering tip cleaner | Sponge | 23 | CLeaner (https://quartzcomponents.com/products/soldering-bit-cleaner-foam-pad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)
8 | Multimeter | TH-M98 | 797 | Multimeter (https://www.amazon.in/Themisto-TH-M98-Digital-Multimeter-Counts/dp/B097RS212G)
9 | Crimper | AWG 23-10 | 382 | Crimper (https://roboticsdna.in/product/mini-type-self-adjustable-crimping-plier/)
10
11
12
 |  |  | 9276
