Ayusha343/battery-pack-engineering/3d Models/dummy_21700.stl

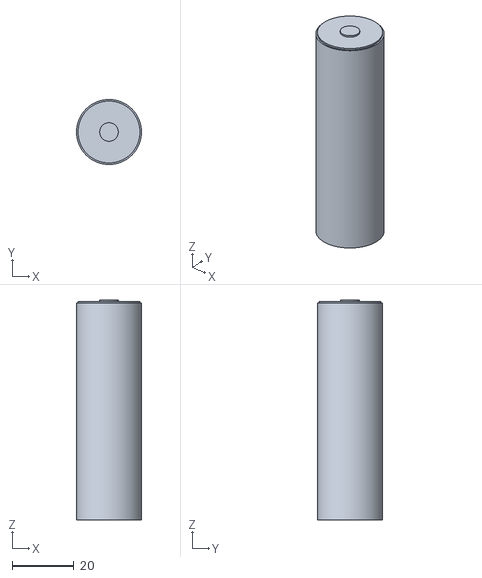
[picture p78: CAD file, 2026-09-14]
3d Models/dummy_21700.stl
21.0 x 21.0 x 71.0
