Ayusha343/battery-pack-engineering/3d Models/NMC 16s 35Ah.stl

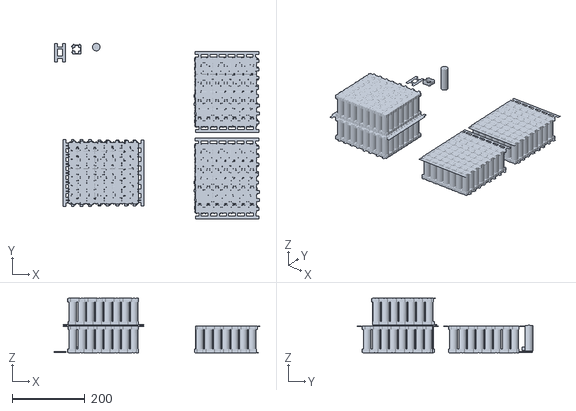
[picture p79: CAD file, 2026-09-14]
3d Models/NMC 16s 35Ah.stl
563.8 x 482.7 x 150.3
