Ayusha343/battery-pack-engineering/3d Models/32xx0 nickel H.stl

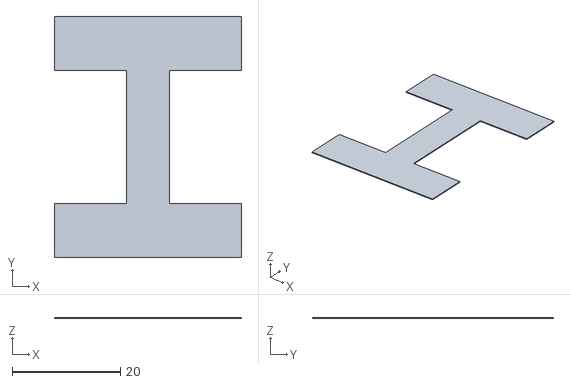
[picture p80: CAD file, 2026-09-14]
3d Models/32xx0 nickel H.stl
34.5 x 44.5 x 0.2
