Ayusha343/battery-pack-engineering/3d Models/IFR 32700-6Ah.STEP

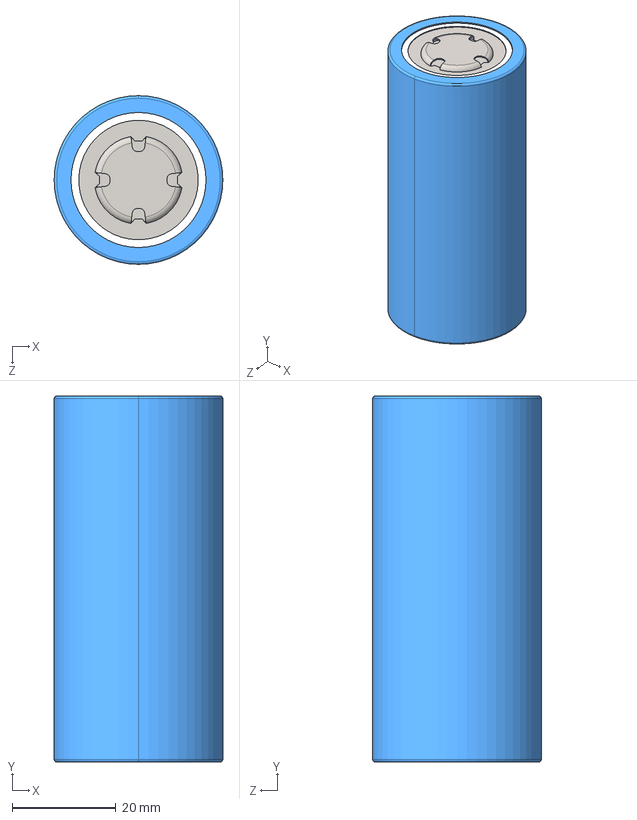
[picture p81: CAD file, 2026-09-14]
3d Models/IFR 32700-6Ah.STEP
32.5 x 70.5 x 32.5 mm
Copy of Body IFR 32700-6Ah^IFR 32700-6Ah
Copy of Part5^Copy of Litium Top_IFR 32700-6Ah
Copy of Part4^Copy of Litium Top_IFR 32700-6Ah
Copy of Part2^Copy of Litium Top_IFR 32700-6Ah
Copy of Part6^Copy of Litium Top_IFR 32700-6Ah
Copy of Part1^Copy of Litium Top_IFR 32700-6Ah
