Ayusha343/battery-pack-engineering/3d Models/60V 35Ah NMC Case.stl

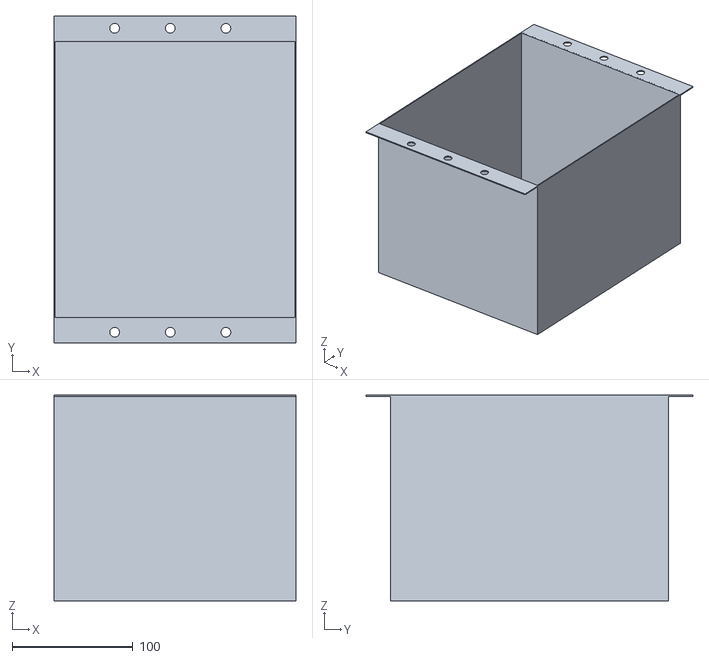
[picture p82: CAD file, 2026-09-14]
3d Models/60V 35Ah NMC Case.stl
200.0 x 270.1 x 170.0
