Ayusha343/battery-pack-engineering/3d Models/LFP 19s 30Ah.stl

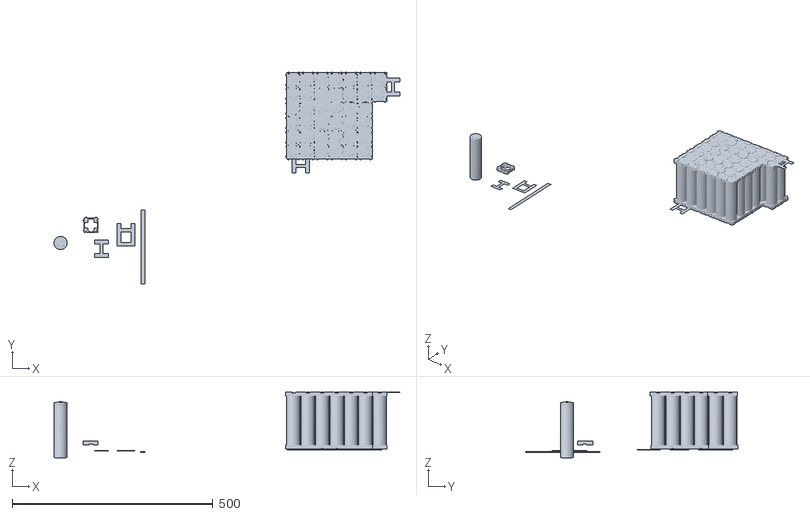
[picture p83: CAD file, 2026-09-14]
3d Models/LFP 19s 30Ah.stl
862.2 x 529.5 x 164.4
