Ayusha343/battery-pack-engineering/3d Models/32650_spacer.stl

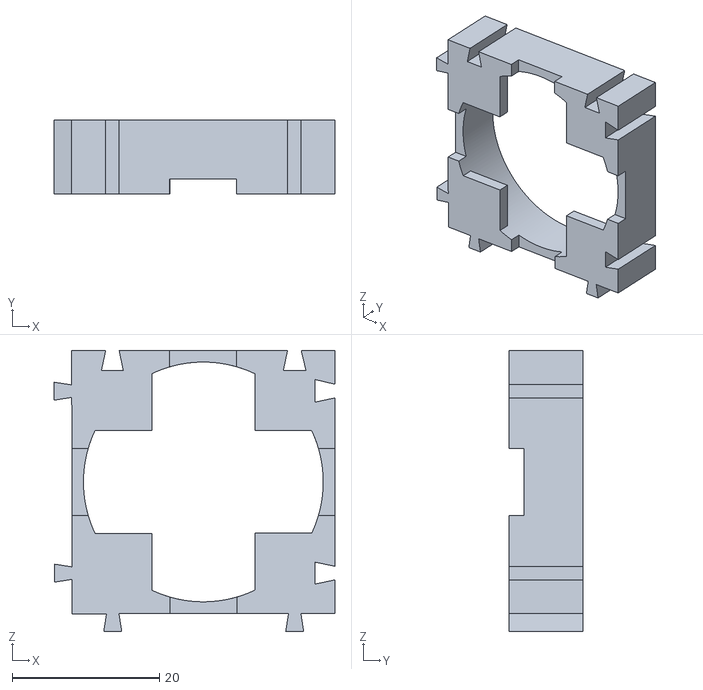
[picture p84: CAD file, 2026-09-14]
3d Models/32650_spacer.stl
38.2 x 10.00 x 38.2
