Ayusha343/battery-pack-engineering/3d Models/32140 Battery.step

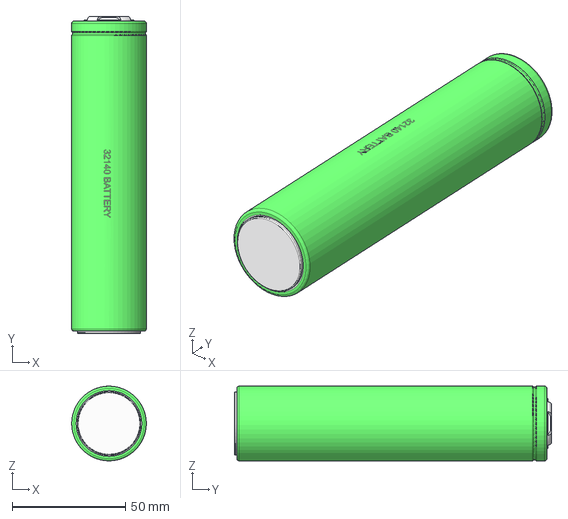
[picture p85: CAD file, 2026-09-14]
3d Models/32140 Battery.step
33.0 x 140.0 x 33.0 mm
