Ayusha343/battery-pack-engineering/3d Models/21700_holder.STL

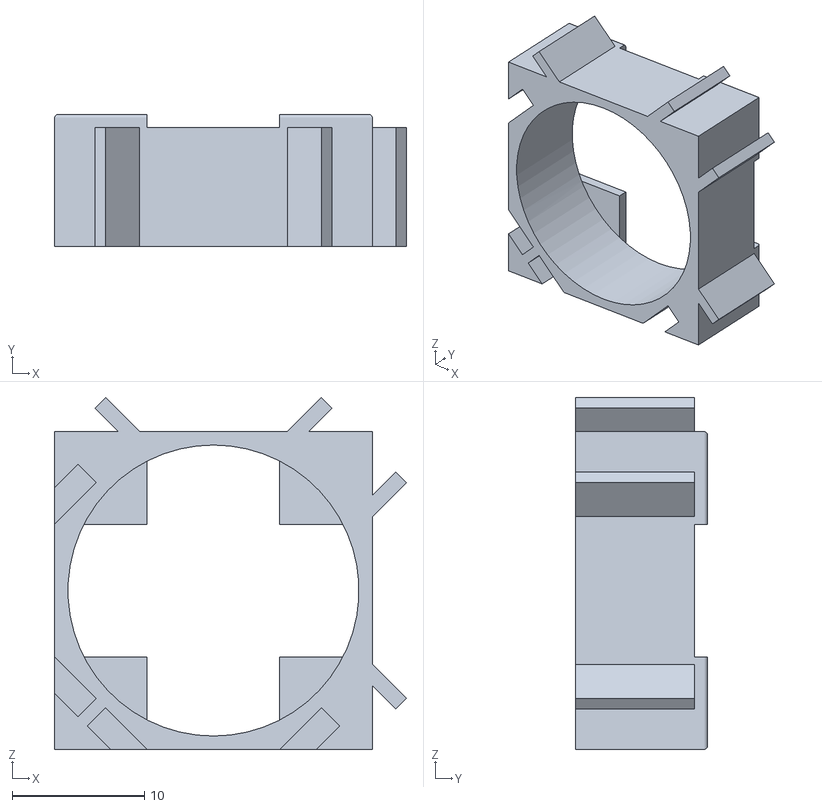
[picture p86: CAD file, 2026-09-14]
3d Models/21700_holder.STL
26.6 x 10.0 x 26.6
