Ayusha343/battery-pack-engineering/(list of files, cad)

Other CAD files:
3d Models/LFP 19s 18Ah.stl
3d Models/32140 Battery.stl
3d Models/IFR 32700-6Ah.stl
