Ayusha343/battery-pack-engineering/Docs/NMC 35Ah performance report.pptx

## NMC 16S 35Ah Pack

Battery pack performance report

## Slide 2

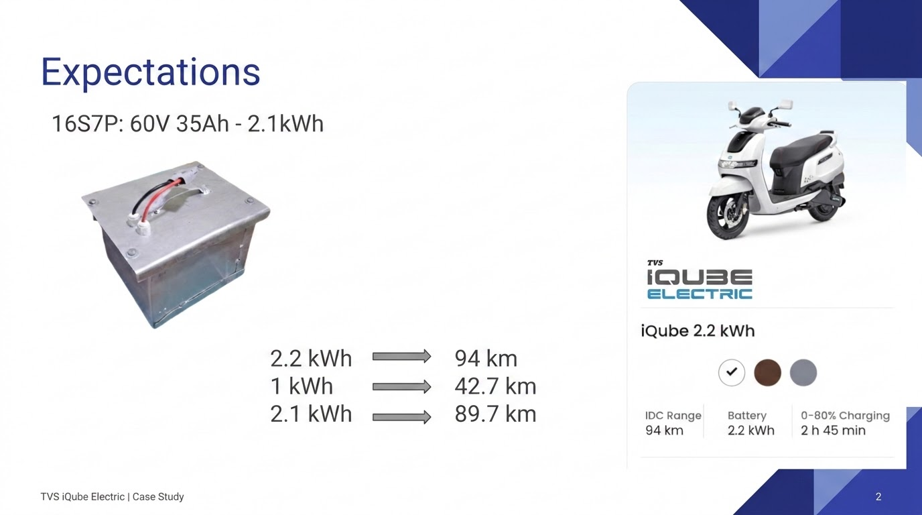
[picture p87: figure]
Beautify as image

## Slide 3

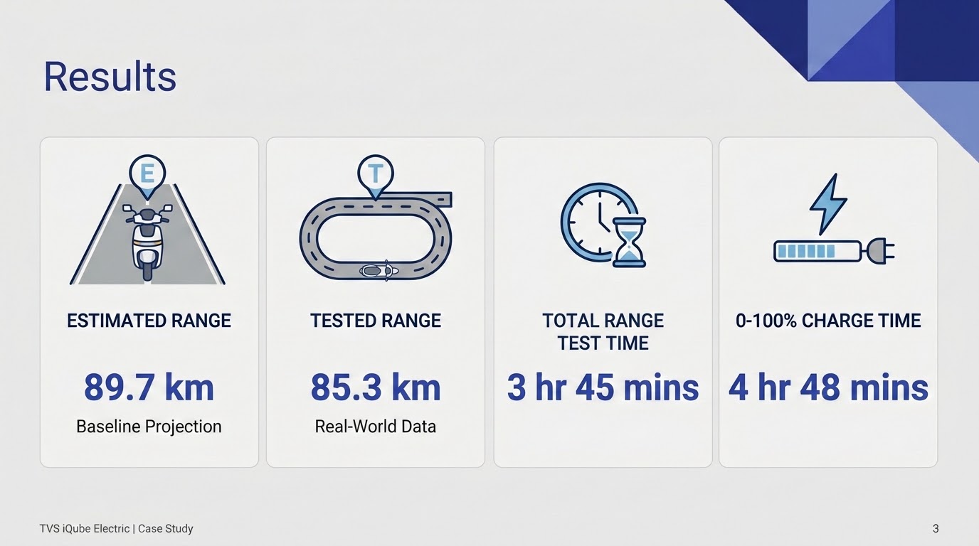
[picture p88: figure]
Beautify as image

## Slide 4


## Slide 5


## Slide 6


## Tiranga GEM review

- Inaccurate speedometer & odometer
- Soft suspension = bumpy ride
- No partial braking = less control
- Cruise control activates too early
- Seat tears itself by grab handle
- Uncomfortable for long legs

## Thank You

max growth
