Ayusha343/battery-pack-engineering/Docs/Energy Meter Problem.docx

DC Energy Meter

- Requirements:

A device to monitor Voltage and Current bidirectionally and store the data in a SD Card. Minimum specs: 100V 50~100A.

- Initial Solution:

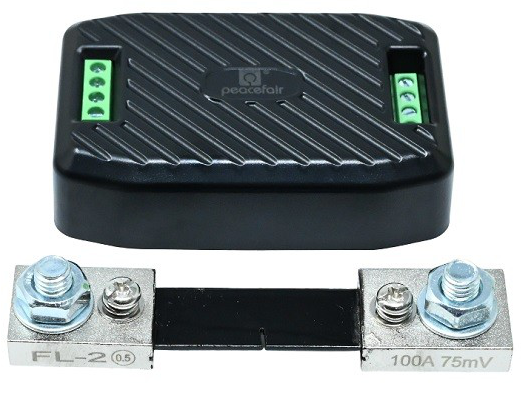
[picture p89: figure]
Thumbnail 3

IMPORTED FROM CHINA BY robu.in

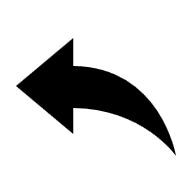
[picture p90: figure]
Back with solid fill

Peacefair PZEM-017 with 100A shunt resistor

- 0.05 - 300V
- 0.02 – 300A
- 1% accuracy

This system acts as a standalone DC energy logger and wireless dashboard. It measures high-power DC voltage and heavy current via an external 100A/75mV brass shunt using a PZEM-017 module. The PZEM-017 transmits measurement data via Modbus RTU over an RS485 bus, which an auto-flow converter translates into 3.3V serial signals. The ESP32-C3 SuperMini processes these metrics, simultaneously writing time-stamped .CSV logs onto a MicroSD card and hosting a local Wi-Fi web server to display real-time graphical graphs on a laptop or phone.

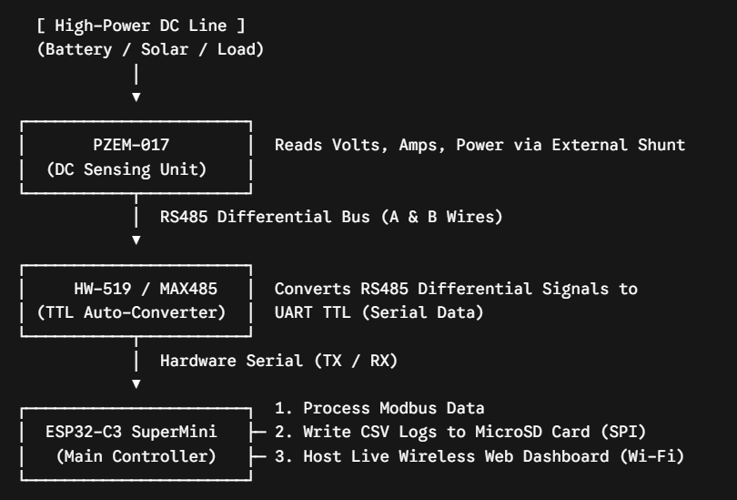
[picture p91: figure]

- Problem:

Imported from China by robu.in and all variants are sold out.

Kind-of expensive (900~5000+)

Requires TTL to RS485 converter to communicate through UART

- Proposed Solution:

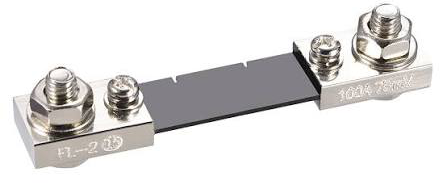
[picture p92: figure]
FL-19 Shunt Resistor 1500A 75mV – External DC Ammeter Shunt For Analog Panel Meters (0.5% Accuracy)
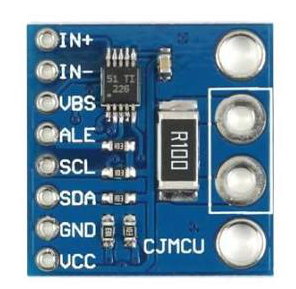
[picture p93: figure]
How to Use INA226: Pinouts, Specs, and Examples | Cirkit Designer
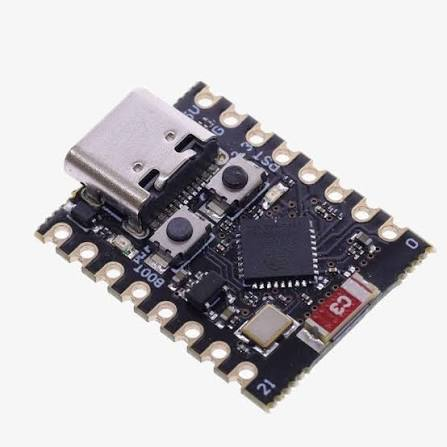
[picture p94: figure]
ESP32-C3 Super Mini Development Board - HW-466AB

This system serves as a standalone DC energy logger and wireless dashboard. High system current passes through an external 100A/75mV brass shunt, generating a millivolt drop measured by an INA226 module (with its onboard resistor removed). A 0.1% precision voltage divider scales pack voltages ( 0--60V ) down to safe levels for the INA226. The INA226 sends 16-bit measurements over I^2 C to an ESP32-C3 SuperMini, which scales the values back, writes timestamped .CSV logs to a MicroSD card via SPI, and hosts a Wi-Fi server displaying real-time graphical data on a laptop or phone.

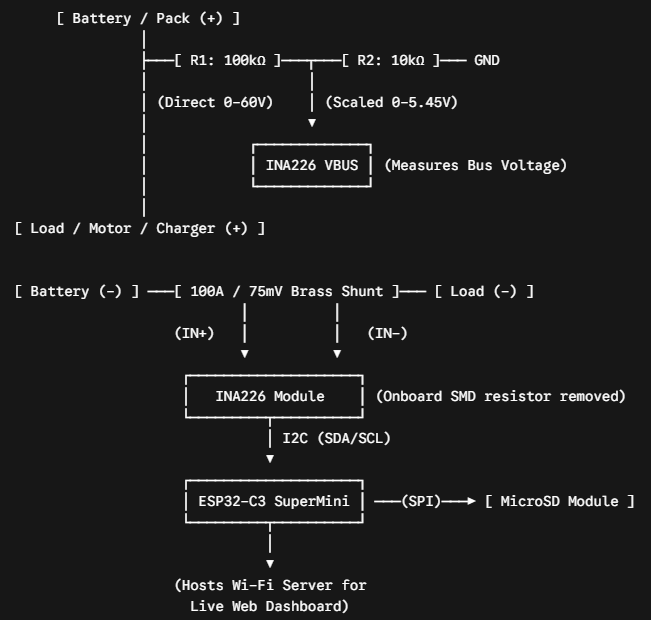
[picture p95: figure]
