Ayusha343/battery-pack-engineering/Docs/EV Scooter battery pack  - Printable.pdf

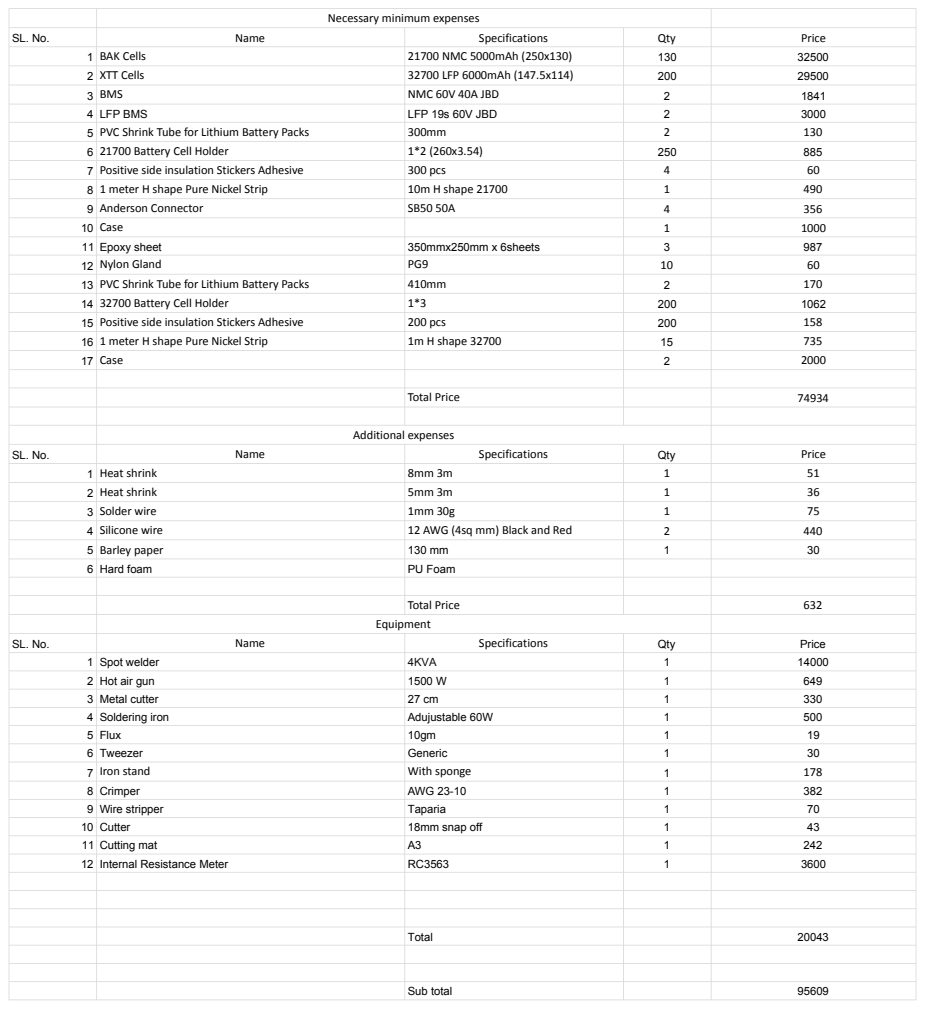
[picture p96: page 1]
Name; Specifications; Qty; Price; 1 BAK Cells; 21700 NMC 5000mAh (250x130); 2 XTT Cells; 32700 LFP 6000mAh (147.5x114); 3 BMS; NMC 60V 40A JBD; 4 LFP BMS; LFP 19s 60V JBD; 5 PVC Shrink Tube for Lithium Battery Packs; 6 21700 Battery Cell Holder; 7 Positive side insulation Stickers Adhesive; 300 pcs; 8 1 meter H shape Pure Nickel Strip; 10m H shape 21700; 9 Anderson Connector; 10 Case; 11 Epoxy sheet; 350mmx250mm x 6sheets; 12 Nylon Gland; 13 PVC Shrink Tube for Lithium Battery Packs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

Necessary minimum expenses
