Ayusha343/battery-pack-engineering/(commit log)

2026-09-14 Initial commit: clean battery pack documentation
    [21700_holder.STL, 32140 Battery.step, 32140 Battery.stl, 32650_spacer.stl, 32xx0 nickel H.stl, 60V 35Ah NMC Case.stl, DLOK battery pack.xlsx, DLOK internship.xlsx]
2026-10-17 Add techincal roadmap ppt and Energy meter doc
    [DLOK internship.xlsx, Gantt Chart.xlsx]
