Ayusha343/battery-pack-engineering/Media/20260722_134419.jpg

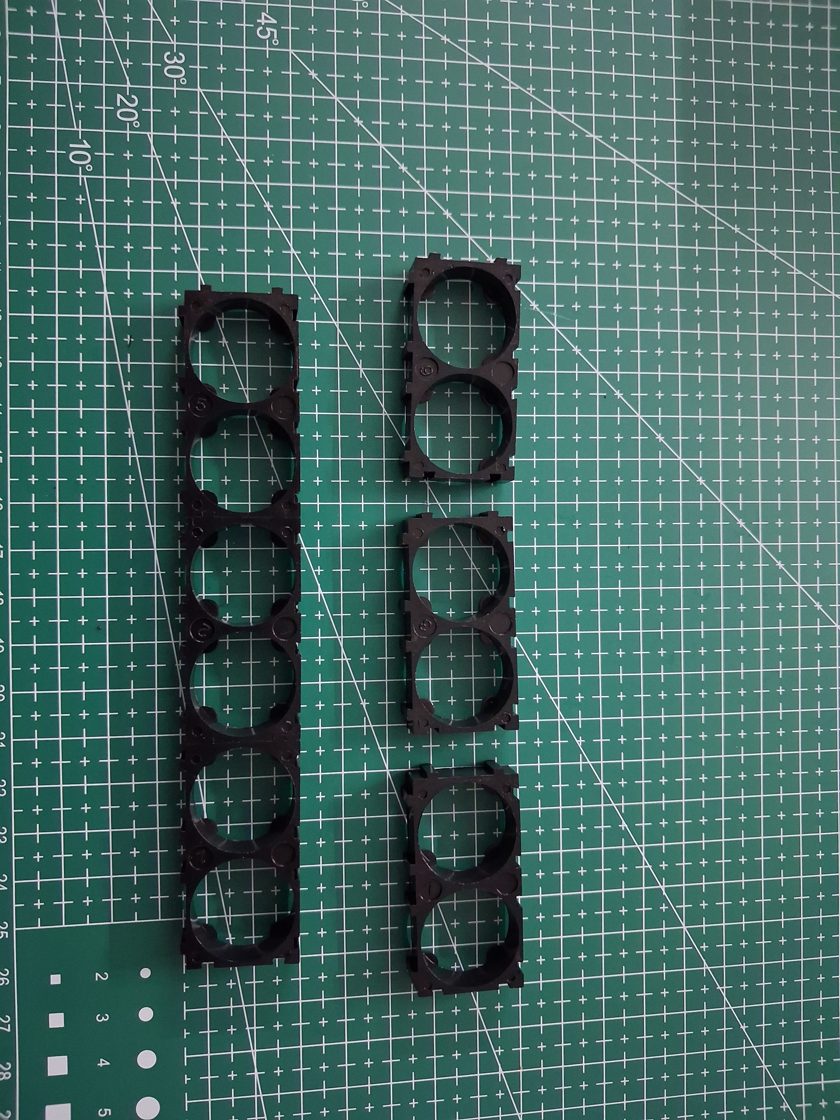
Media/20260722_134419.jpg
