Ayusha343/battery-pack-engineering/Media/20260722_135603.jpg

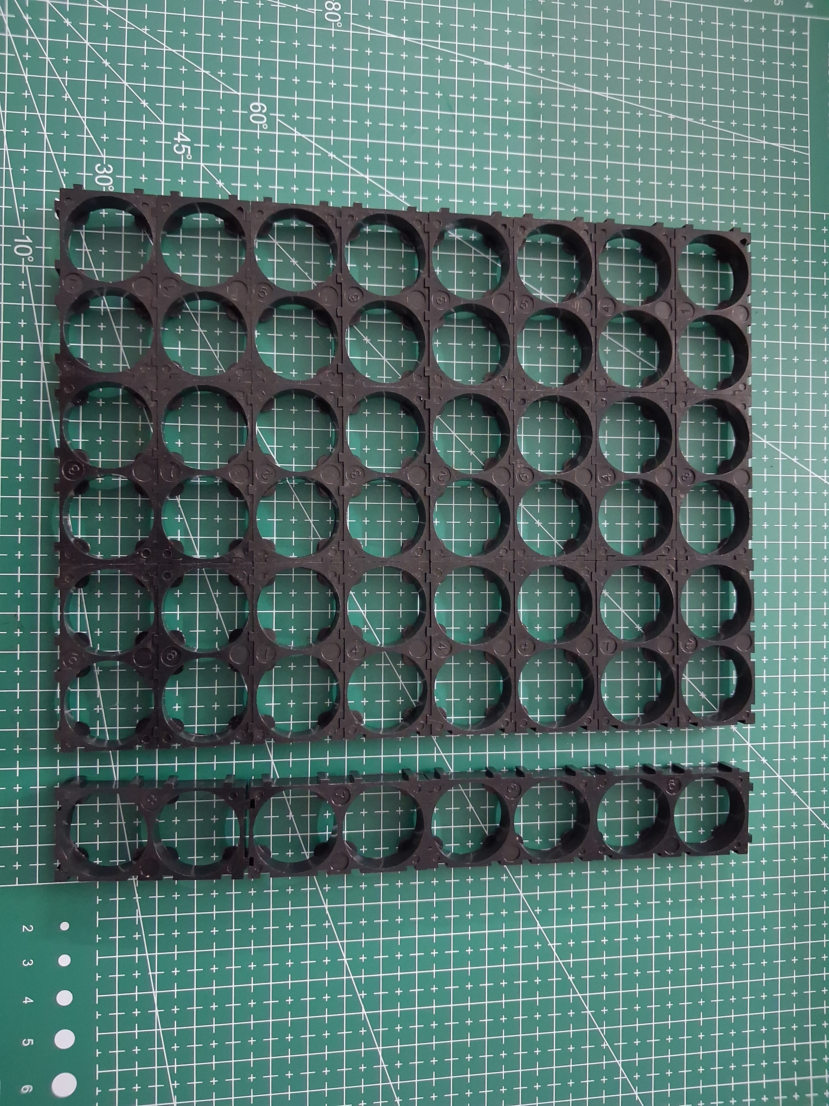
Media/20260722_135603.jpg
