Ayusha343/battery-pack-engineering/Media/20260722_135629.jpg

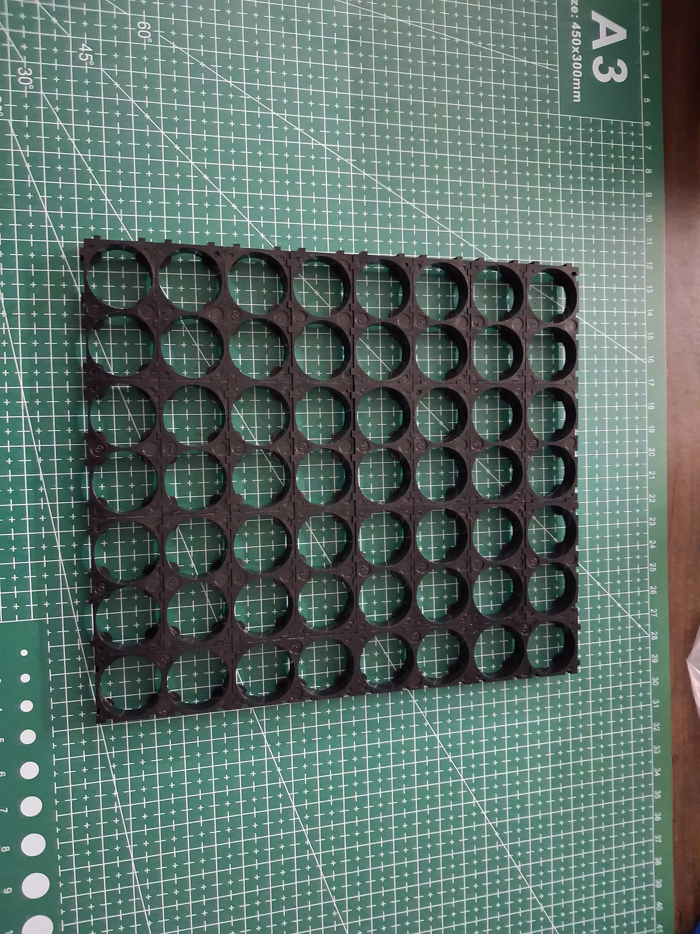
Media/20260722_135629.jpg
