Ayusha343/battery-pack-engineering/Media/20260728_140943.jpg

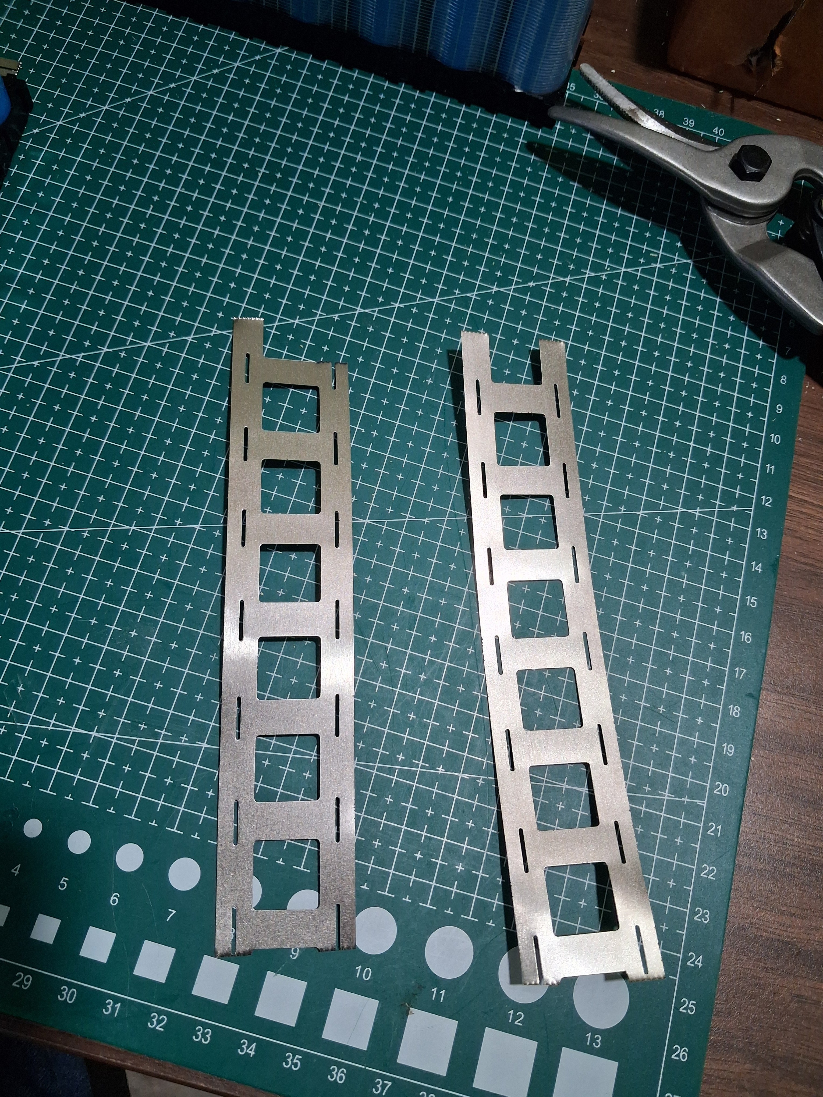
Media/20260728_140943.jpg
