Ayusha343/battery-pack-engineering/Media/20260730_125114.jpg

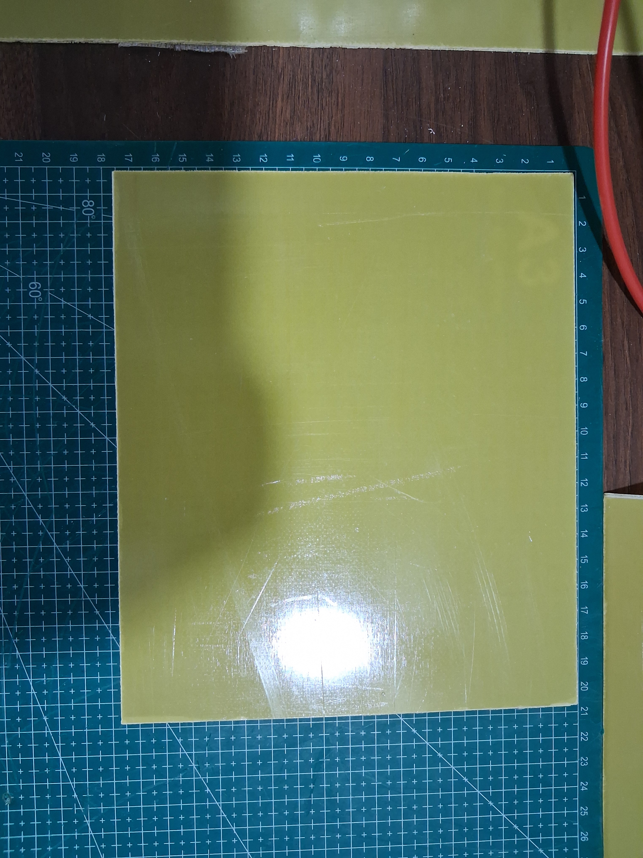
Media/20260730_125114.jpg
