Ayusha343/battery-pack-engineering/Media/20260730_125125.jpg

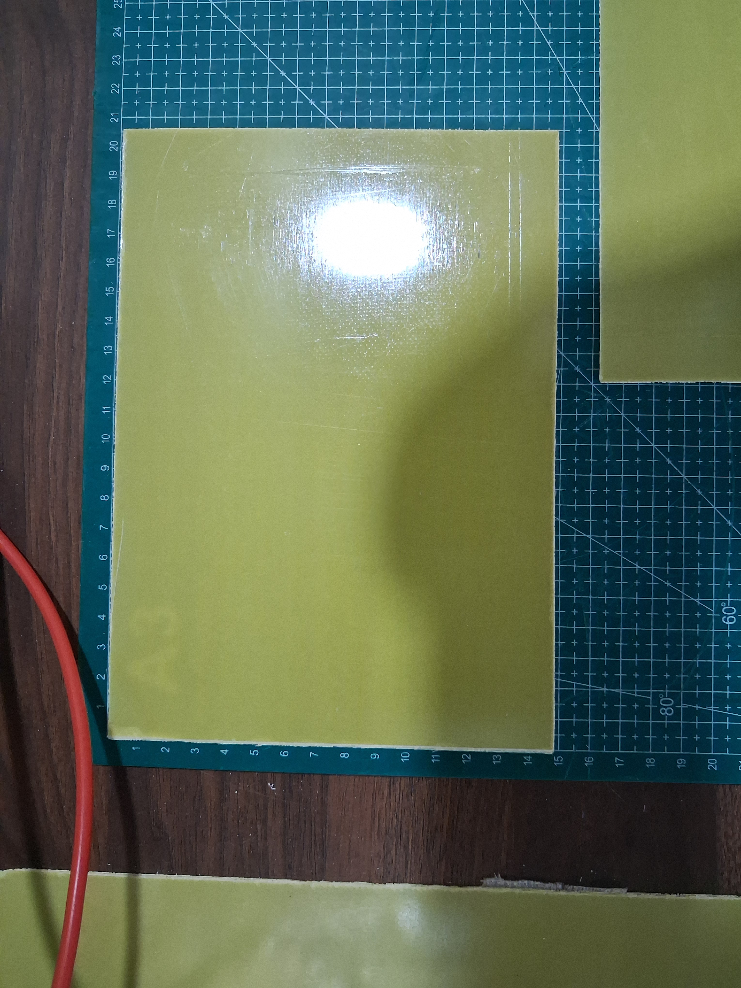
Media/20260730_125125.jpg
