Ayusha343/battery-pack-engineering/Media/20260730_125141.jpg

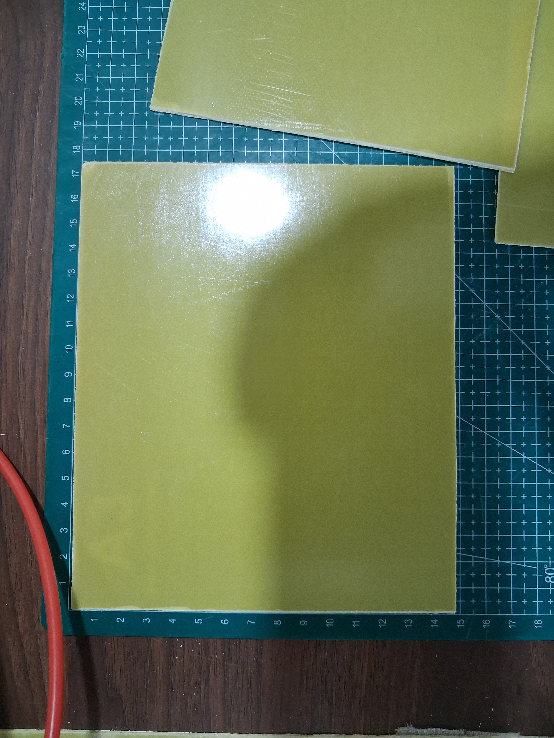
Media/20260730_125141.jpg
