Ayusha343/battery-pack-engineering/Media/20260730_131910.jpg

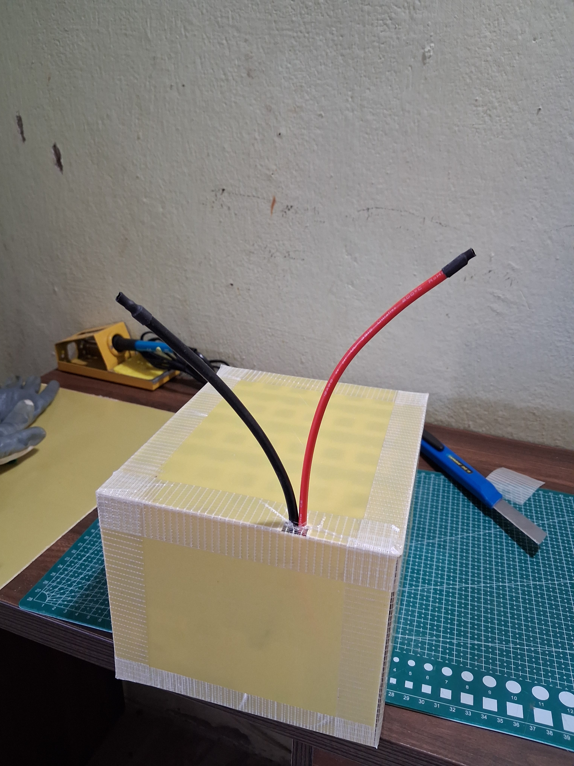
Media/20260730_131910.jpg
