Ayusha343/battery-pack-engineering/Media/20260730_132120.jpg

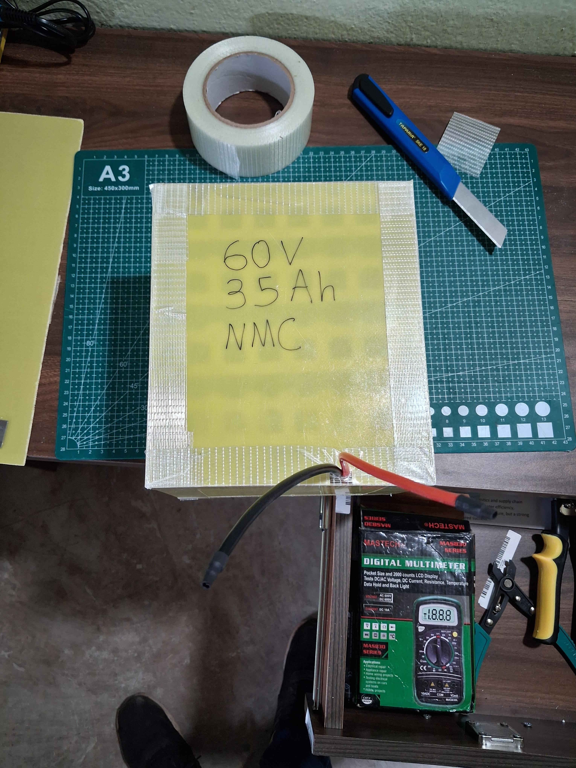
Media/20260730_132120.jpg
