Ayusha343/battery-pack-engineering/Media/20260804_114247.jpg

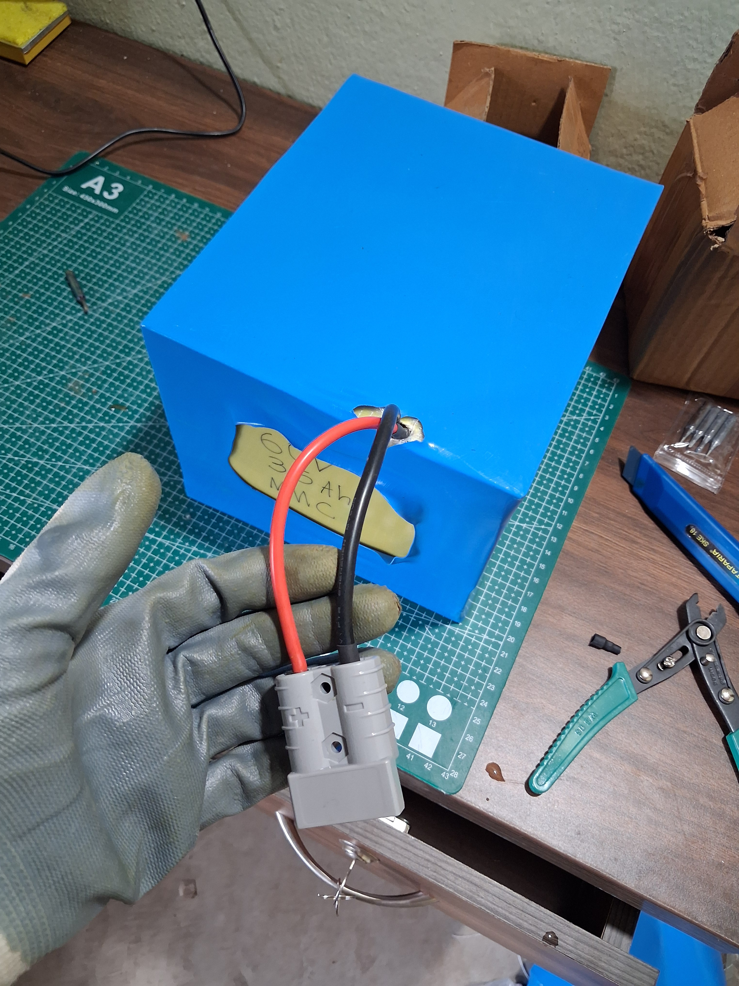
Media/20260804_114247.jpg
