Ayusha343/battery-pack-engineering/Media/20260807_112025.jpg

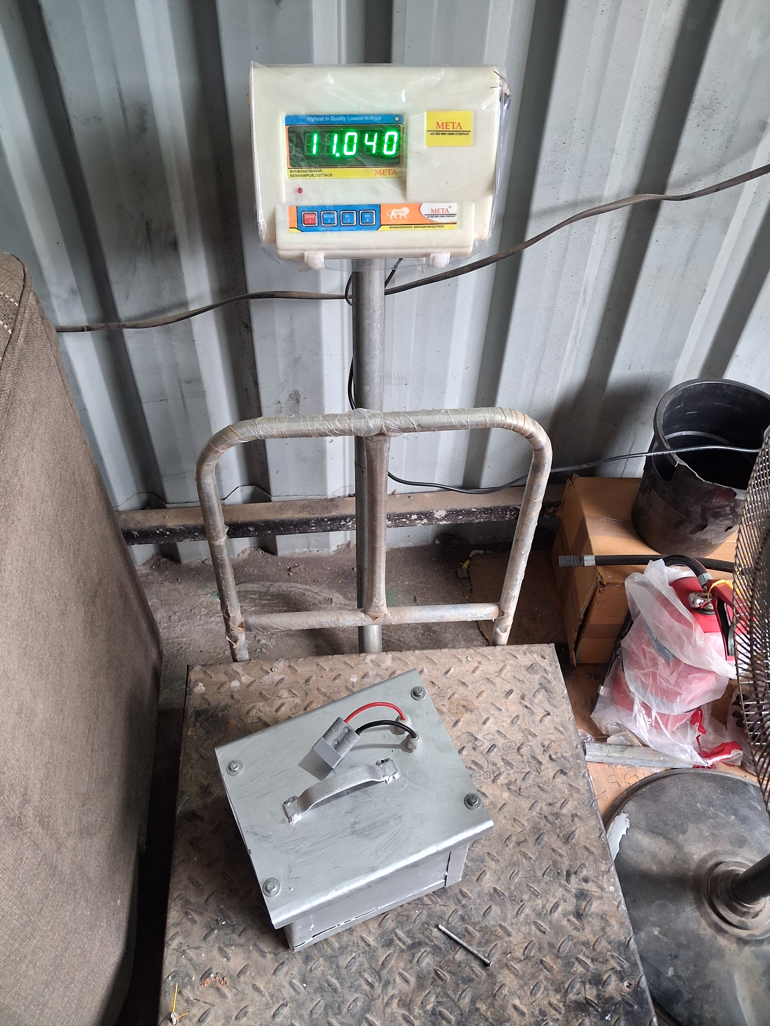
Media/20260807_112025.jpg
