Ayusha343/battery-pack-engineering/Media/20260808_125656.jpg

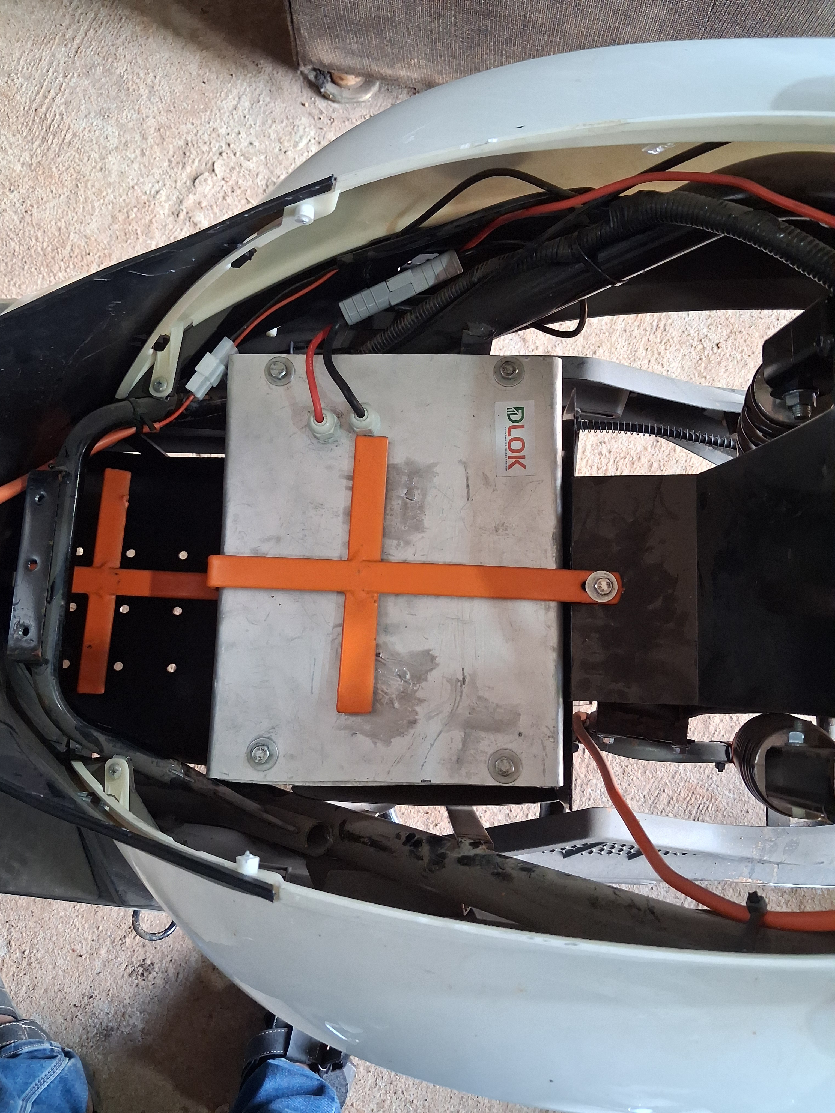
Media/20260808_125656.jpg
