Ayusha343/battery-pack-engineering/Media/20260907_125613.jpg

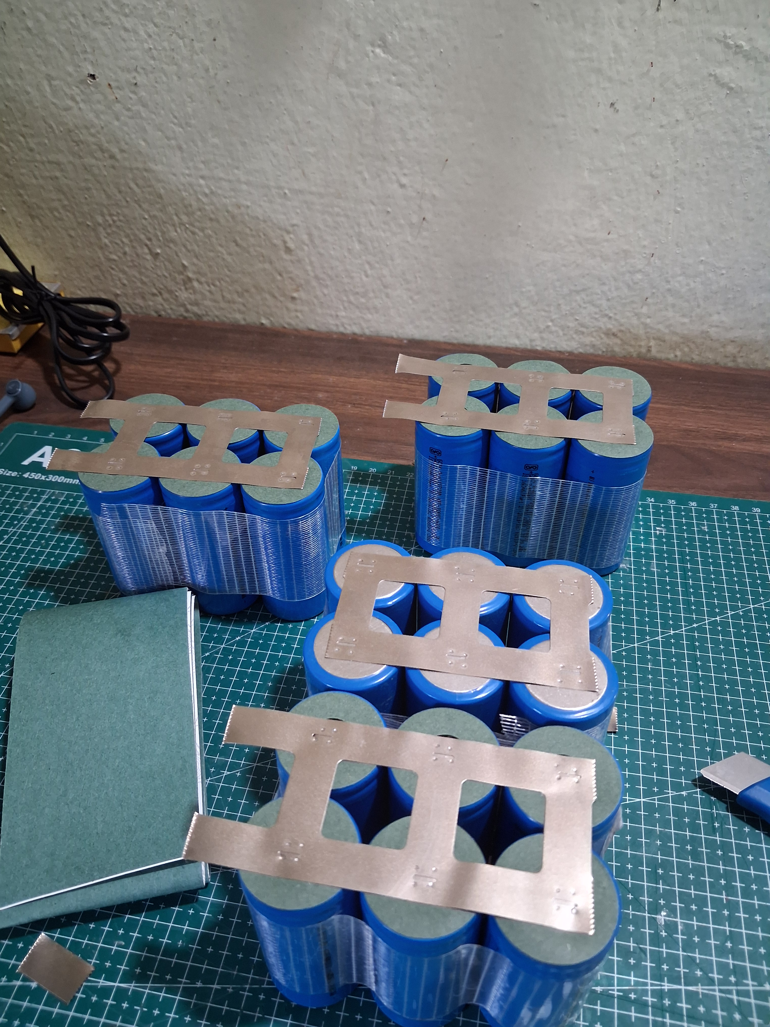
Media/20260907_125613.jpg
