Ayusha343/battery-pack-engineering/Media/20260907_131254.jpg

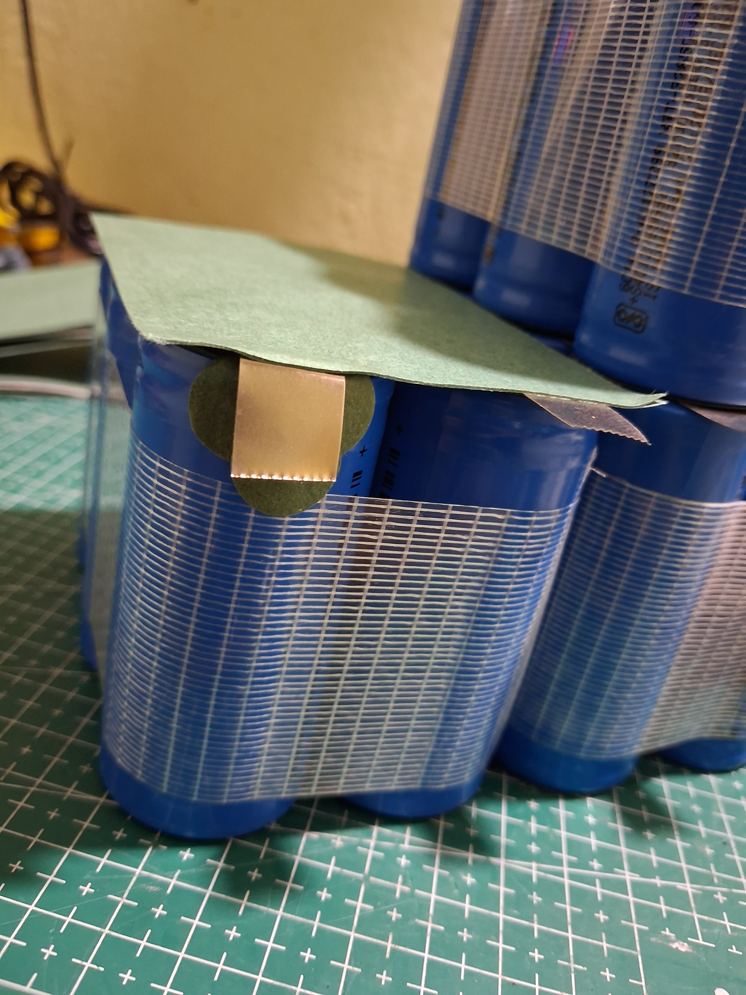
Media/20260907_131254.jpg
