Ayusha343/battery-pack-engineering/Media/20260910_123529.jpg

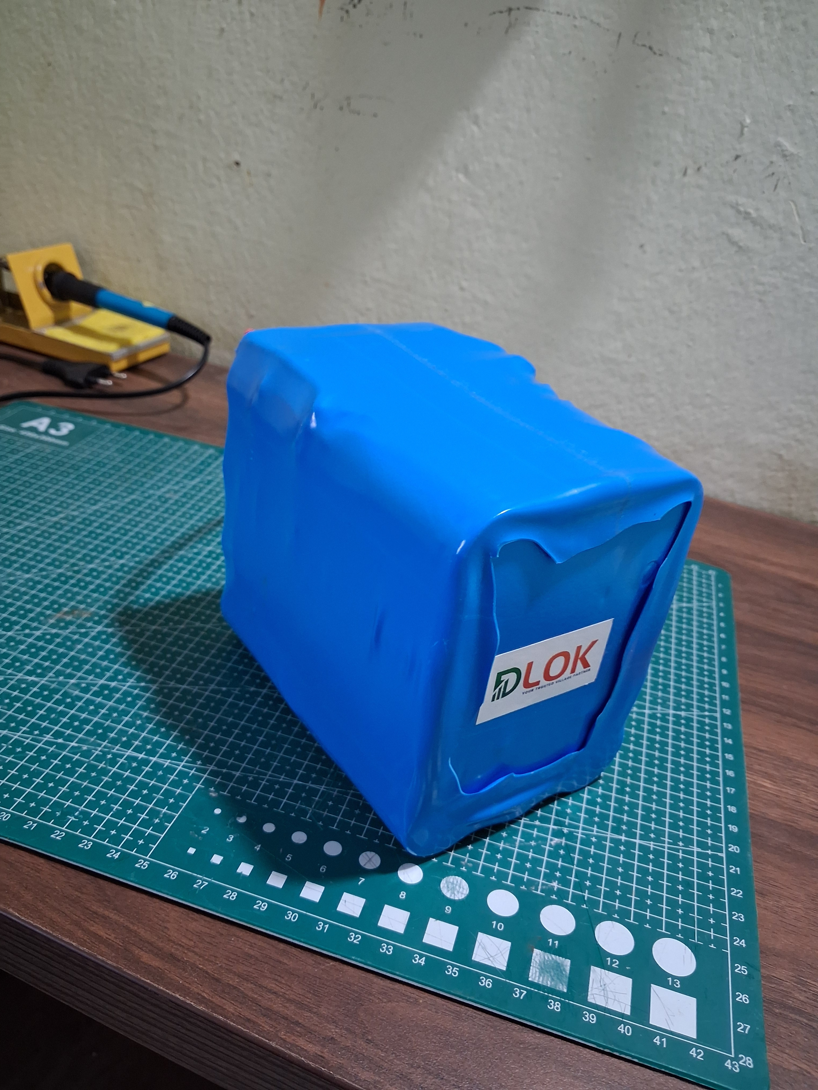
Media/20260910_123529.jpg
